DrBalf/domotique_bts_sn_ec_projet/Rapport/img/presentation1.jpg

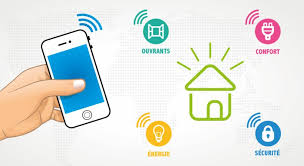
Rapport/img/presentation1.jpg
