DrBalf/domotique_bts_sn_ec_projet/Rapport/Lore/img/maison-bois-domotique.jpg

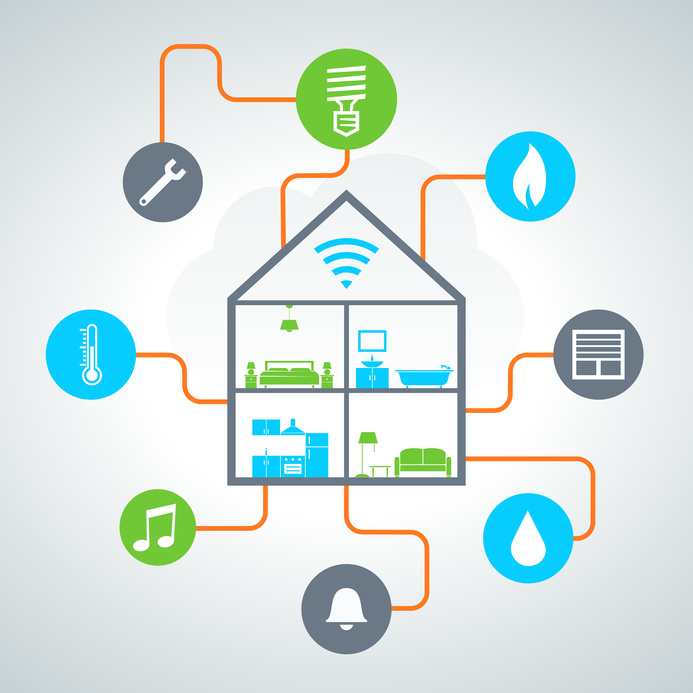
Rapport/Lore/img/maison-bois-domotique.jpg
