DrBalf/domotique_bts_sn_ec_projet/README.md

# domotique_bts_sn_ec_projet
projet d'épreuve final pour le bts système numérique, option : Electronique et communication  

contributeur : Benjamin Guyader - Nicolas Dufresne - Tommy Girard - Aurélien Chauveau
