DrBalf/domotique_bts_sn_ec_projet/Documentation/Seeed-WiKi-master/docs/BeagleBone.md

---
title: BeagleBone Introduction
nointro:
---

---
BeagleBones are relatively a late comer in the microcontroller world, but the high performance and lower power consumption make it become one of the three popular platforms in the open-hardware world. Beagles mean big functionality in small packages because these little PCs can be used for all kinds of applications you've been tinkering with... and can handle many of the same tasks as your desktop PC. Similar to Arduino and Raspberry Pi, Beaglebone boards are used by artists, designers and hobbyists to realize their projects.

BeagleBone boards are wonderful boards, but people on planet Seeed are not satisfied with the current Beaglebone and want to make some differences. Just as what we have done with Seeeduino, we spoke to Beaglebone.org about our thoughts and finally got the chance to create a whole new board together with them, this is how we created Seeed Studio's own Beaglebone, the Beaglebone Green(Short as BBG).

BeagleBone Green is dirived from Beaglebone Black(Short as BBB), if you ever know about BBB , you would know that BBB is like the star board in the beagleboard family, it inherits the tiny size of Beaglebone and adds many good features while the price is much lower. When we were designing BBG, we decided to keep almost all the good features of BBB such as the tiny size, abundant interface and strong expansibility, while at the same time replaced the HDMI interface with 2 Seeed grove connector, to make it compatible with the large family of grove sensers.

Not lone afte that, we released another BeagleBone named BeagleBone Green Wireless(Short as BBGW), In addition to grove connectors, BBGW has included a high-performance flexible WiFi/Bluetooth interface, makes it become the first WiFi/Bluetooth board of the BeagleBone family.

## Product  List
---
Here is the list of the BeagleBone Boards you can find in the Seeed WiKi. The list will be constantly updated.

- [Beagle Bone Green and Grove IoT Starter Kit Powered by AWS](/Beagle_Bone_Green_and_Grove_IoT_Starter_Kit_Powered_by_AWS/)
- [BeagleBone Case](/Beaglebone_Case/)
- [BeagleBone Green](/BeagleBone_Green/)
- [BeagleBone Green HDMI Cape](/BeagleBone_Green_HDMI_Cape/)
- [BeagleBone Green Wireless](/BeagleBone_Green_Wireless/)
- [Grove Base Cape for BeagleBone v2](/Grove_Base_Cape_for_BeagleBone_v2/)
- [Grove Cape for BeagleBone Series](/Grove_Cape_for_BeagleBone_Series/)
- [Grove Starter Kit for BeagleBone Green](/Grove_Starter_Kit_for_BeagleBone_Green/)
- [Motor Bridge Cape v1.0](/Motor_Bridge_Cape_v1.0/)
- [Skeleton box for Beaglebone](/Skeleton_box_for_Beaglebone/)
