DrBalf/domotique_bts_sn_ec_projet/Rapport/Benjamin/ProjetBenjaminGuyader.docx

Lycée Raymond Queneau, BTS SN EC.

18

Rapport

Projet final de BTS

Guyader Benjamin

# Présentation de ma partie

Dans le projet "La maison du futur", nous pouvons relever trois différentes parties

- Le serveur web (étudiant 4)

- l'application mobile (étudiant 3)

- Les capteurs et actionneurs (étudiants 1 et 2) :


tant l'étudiant 1, mon travail se séparait en deux parties :

- Pilotage des volets ainsi que de la lumières :

- Volets Roulants / Capteur de luminosité

- Ampoule

- Mise en place de la sécurité :

- Détecteur d'incendie

-Détecteur de mouvement / Interrupteur

- Module GSM

# Test unitaire : Volet roulant

De plus en plus de maisons sont équipées de volets roulants, c'est le cas de notre maquette. Il est possible de les piloter via la tablette ou grâce aux boutons présents sur la carte.

Dans un premier temps à l'aide d'un schéma de la carte électronique du volet roulant j'ai recherché les broches utiles pour son usage dans notre projet :

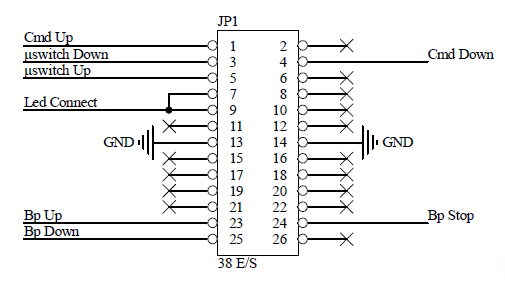
[picture p77: figure]

Sur ce schéma j'ai fais apparaître uniquement les broches de la carte que j'utilise dans le projet.

Ces broches sont les suivantes :

- cmdUP : Broche qui permet la montée des volets lorsqu'elle est à un niveau logique HAUT (5V).
- CmdDown : Broche qui permet la descente des volets lorsqu'elle est à un niveau logique HAUT (5V).
- µswitchUP : Cette broche a un niveau BAS lorsque le volet arrive en fin de course vers le haut.
- µswitchDown : Cette broche passe à un niveau BAS lorsque le volet arrive en fin de course vers le bas
- GND

Pour comprendre le fonctionnement des broche µswitchUP et µswitchDown, j'ai utilisé un voltmètre pour déterminer leurs états en fonction de la position du volet pour pouvoir adapter mon code :

J'ai relié toute ces broches sur celles numériques d'une carte Arduino uno.

Pour vérifier le bon fonctionnement de ces volets, j'ai fais un programme qui permet que, lorsque l'on envoie "1" sur le moniteur série Arduino, le volet s'ouvre et, lorsque l'on envoie "2", le volet se ferme.

Ce test sur les volets roulants m'a permis de vérifier leurs bons états de marche mais également de comprendre le fonctionnement de la carte électronique.

# Test unitaire : capteur de luminosité

Pour faciliter la vie de l'utilisateur, un mode automatique est ajouté aux volets Roulants. Ces derniers seront influencés par un capteur de luminosité.

Le capteur TSL2561 a une plage de mesure allant de 0,1 à 40 000 lux, il est également adapté à un positionnement extérieur grâce à sa plage de température qui supporte un grand froid de -30 °C à une température chaude de 80 °C.

La communication avec ce capteur se fait en I2C, donc à l'aide de 3 fils : le SDA, le SCL et le GND. Pour le fonctionnement de ce capteur, 4 fils étaient donc nécessaires. Pour ma part, c'est le seul module qui doit être alimenté en 3,3 V.

Pour vérifier son bon fonctionnement, j'ai récupéré une bibliothèque sur GITHUB et j'ai fais un programme qui permet simplement de récupérer la luminosité en lux chaque secondes.

# Test d'intégration : Volet roulant / capteur de luminosité

Ce regroupement à pour but de tester le volet roulant lorsqu'il est en mode automatique, c'est à dire que lorsqu'on passe au-dessus d'un certain seuil de luminosité (35 lux pour le test) le volet s'ouvre :

Et à l'inverse si on descend en dessous d'un certain seuil (10 lux pour le test), le volet se ferme :

# Test unitaire : Lumière

L'application mobile ne pilote pas uniquement les volets roulants, deux boutons sont affectés à la gestion de la lumière.

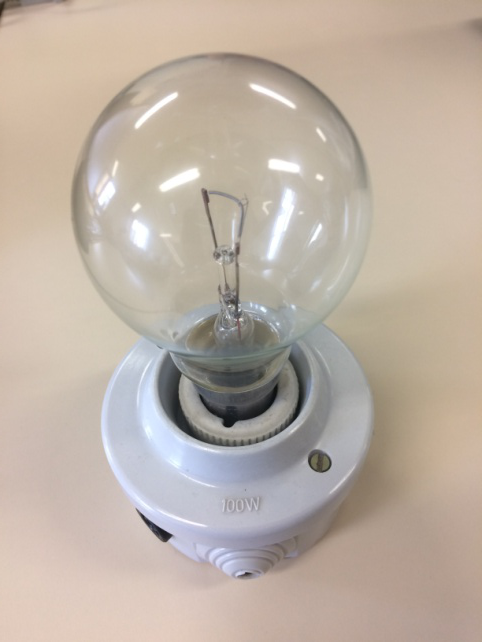
[picture p78: figure]

Il n'est pas possible de piloter une lumière avec une carte Arduino directement. Pour pouvoir piloter le faire, il faut utiliser un relais qui va nous permettre de dissocier la partie puissance de la partie commande.

Le schéma ci-dessous montre la composition du relais ainsi que son branchement avec la lumière et le microcontrôleur.

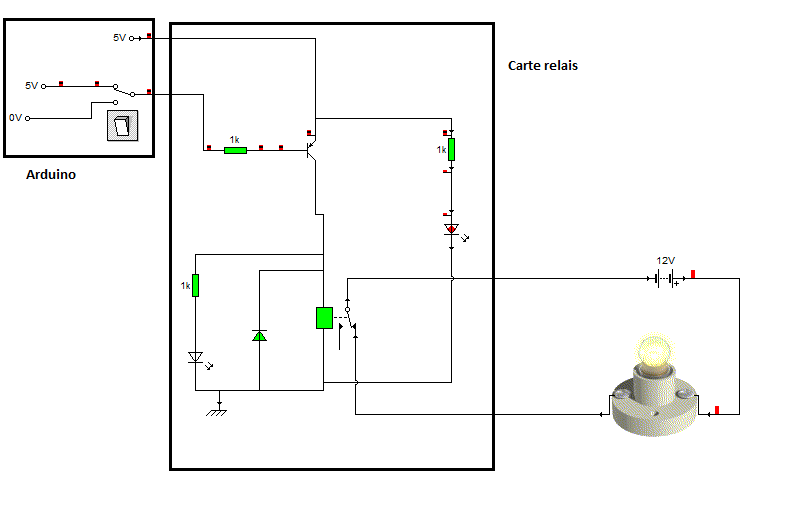
[picture p79: figure]

Pour que la lumière soit allumée

- On doit avoir du courant dans la bobine

- Le transistor doit être passant

- On doit donc appliquer 1 sur la sortie de la Arduino

# Test unitaire : Détecteur de mouvement

Lorsque l'utilisateur n'est pas chez lui, il doit être averti en cas d'intrusion. C'est pour cela que le système de sécurité est muni d'un détecteur de mouvement.

ce détecteur est constitué d'un capteur à infrarouge détectant les mouvement d'une personne ou d'un animal. Il a un angle de détection de 120° et sa distance de détection va jusqu'à 6 mètres.

Trois broche le font fonctionner :

- Une alimentation de 5V qui permet un branchement facile sur une carte Arduino.
- Une broche de donnée que l'on pourra brancher en entrée numérique sur une carte Arduino.
- GND

Pour tester le bon fonctionnement de ce capteur j'ai d'abord effectué le branchement sur une carte Arduino Uno.

J'ai ensuite créé une fonction retournant un booléen permettant de récupérer l'état de la broche de donnée.

J'ai affiché sur le moniteur série la valeur de retour de la fonction :

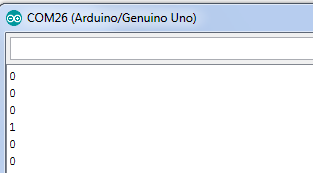
[picture p80: figure]

Lorsqu'un mouvement est détecté, la fonction renvoie bien "true".

# Test d'intégration : Interrupteur / détecteur de mouvement

L'utilisateur doit évidemment pouvoir désactiver le détecteur lorsqu'il est chez lui, c'est pour cela que l'on ajoute un interrupteur. Pour ce projet, un simple bouton fait office d'interrupteur :

C'est un bouton poussoir momentané, lorsqu'il est pressé il émet un signal HIGH et lorsqu'il est n'est pas pressé LOW. Pour pouvoir l'utiliser dans notre projet il y aura quelque particularité dans le code, il faudra utiliser une interruption.

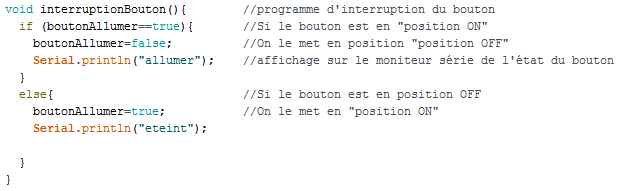
[picture p81: figure]

Pour utiliser une interruption on ne peut pas se mettre sur n'importe quelle broche. Sur une carte UNO, uniquement 2 broches permettent d'utiliser l'interruption : la 2 et la 3.

J'ai regroupé le code de l'interrupteur avec celui du détecteur de mouvement puis j'ai effectué le branchement :

Lorsque l'on appuie sur le bouton on active ou on désactive l'alarme en ajoutant simplement une condition devant le message de détection :

# Test unitaire : Détecteur d'incendie

Le système de sécurité comprend également un détecteur de fumée qui est constamment en marche contrairement au détecteur de mouvement.

Le principe du fonctionnement de ce capteur est basé sur une transmission infrarouge entre une diode et une photodiode. Si de la fumée passe entre l'émetteur et le récepteur, cela va créer de l'opacité qui va atténuer le signal reçu par la photodiode.

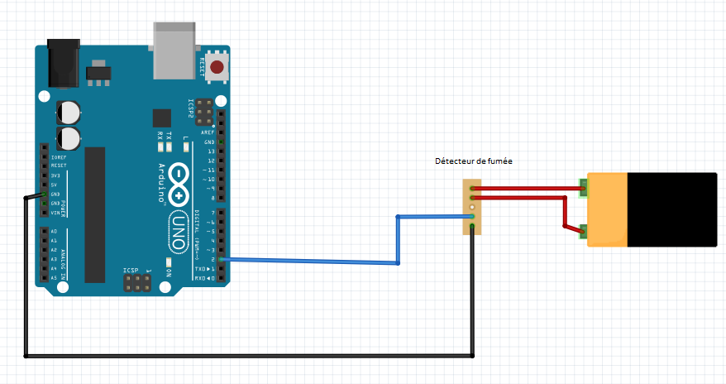
[picture p82: figure]

# Test unitaire : Module GSM

Le module GSM permet d'envoyer un message à l'utilisateur en cas de détection d'incendie ou d'intrusion.

Avant de pouvoir tester son fonctionnement, nous avons acheté une carte SIM prépayé chez Lebara Mobile qui convient bien pour son utilisation dans le projet.

J'ai dans un premier temps envoyer différentes commande à l'aide du moniteur série Arduino.

J'ai vérifié la présence de réseau avec la commande AT+CREG?.

Avant de préparer un SMS il y a deux commandes AT à rentrer :

- AT+CMGF=1 Pour passer en mode texte.

- AT+CSCA="+33660003000" L'adresse du serveur qui dans notre cas est celle de Bouygues.

Après avoir rentrer le numéro du destinataire (AT+CMGS="numéro").

Après avoir rentré cette commande il faut écrire le message et terminé par un "CTRL+Z" or sur le moniteur série on ne peut pas.

Pour pouvoir envoyer un message, il nous faut donc un code qui rentre automatiquement les commandes AT nécessaire :

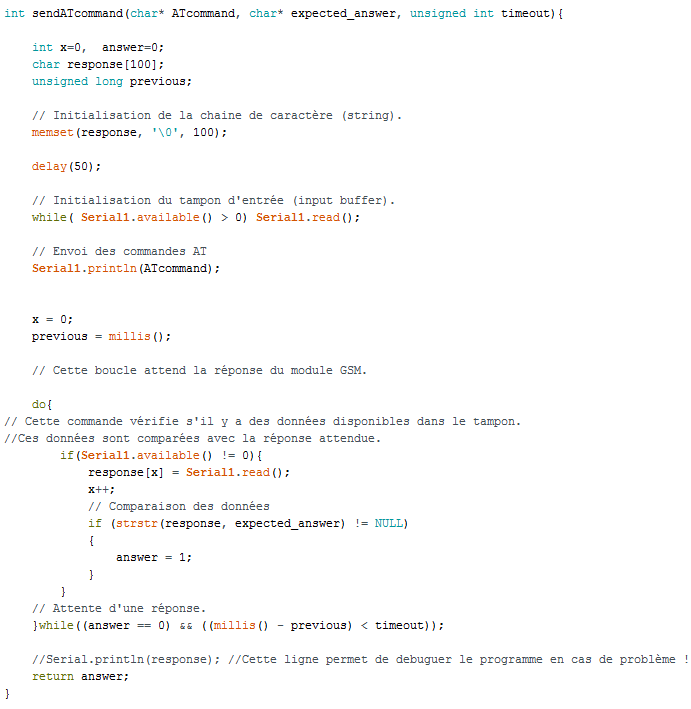
[picture p83: figure]
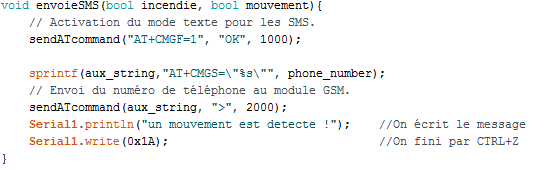
[picture p84: figure]

# Test d'intégration : Module GSM / Interrupteur / détecteur de mouvement / Détecteur d'incendie

Dans ce regroupement on va retrouver tout les composant qui constitue la partie sécurité, le module GSM permet d'envoyer un SMS dans le cas où le détecteur de mouvement (si il est en marche selon l'état du bouton) ou le détecteur d'incendie prévient un danger.

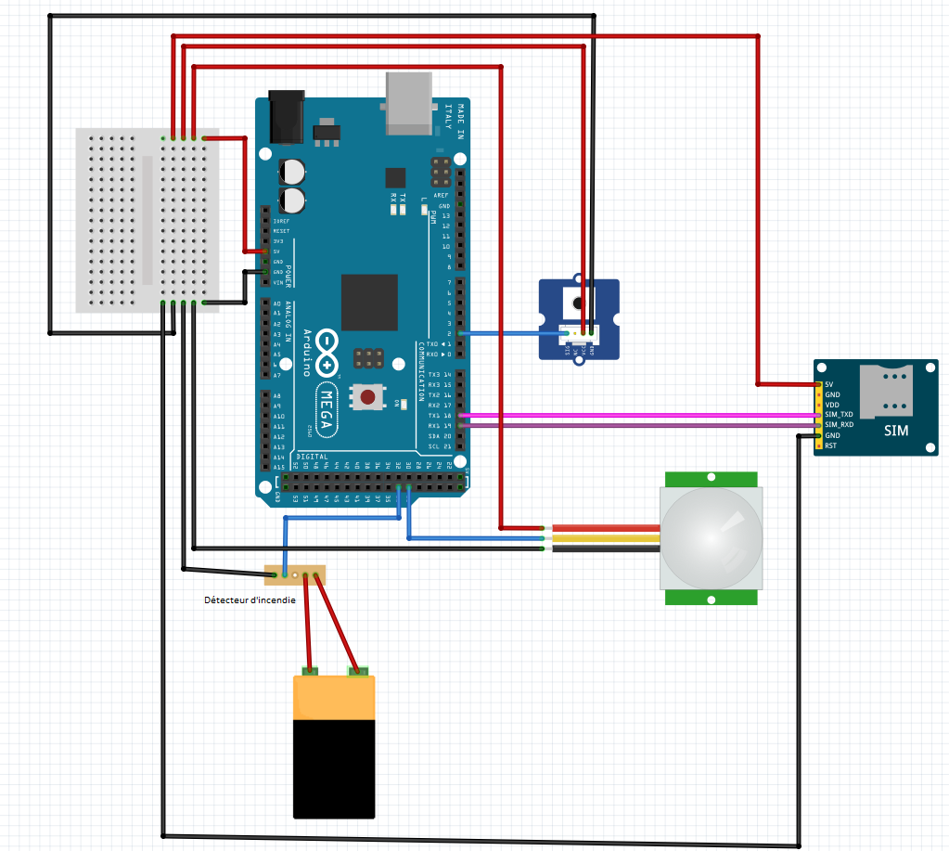
[picture p85: figure]

Le problème de ce programme est que l'on reçoit trop de message en peu de temps. Pour éviter ce "spam", lors du regroupement on a décidé de rajouter un condition avec un booléen qui change d'état en même temps que l'on envoie la trame toutes les 10 secondes.

# Test d'intégration final : Module GSM / Interrupteur / détecteur de mouvement / Détecteur d'incendie / Lumière / Volet roulant / capteur de luminosité

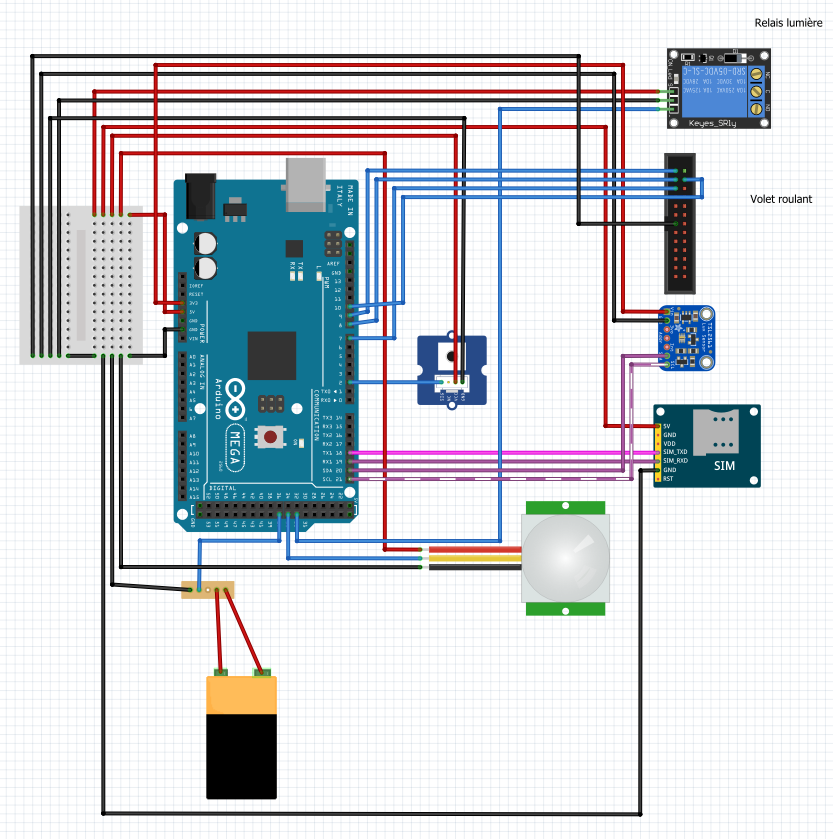
[picture p86: figure]

# Conclusion :

Durant ce projet, le travail en équipe était primordial. Pour chaque capteurs, chaque actionneur, il fallait obligatoirement communiquer avec l'étudiant qui s'occupait de l'application mobile. Nous pouvions tester le fonctionnement de sa partie avec la mienne à chaque test unitaire.

L'organisation des fichiers, l'utilisation de GITHUB sont des éléments qui ont permis de finaliser le projet dans les temps.

## Les évolutions possibles :

Pour la partie sécurité, des modifications sur l'activation/désactivation de l'alarme peuvent être effectuées :

- Remplacer l'interrupteur par un clavier matricielle.

- Isoler le module GSM pour éviter les perturbation qui parfois perturbe l'envoi d'un SMS.
