DrBalf/domotique_bts_sn_ec_projet/Rapport/Lore/Projet_final_BTS_SN.docx

Projet final BTS SN

La maison du future - Domotique

Chauveau Aurélien

# 1 - LES TESTS UNITAIRES

# LE THERMOMÈTRE :

Résultat de recherche d'images pour "bmp180"

Le capteur de pression BMP180 étant équiper d'un capteur de température, nous l'avons donc utilisé pour notre projet. J'ai par la suite récupéré une bibliothèque sur GITHUB[^1] pour commander le capteur. J'ai, ensuite, relier le BMP180 à une carte Arduino, créé un code simple et inclue la bibliothèque à mon code pour réaliser des tests. La communication entre la carte Arduino et notre capteur se fait par I2C.

## Valeur obtenue

## Montage

## Code de test unitaire

Le capteur fonctionne bien, mais il est très sensible à la chaleur qu'on lui transmet lorsqu'on le touche. Il prend très vite 1degrés en 1sec jusqu'à 6-7 degrés en 10sec.

# L'HYGROMÈTRE :

Résultat de recherche d'images pour "HIH6130"
Résultat de recherche d'images pour "sparkfun level converter schematic"

Un hygromètre est un capteur qui sert à mesurer le taux d''humité dans l'aire. Pour cela nous allons utiliser le capteur HIH6130 qui sert aussi de thermomètre et une bibliothèque trouver sur GITHUB pour gagner du temps. Nous allons aussi avoir besoin d'un convertisseur de tension, qui nous servira à ne pas cramer notre capteur d'humidité/température avec le bus I2C qui fonctionne en 5V alors que notre HIH6130 reçois du 3,3V.

## Montage du système

## Convertisseur

## HIH6130


Le convertisseur nous permet de passer de 5V à 3,3V pour passer de la carte Arduino au capteur et vis versa.


Le code de test unitaire ma permit de vérifiez les valeurs de température du capteur qui sont correct. Nous allons donc plutôt utiliser le HIH6130 pour pouvoir a la fois récupérer la température et le taux d'humidité au lieu d'avoir deux capteurs distinct.

## Valeur obtenue

## Code de test unitaire

# CAPTEUR DE QUALITE D'AIR :


Le capteur de qualité d'aire est branché en analogique a la carte Arduino. On récupère les informations du "Air Quality Sensor" avec l'aide d'une bibliothèque ajouter a notre programme. Ce dernier nous renvoie 0 (haute pollution),1,2 ou 3(aire pure).

## Capteur de qualité d'air

## Montage du système


## Code de test unitaire

## Valeur obtenue

# CARTE SD :

La carte SD nous servira à sauvegarder les données du compteur d'énergie. Pour cela il ma fallut apprendre à lire et a écrire dans une carte SD via une carte Arduino. Un article de Hackable magazine à fait un tutoriel à ce sujet, j'ai donc suivi le tutoriel afin de réaliser mon objectif. Il fallait aussi relier la carte SD à la carte Arduino, nous avons donc pour cela utilisé un "MicroSD card Adapter".


## Montage du système


## Code de test unitaire

## Valeur obtenue

11 toto.txt : 11 correspond au nombre d'octet dans le fichier nommé toto.txt

# LE RADIATEURS :


Pour contrôler le radiateur avec une carte Arduino il nous faut un relais qui nous permettre de contrôler avec le 5V de la carte, le radiateur qui est alimenter en 230V sur le réseaux EDF.

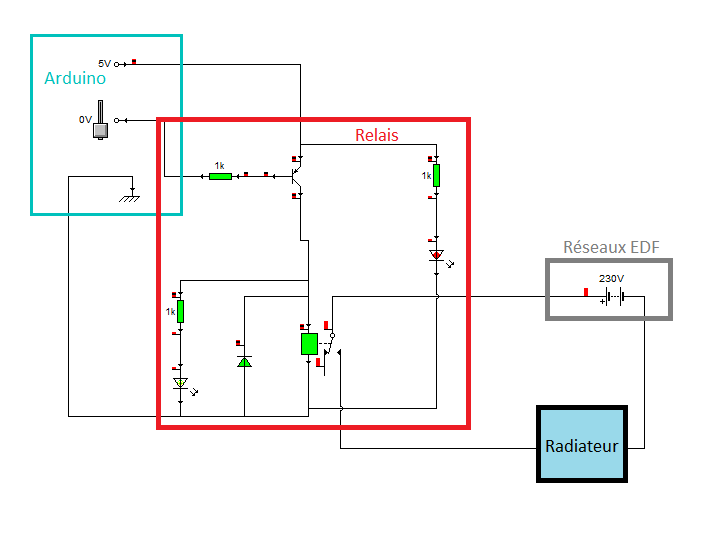
[picture p87: figure]

Le schéma si dessus nous montre comment est relier la carte au CMS qui permette de contrôler le relais.

## Montage du système

Le radiateur est éteint

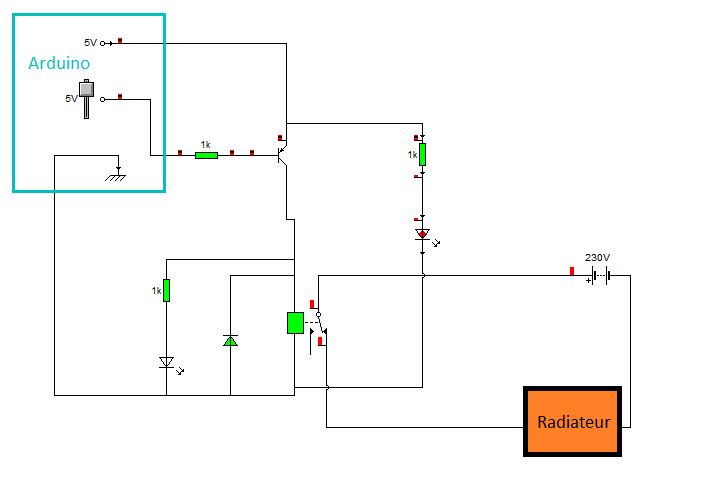
[picture p88: figure]

## Montage du système

Le radiateur est allumé


## Valeur sur l'interface

## Code de test unitaire

# LE MODULE RTC :


L e module RTC est un module qui permet de gérer l'heure, même quand le système n'est pas sous tension grâce a une petite pile. Pour le faire fonctionner j'ai fait appel à une bibliothèque sur GitHUB. Avec les méthodes j'ai donc créé un mini programme donnant l’heure qui nous servira pour l'horodatage de donné de consommation.

## Valeur obtenue

## Code de test unitaire

## Montage du système

# COMPTEUR ELECTRIQUE :

Avec le compteur électrique nous allons pouvoir récupérer le nombre de KWh que le radiateur va consommer. Il délivrera une impulsion tout les 100Wh que nous allons récupérer avec la carte Arduino.

J'ai pour cela utiliser la pin 2 de la carte car elle est la seul pin avec la numéro 3 a posséder une interruption externe. Ensuite nous avons utilisé la résistance de pull-up interne de la pin 2 afin de ne pas avoir à monter le composant sur une carte.


## Code de test unitaire

Le délai est de 50 sec se qui correspond a la moitié de la durée de l'impulsion générer par le compteur en suite on revérifie l'état de la broche. Cette opération nous permet d'être insensible aux perturbations électriques.


Voici à l’oscilloscope, l’impulsion généré par le compteur électrique :

## Montage du système


# 2 - REGROUPEMENT DES COMPOSANTS

Maintenant que tout les teste unitaire son fait nous pouvons regrouper les composant sur une seul carte et les codes dans un seul fichier.

# LA CARTE SSD, LE MODUL RTC ET LE COMPTEUR ÉLECTRIQUE :

## Montage du système


## RTC

## SSD


## .h du regroupement


## Code principale du regroupement.


Une des utilités d’exécuter le programme d’interruption dans le loop, est que cela évite les conflits d’interruption. Car la bibliothéque qui nous sert à horodater utilise aussi une interruption, donc si nous avions exécuté la fonction horodatage dans le programme d’interruption il y aurais eu conflit d’interruption (une interruption dans une interruption).

## .cpp partie 1 du regroupement


## .cpp partie 2 du regroupement

Dans cette partie nous avons regroupé tout se qui concerne l'horodatage de la consommation électrique. Le compteur crée une impulsion à la quelle on ajoute une date, une heure et une valeur en Watt/h, puis cette trame est sauvegardée sur une carte SD dans un fichier texte (.txt).

# LE TERMOMÉTRE, l'HYGROMÉTRE, LE CAPTEUR DE QUALITE D'AIR ET LE RELAIS :

## Montage du système


## RELAIS

LE RELAIS

## HYGROMÉTRE

## TERMOMÉTRE

## QUALITE D'AIR


## Code principale du regroupement.


## capteur.cpp partie 2 du regroupement

## capteur.cpp partie 1 du regroupement


## capteur.h du regroupement


## capteur.cpp du regroupement


## capteur.h du regroupement

Ici nous avons regroupé les capteurs, et actionneurs de la partie confort. On y récupère la température(°C), le taux d’humidité (%), la qualité de l'aire et on contrôle le relai qui agira sur le radiateur.

# REGROUPEMENT FINAL DES COMPOSANTS :


Une fois la première partie de regroupement réalisée, nous pouvons à présent regrouper la totalité de cette partie en un seul montage et un seul programme. Nous pourrons ensuite regroupée les codes de la partie de l'étudiant 1 avec notre partie.

## Montage du système

## QUALITE D'AIR

## RELAIS

## RTC

Lors du branchement du module SD nous avons changer de pin pour la communication SPI car elle varie en fonction de la carte que nous utilisons.

Arduino UNO : MOSI = 11 / MISO = 12 / SCK = 13 / SS = 10

Arduino MEGA : MOSI = 51 / MISO = 50 / SCK = 52 / SS = 53

Ici nous paramétrons un timer qui nous permettra de récupérer les valeurs et états de nos capteurs et actionneurs.

TCCR2A nous indique que le timer est en mode normale

TCCR2B est le coefficient diviseur de la fréquence du CPU

TIMSK2 nous indique pour que le timer entre en interruption à chaque débordement (Overflow)

sei() : Active les interruption.


Ici notre timer entre en interruption 61 fois

par seconde. Se qui correspond à la lever des drapeaux.

Le premier drapeau se lève toute les 305 débordement

du timer donc toute les 5 sec. Quant au deuxième


drapeau il se lève toute les 10 seconde.

Nous voyons maintenant que les

données sont stockées dans l’objet maison

toutes les 5 et 10 secondes.

Les drapeaux sont remis a zéro ainsi que le compteur, à la fin du programme, lancer par le deuxième drapeau.


Ce morceau du code nous permet de récupérer les données envoyer par la tablette. C’est donné sont des valeurs qui corresponde à une requête soumise par l’utilisateur. Par exemple si la valeur envoyée est 8 nous passons en mode manuelle, si la valeur est 9 nous passons en mode automatique. De cette manière nous pouvons contrôler le mode de fonctionnement du radiateur.

Maison.temperatureUtilisateur prend la valeur choisie par l’utilisateur pour sont chauffage. Ainsi lorsque le chauffage sera en mode automatique le chauffage restera à la température souhaitée.


Ici nous avons le code qui permet de contrôler le chauffage en automatique et en manuelle. On peut remarquer qu’il y a une plage d’hystérésis de 1 degrés qui nous permet de ne pas casser notre relai.


Voici le prototype de l’objets maison. Il sera amélioré par la suite avec l’arriver du code de l’étudiant 1.

Dans cet objet nous avons toutes les variables liées à un capteur ou à un actionneur (sont état, les valeurs qu’il renvoie, son mode de fonctionnement, etc.).

L’heure et la date son aussi sauvegarder séparément pour pouvoir par la suite les envoyer un par un à la tablette ou au serveur Web.

# 3 - REGROUPEMENT DES DIFFÉRENTES PARTIE.


[^1] GITHUB : Service web d'hébergement et de gestion de développement de logiciels.

Projet final BTS SN 2018
