DrBalf/domotique_bts_sn_ec_projet/Rapport/Benjamin/ouicmoi.docx

Test Unitaires

Capteur de luminosité: TSL2561

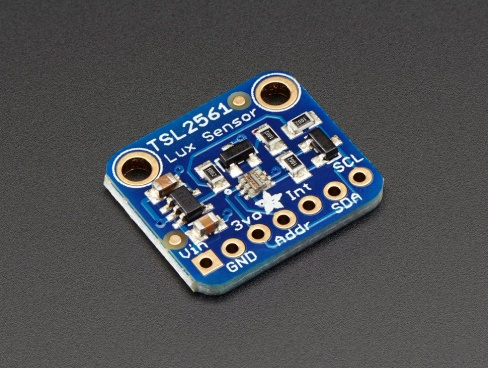
[picture p89: figure]
Résultat de recherche d'images pour "TSL2561"
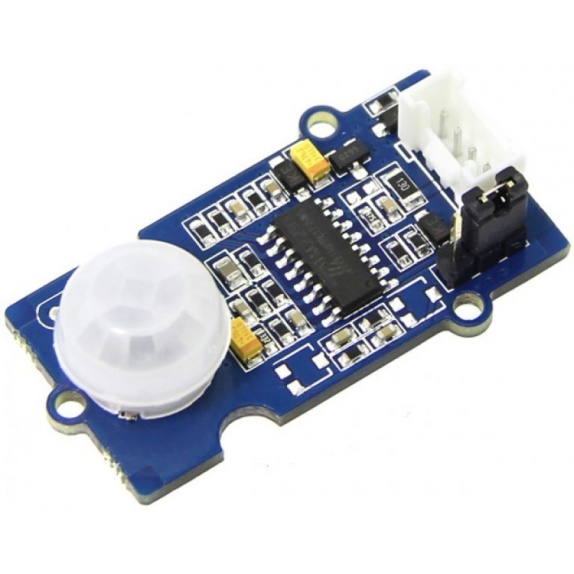
[picture p90: figure]
Résultat de recherche d'images pour "Grove - PIR Motion Sensor"

Capteur de mouvement :

Capteur d'incendie :

Projet BTS SN
