DrBalf/domotique_bts_sn_ec_projet/Logiciels/README.txt

Dossier concernant les parties logiciels du projet domotique : 
	-Application
	-bleutooth 
	-Serveur Web 
	-page web

Lien : 
		- tuto mit app inventor : http://teen-code.com/2016/12/23/creation-dapplications-mobiles-synthese-des-8-tutos-pour-debutants/
