DrBalf/domotique_bts_sn_ec_projet/Materiels/README.txt

Dossier concernant les parties matériels du projet domotique : 
	-capteur
	-ouvrant
	-chauffage  
	-consomation
	-sécuriter
