DrBalf/domotique_bts_sn_ec_projet/Rapport/Partie_commune_domotique.docx

Lycée Raymond Queneau, BTS SN EC.

18

Compte rendu de groupe

Projet final de BTS

Chauveau Aurélien, Dufresne Nicolas, Girard Tommy, Guyader Benjamin.

# Cahier des charges :

## Présentation du projet :

Ce projet est composé de 4 étudiants et a pour objectif de présenter un prototype de maison connectée qui permettra une interaction sur les quatre aspects suivants:

- L'aspect confort avec une commande des lumières et du chauffage (avec différents capteurs et actionneurs) et une mesure de la qualité de l'air.
- L'aspect énergie avec une mesure en temps réel de la consommation.
- L'aspect sécurité avec la détection incendie et une détection de mouvement.
- L'aspect commande des ouvrants (pour gérer l'ensemble des volets par exemple).

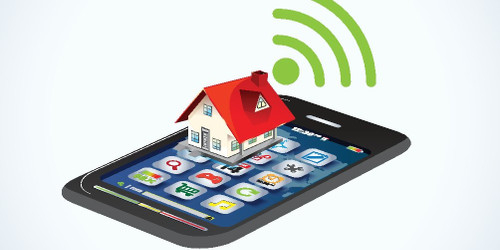
[picture p126: figure]

Ce système permettra donc de suivre en direct via un accès internet l'état de la maison (celle-ci disposera donc d'un serveur Web qui regroupera l'ensemble des paramètres de mesure). De plus en cas d'intrusion ou d'incendie, un SMS sera envoyé au propriétaire. Le système sera également accessible en local grâce à une application disponible sur Smartphone et tablette (équipés d'Android) et une connexion Bluetooth.

## Expression du besoin :

Les étudiants réaliseront un prototype permettant de répondre au cahier des charges suivant :

- La partie du système qui gérera l'aspect confort devra:
  - prendre la mesure de la qualité de l'air.
  - prendre les mesures de températures et d'humidités au sein de la maison.
  - rendre accessible l'ensemble de ces mesures à la fois sur le site web et sur l'application mobile.
  - piloter de façon automatique le chauffage en fonction d'une valeur prédéfinie de la température intérieur (il sera par la suite possible de régler cette température via l'application mobile).
  - permettre via l'application mobile d'allumer ou d'éteindre le chauffage et de commander les lumières.
- La partie du système qui gérera l'aspect énergie devra:
  - prendre la mesure de la consommation électrique via un compteur d'énergie.
  - permettre l'horodatage de cette mesure.
  - sauvegarder cette mesure et l'horodatage sur un support amovible de type SDcard afin de conserver la donnée en cas de coupure de courant ou d'arrêt du système d'acquisition.
  - rendre accessible l'ensemble de ces mesures à la fois sur le site web et sur l'application mobile.
- La partie du système qui gérera l'aspect sécurité devra:
  - grâce à un interrupteur, permettre de mettre en service ou non le système d'intrusion.
  - détecter un incendie.
  - en cas d'intrusion, ou d'incendie, envoyer un SMS avec la nature de l'incident à un numéro prédéfini.
- La partie du système qui gérera l'aspect commande des ouvrants devra:
  - permettre d'ouvrir ou de fermer un ou plusieurs volets électriques grâce à l'application mobile.
  - fournir l'état des ouvrants à l'application mobile et au site web.


  - prendre la mesure de luminosité extérieure et piloter de façon automatique l'ouverture ou la fermeture de volets.

Le système sera donc composé de trois grandes parties :

- Une "centrale de gestion" qui regroupera l'ensemble des capteurs et actionneurs présents dans la maison ainsi que le système numérique de contrôle. Elle possédera également une unité de stockage de type SDcard et un module GSM/GPRS pour l'envoi de SMS.

Cette centrale communiquera dans un premier temps avec l'application mobile en Bluetooth.

Dans un deuxième temps et de façon similaire, elle communiquera également en Bluetooth avec un deuxième système présent dans la maison qui fera office de "serveur web".

- Le "serveur web" présent également dans la maison et qui recueillera les informations (état des volets, des radiateurs, température, humidité, qualité de l'air, ensoleillement, etc.) issues de la "centrale de gestion" de façon cyclique (toutes les 3 secondes) afin de les rendre accessibles au monde extérieur via une application web. Le site web permettra donc uniquement une consultation des différents capteurs présents dans la maison. Pour des raisons de sécurité, il ne permettra pas d'agir à distance sur la maison connectée.
- Une "application mobile" communiquant en Bluetooth avec la centrale de gestion et permettant de recueillir de façon cyclique (toutes les 3 secondes) l'ensemble des informations issues de la "centrale de gestion". Cette application permettra en local (distance de quelques dizaines de mètres par rapport à la centrale de gestion) de piloter une partie de l'installation (demande d'allumage des lumières, commande des volets, mise en service du chauffage, etc.).

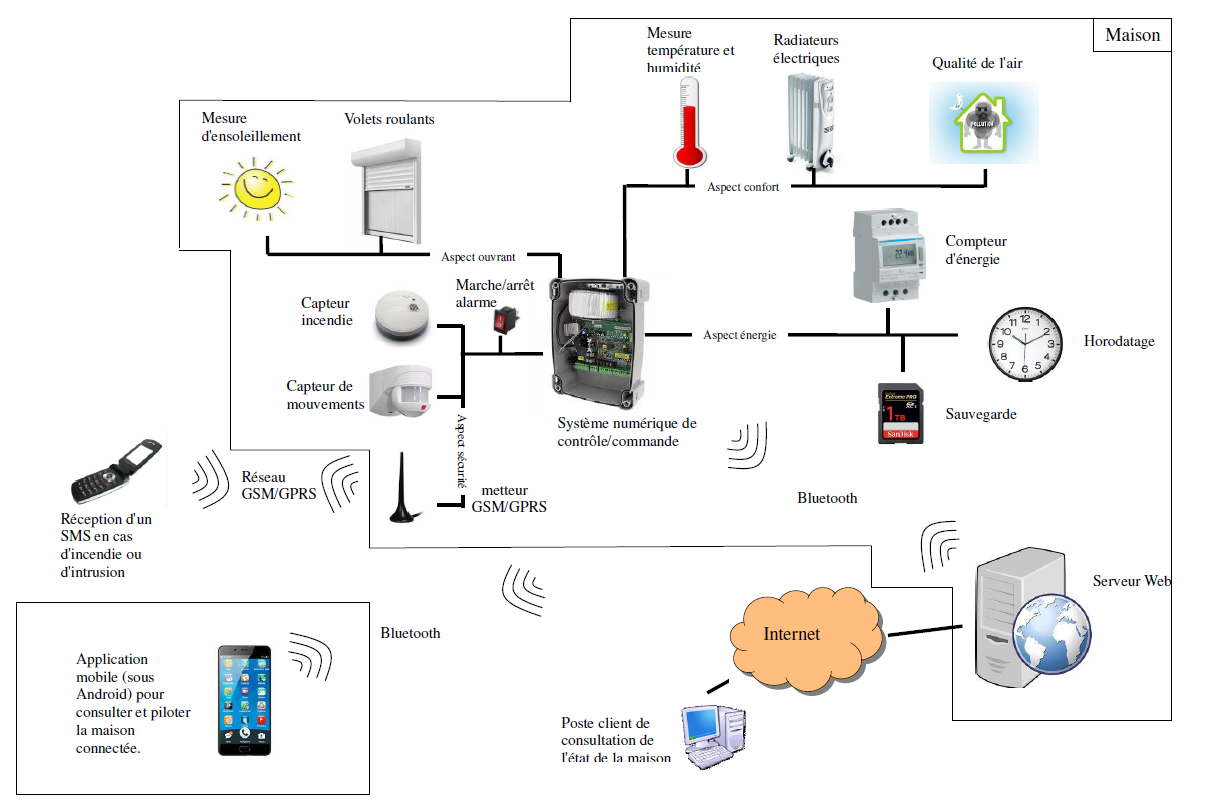
[picture p127: figure]

## Architecture Matériel :

# Analyse fonctionnel :

## Digramme de cas d'utilisation :

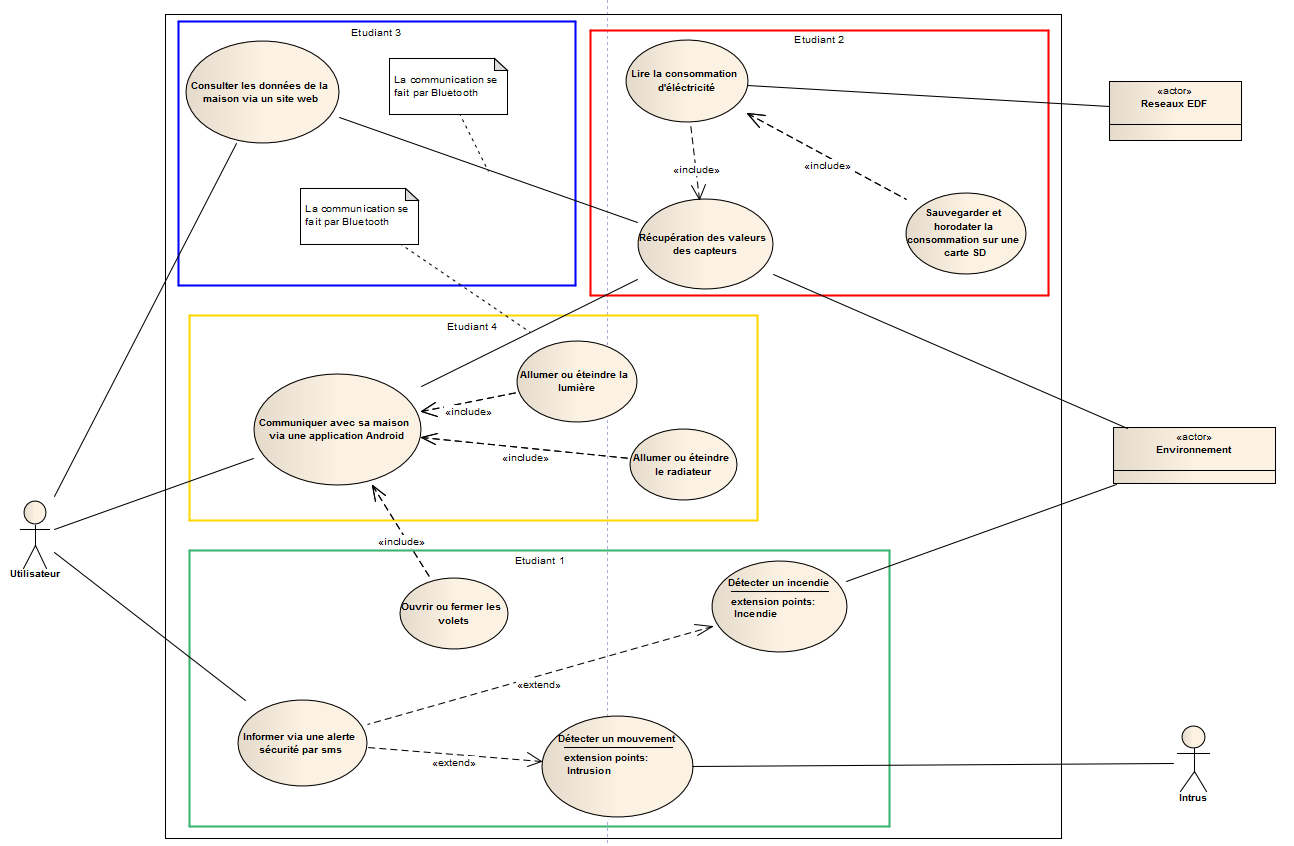
[picture p128: figure]

Un cas d'utilisation représente un ensemble d'actions qui sont réalisées par le système et qui produisent un résultat observable pour un acteur particulier.

## Diagramme d'exigence :

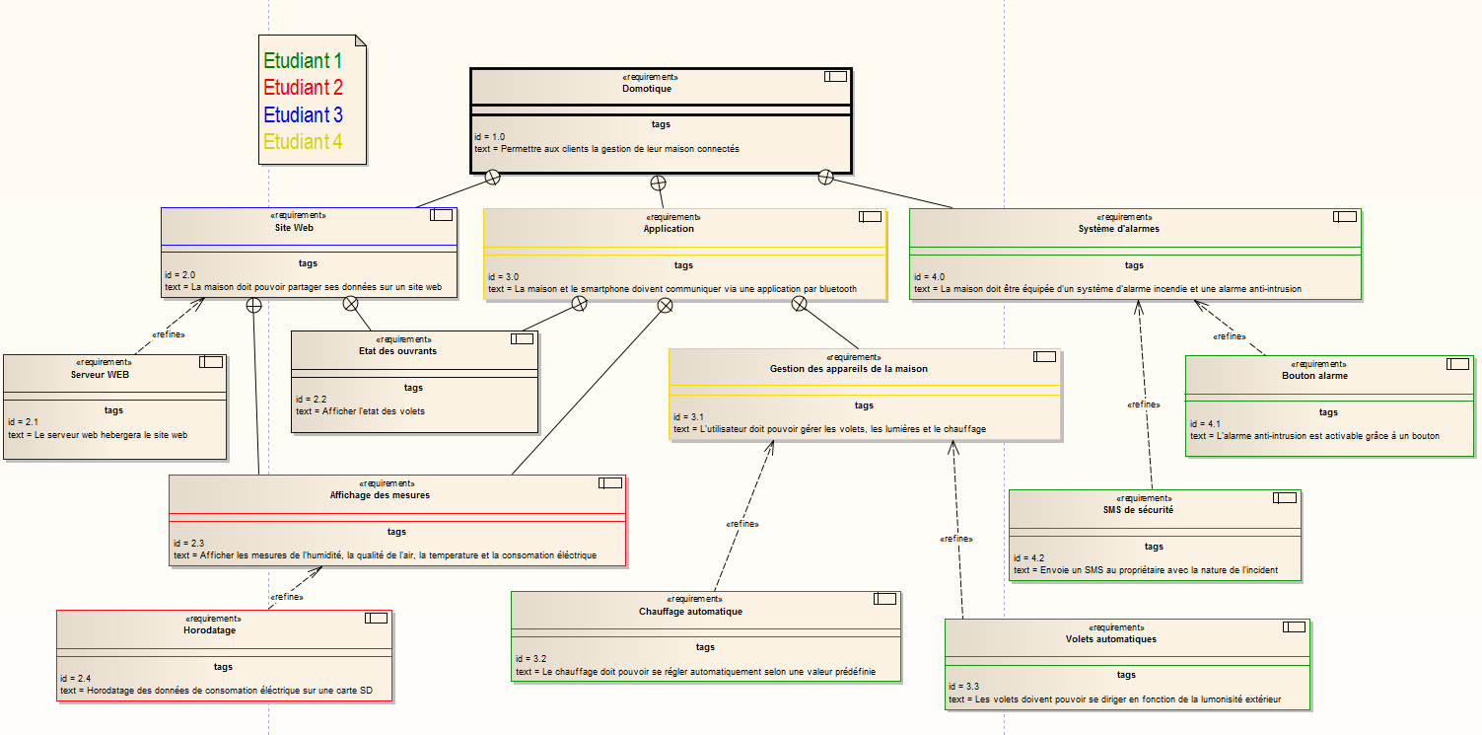
[picture p129: figure]

Ce digramme permet de clarifier les attentes liées au futur système entre le client et le concepteur.

## Diagramme de séquence application :

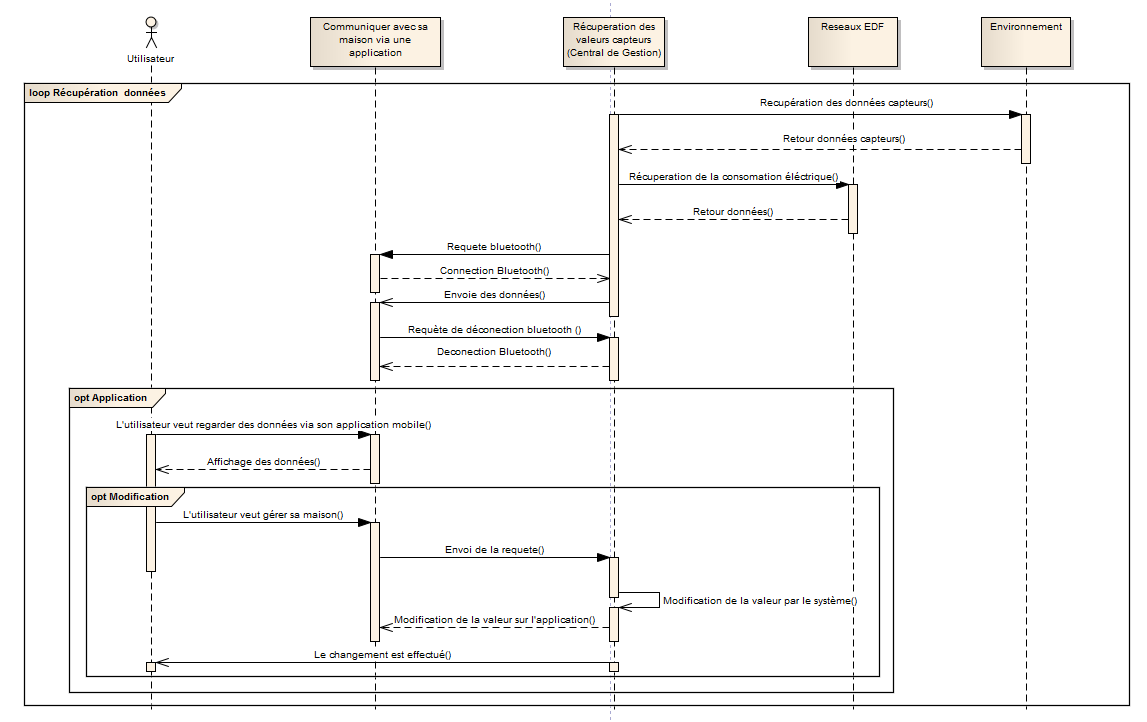
[picture p130: figure]

Le digramme de séquence représente les échanges entre les acteurs et le système, et permet également de détailler les échanges d'informations entre différentes parties internes au système.

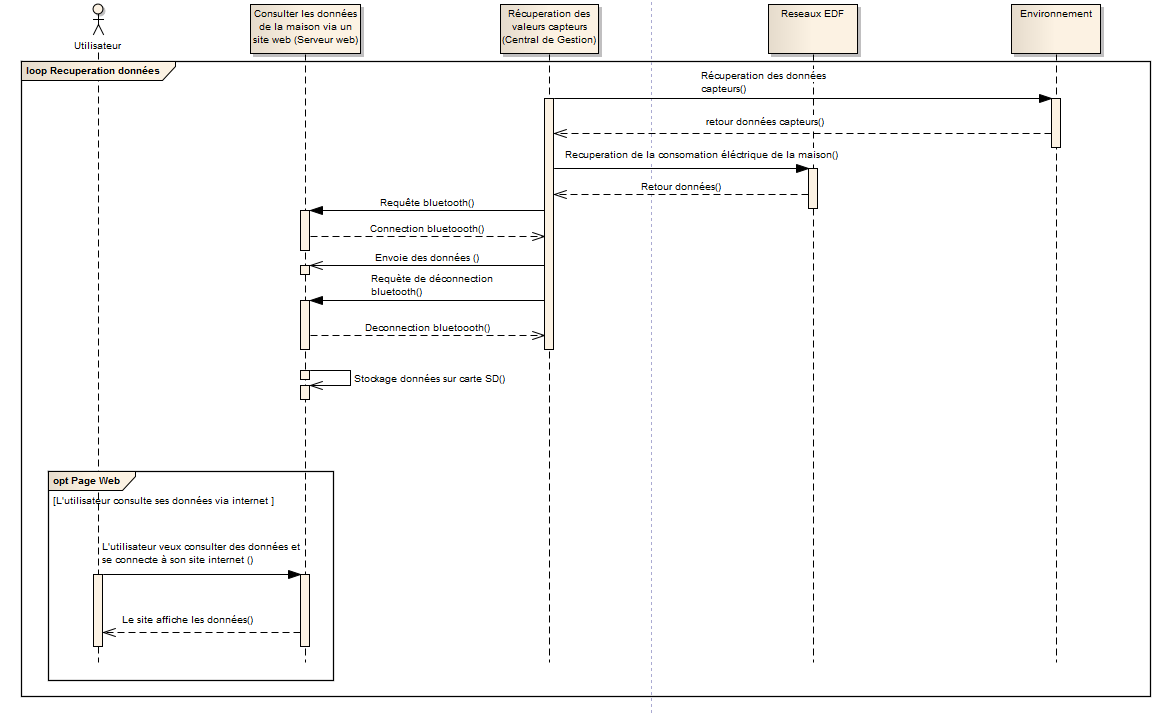
[picture p131: figure]

## Diagramme de séquence web :

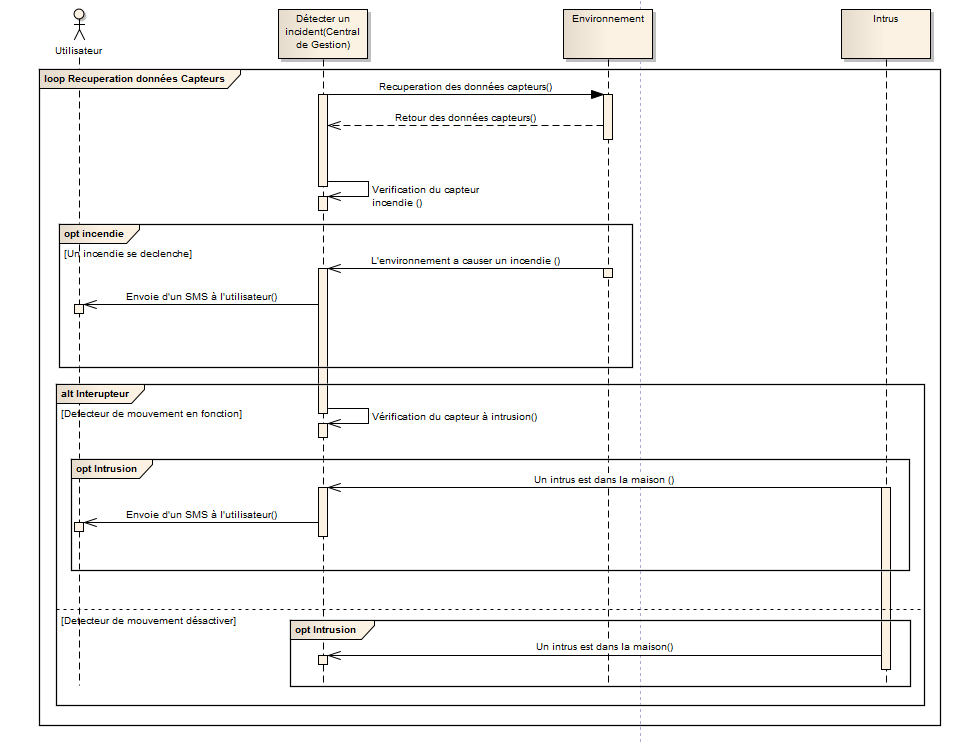
[picture p132: figure]

## Diagramme de séquence sécurité :

# Organisation de groupe :


Le groupe est organisé de la façons suivante :

L'étudiant 1 sera chargé de la gestion des lumières et des volets ainsi que de la sécurité. Cette dernière est équipé d'un détecteur de mouvement, d'un détecteur de fumée et d'un module GSM qui devra envoyer un SMS à l'utilisateur en cas de problème.

L'étudiant 2 sera chargé de la gestion du chauffage, de la gestion de la consommation électrique et de la récupération des informations envoyées par les capteurs. Ses informations devrons être envoyées au serveur web et a l'application mobile.

L'étudiant 3 sera charger de créer un serveur web afin d'y afficher des valeurs utilent à l'utilisateur.

L'étudiant 4 sera charger de créer une application mobile qui permettra de contrôler les actionneurs ainsi que d'afficher des valeurs utile à l'utilisateur.

L'étudiant 1 et L'étudiant 2 devront regrouper leurs codes et ainsi se mettre d'accord pour créer un objet maison dans lequel sera stocké les attributs et les méthodes nécessaires au projet.

L'étudiant 3 et L'étudiant 4 devront travailler ensemble pour mettre en marche la communication bluetooth entre l'application mobile et la centrale de gestion ainsi qu'entre le serveur web et la centrale de gestion.

# Matériels :

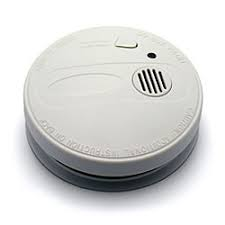
[picture p133: figure]
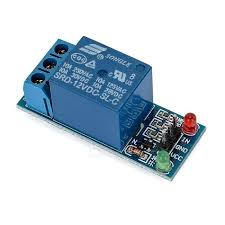
[picture p134: figure]
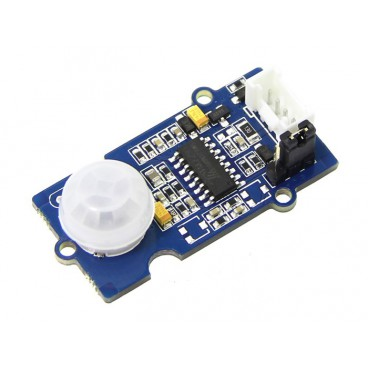
[picture p135: figure]
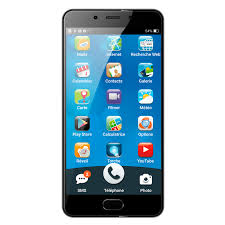
[picture p136: figure]
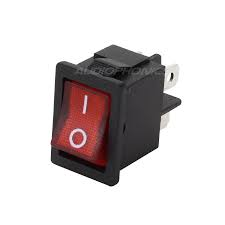
[picture p137: figure]
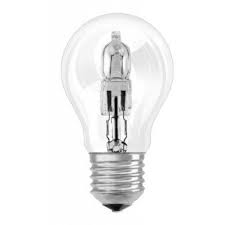
[picture p138: figure]
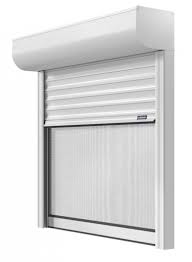
[picture p139: figure]
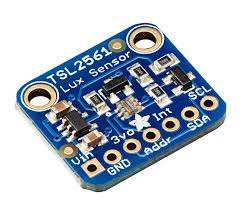
[picture p140: figure]
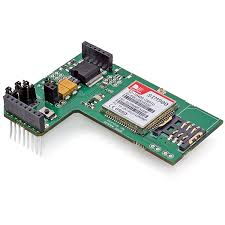
[picture p141: figure]

## Matériel de l'étudiant 1 :

Carte arduino

Logiciel arduino

Bouton d'activation du détecteur de mouvement

Ampoule

Volet roulant

Capteur de lumière

Carte arduino

Module GSM

Relai de contrôle de la lumière

Détecteur de mouvement

Détecteur de fumer

Téléphone

## Matériel de l'étudiant 2 :

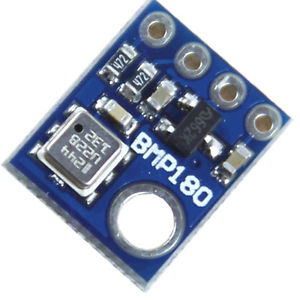
[picture p142: figure]
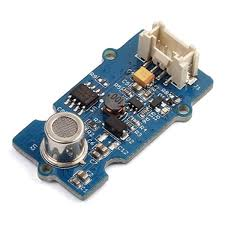
[picture p143: figure]
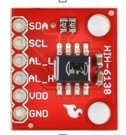
[picture p144: figure]

Capteur d'humidité

Capteur de qualité d'air

Capteur de température

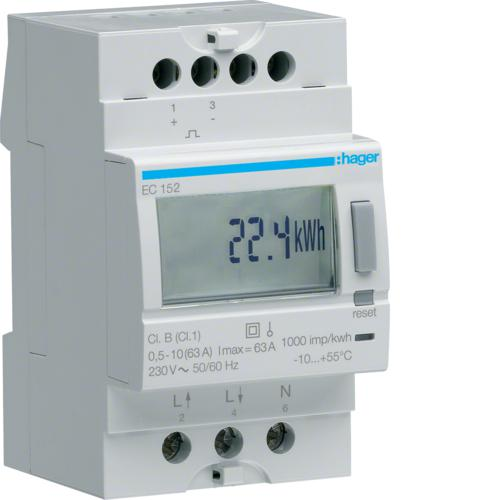
[picture p145: figure]
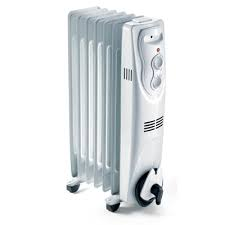
[picture p146: figure]

Compteur électrique

Relai de contrôle de la lumière

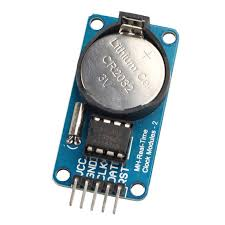
[picture p147: figure]
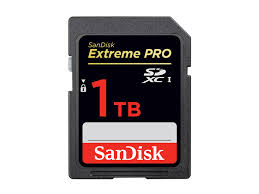
[picture p148: figure]
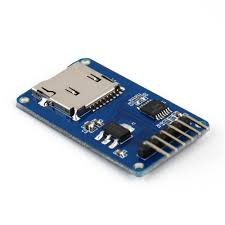
[picture p149: figure]

Radiateur

Carte SD

Adaptateur SD

Module RTC

Carte arduino

Logiciel arduino

## Matériel de l'étudiant 3 :

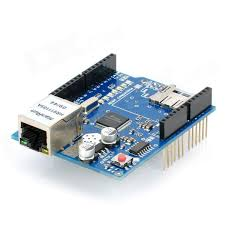
[picture p150: figure]
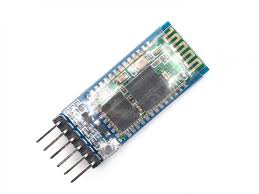
[picture p151: figure]

Shield ethernet

Logiciel arduino

Module bluetooth x2

Carte arduino

## Matériel de l'étudiant 4 :

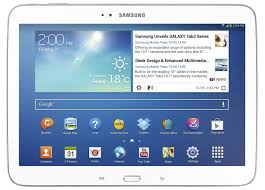
[picture p152: figure]

Tablette

Logiciel arduino

Module bluetooth

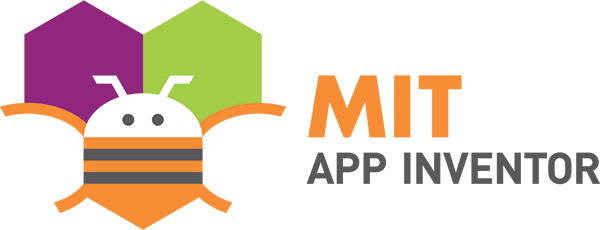
[picture p153: figure]

Mit app inventor 2

Carte arduino

# Protocole :

## Les protocoles d'envoie :

Pour définir les protocoles d'envoies nous nous sommes basé sur le cahier des charges. Ce dernier nous indique que plusieurs valeurs doivent être envoyées à intervalles régulier, les premières valeurs doivent être envoyées toutes les 5 sec et les autres valeurs toutes les 10 sec. Nous envoyons donc une trame toutes les 5 sec avec toutes les valeurs nécessaire actualisé puis toute les 10 sec nous envoyons une trame avec la totalité des valeurs actualisées.

Extrait du cahier des charges

## Les protocoles de trame :

La trame contiendra 14 valeurs séparées de cette manière :

Etat de la lumière / Luminosité / Etat du volet 1 / Etat du volet 2 / Etat du radiateur / Température / Consommation en KwH / Taux d'humidité en % / Qualité de l'air/ Jour / Mois / Année / Heure / Minutes.

Chaque valeur sera séparée par un point d'exclamation. La trame commencera par la première valeur et se terminera par un point d'exclamation :

0!0!0!0!0!0!0!0!0!0!0!0!0!0!

## Les protocoles de codage :

Pour pouvoir réunir nos codes de manières efficace nous avons prévue a l'avance que nous allions exécuter toutes nos fonctions dans des mini programme que nous appellerons depuis une bibliothèque commune.

Nous nous somme donc mis aussi d'accord à sur le nom de nos bibliothèque final afin d'y regrouper nos code de manière logique.

# Journée poster :

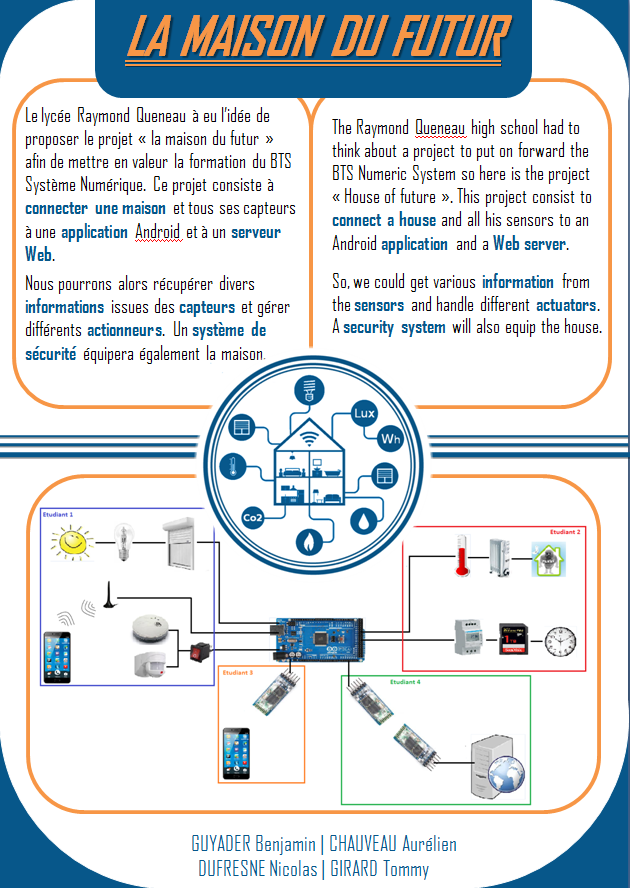
[picture p154: figure]

La journée poster est un événement organisée par le lycée Raymond Queneau. Il consiste ,pour les élèves de STI2D et de BTS, à présenter le projet qu'ils ont réalisés tout au long de l'année à des chefs d'entreprises et à des professionnels dans le domaine de la technologie. Pour cela ils doivent réaliser un poster de grande taille sur lequel ils présentent à l'écrit en français et en anglais leur projet.

Poster du projet : Maison du futur

C'est une expérience qui nous permet de nous améliorer à l'oral et de mieux préparer notre soutenance de fin d'année.

Compte rendu de groupe 2018
