DrBalf/domotique_bts_sn_ec_projet/Rapport/Projet_Domotique_présentation.pptx

## Projet Domotique

Présentation du projet

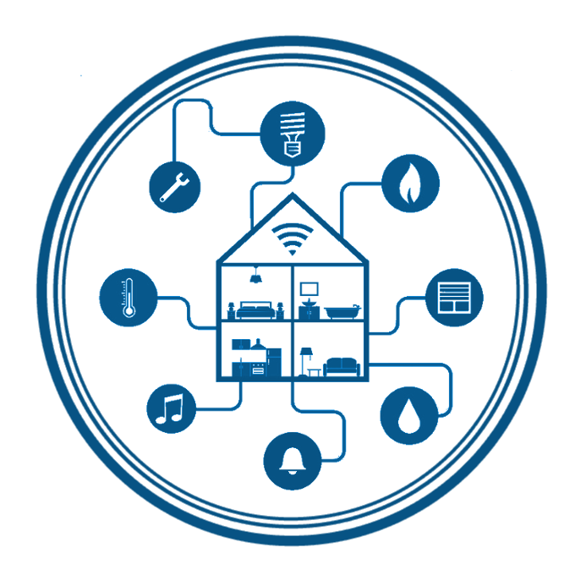
[picture p155: figure]

## Cahier des charges : La maison du Future

Les différents aspect à traiter :
  - Aspect confort
  - Aspect sécurité
  - Aspect énergie
  - Aspect gestion des ouvrants


Les 3 parties principale :
  - Partie centrale de gestion
  - Partie serveur WEB
  - Partie application mobile

## Architecture matériel


## Analyse fonctionnel : Diagramme des exigences

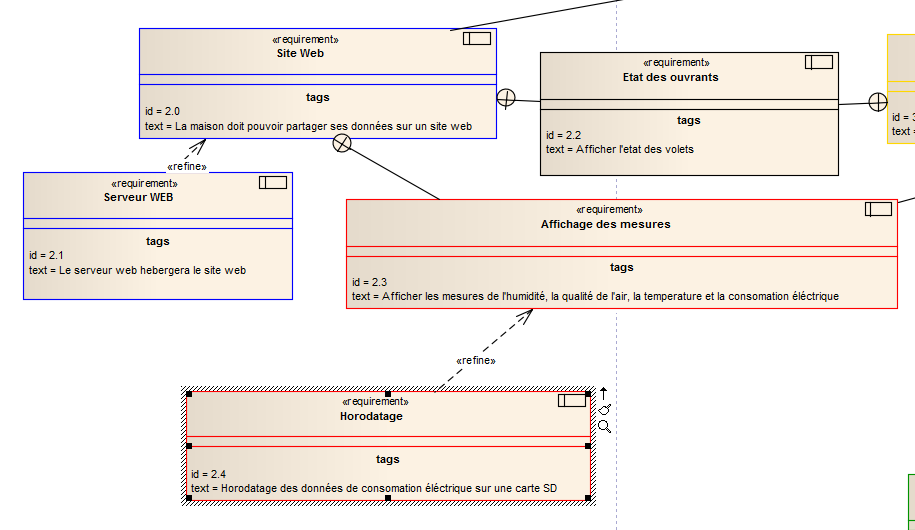
[picture p156: figure]
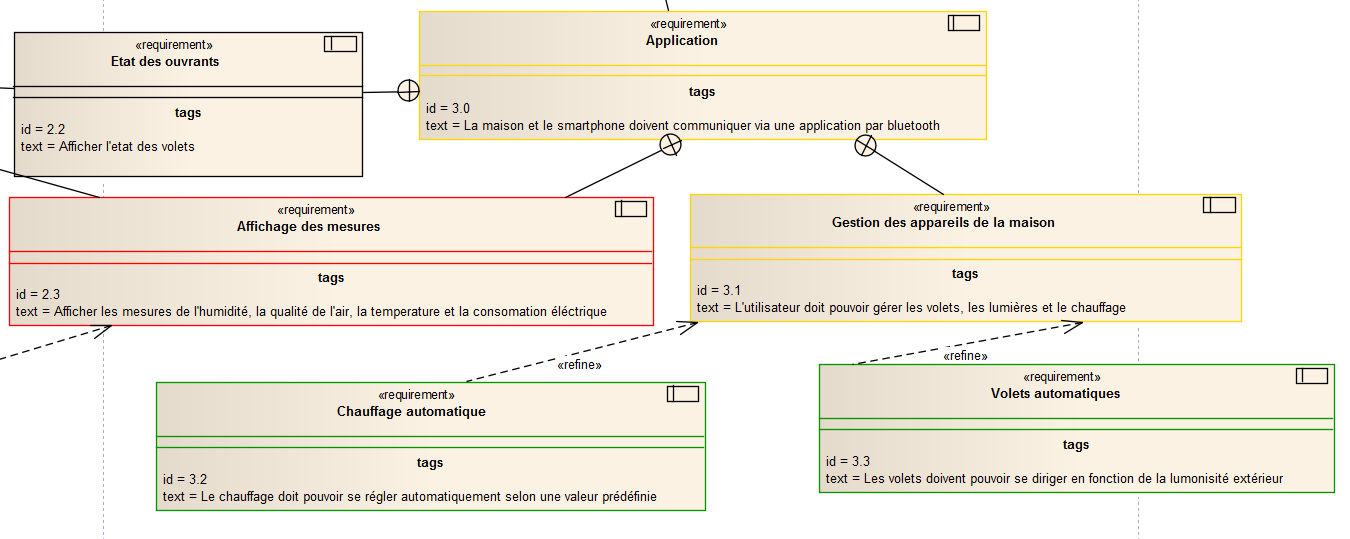
[picture p157: figure]
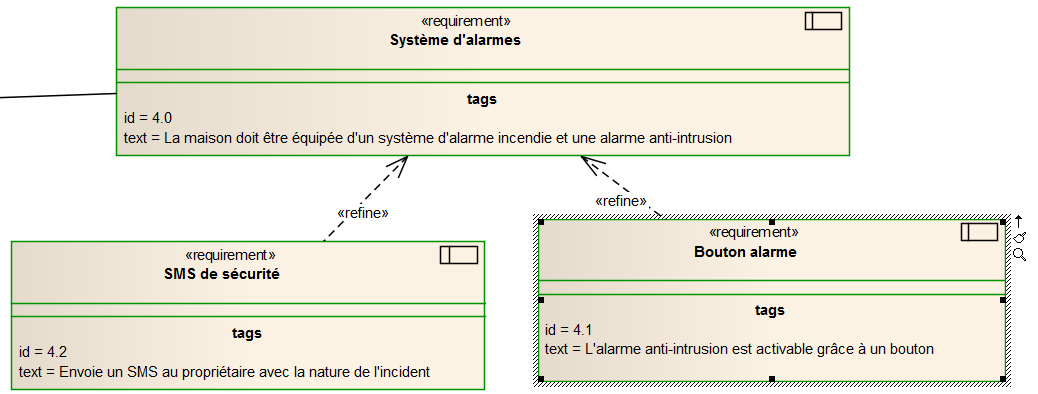
[picture p158: figure]

## Slide 5

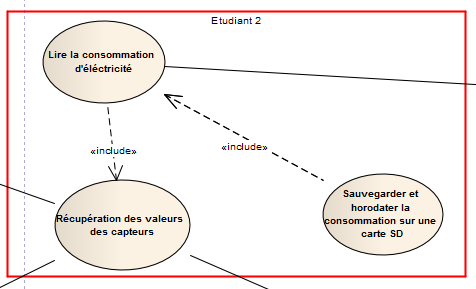
[picture p159: figure]

Diagramme de cas d’utilisation :

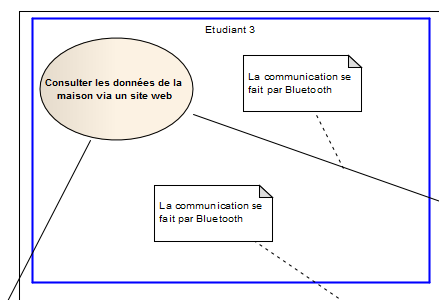
[picture p160: figure]
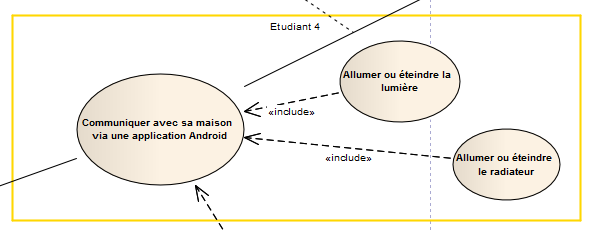
[picture p161: figure]
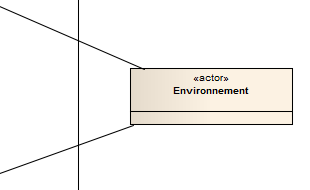
[picture p162: figure]
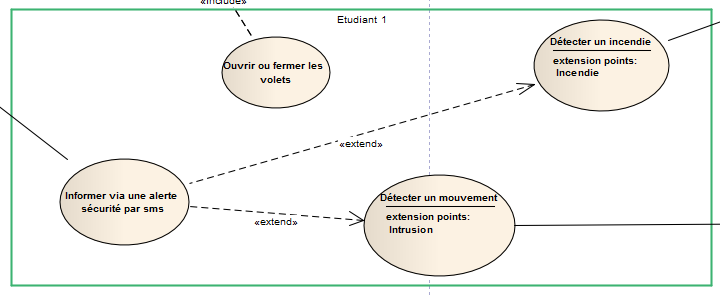
[picture p163: figure]
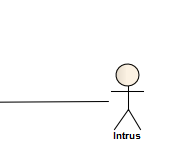
[picture p164: figure]

## Scénario d’alerte sécurité

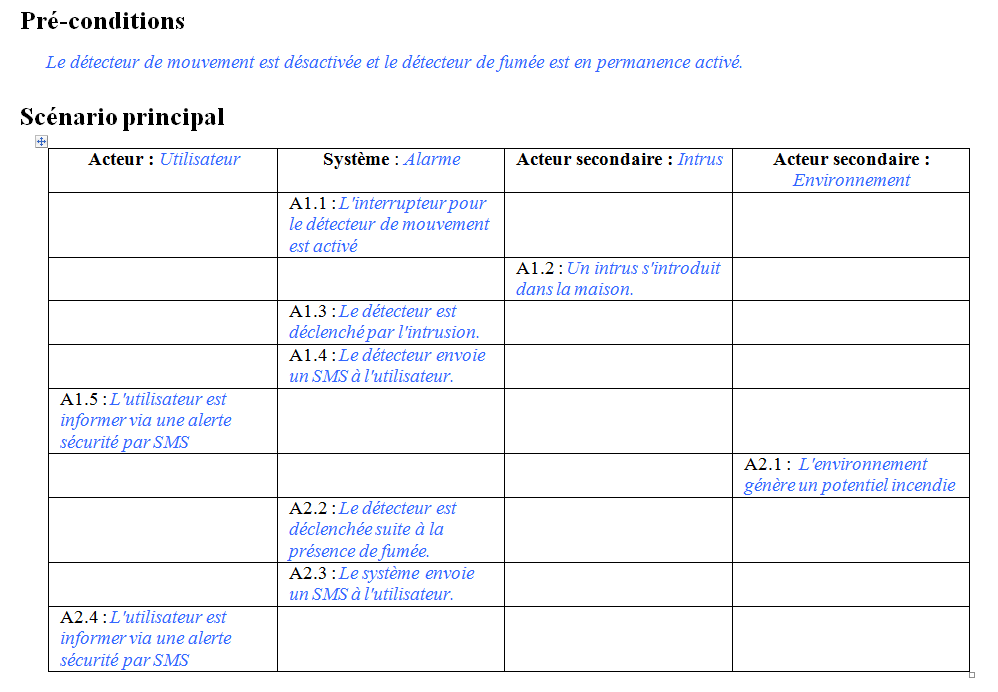
[picture p165: figure]

## Scénario d’application

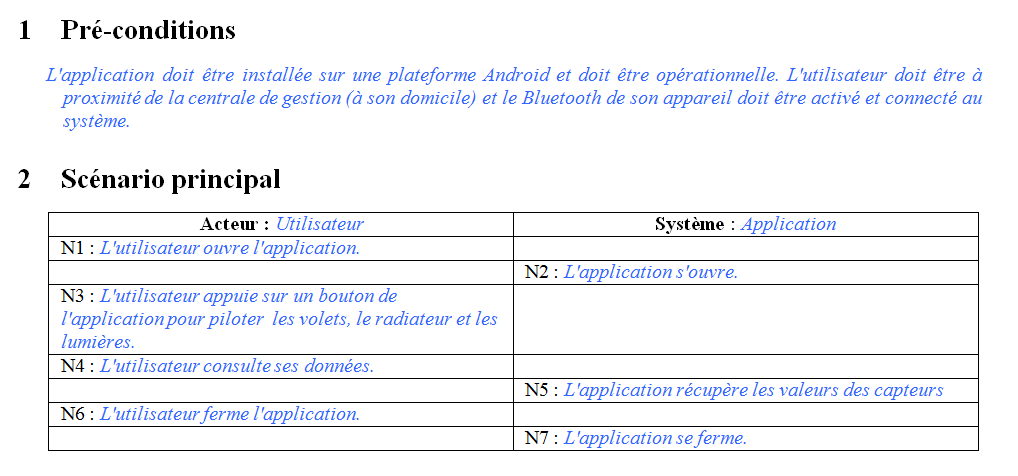
[picture p166: figure]

## Scénario serveur web

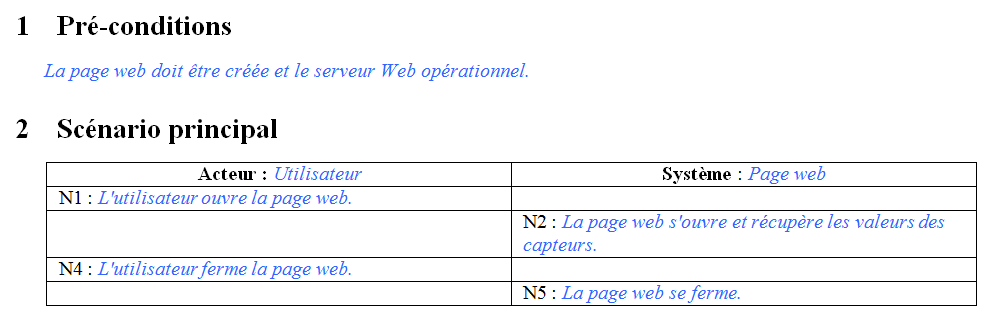
[picture p167: figure]
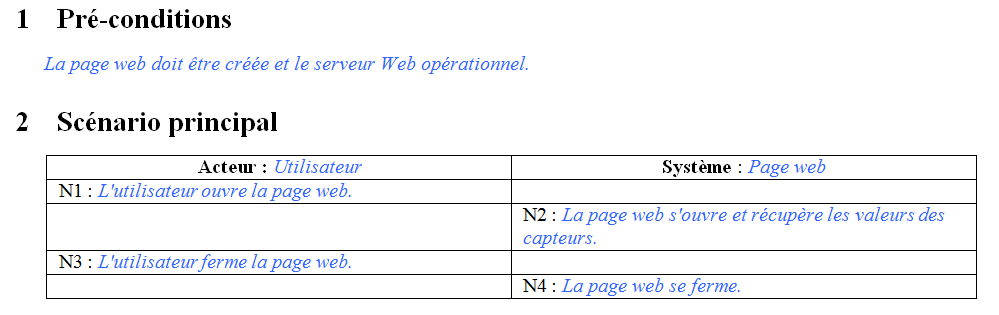
[picture p168: figure]

## Slide 9

Diagramme séquence application

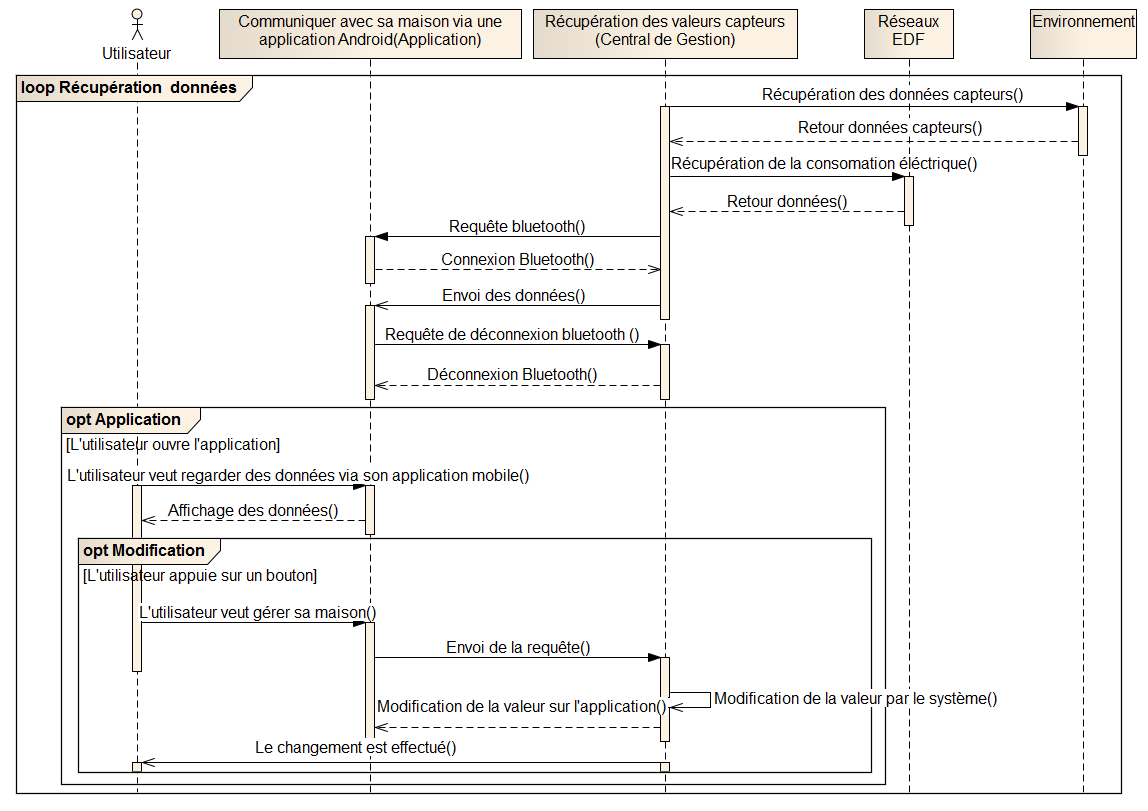
[picture p169: figure]

[ Toutes les 3 secondes ]

## Slide 10

Diagramme séquence web

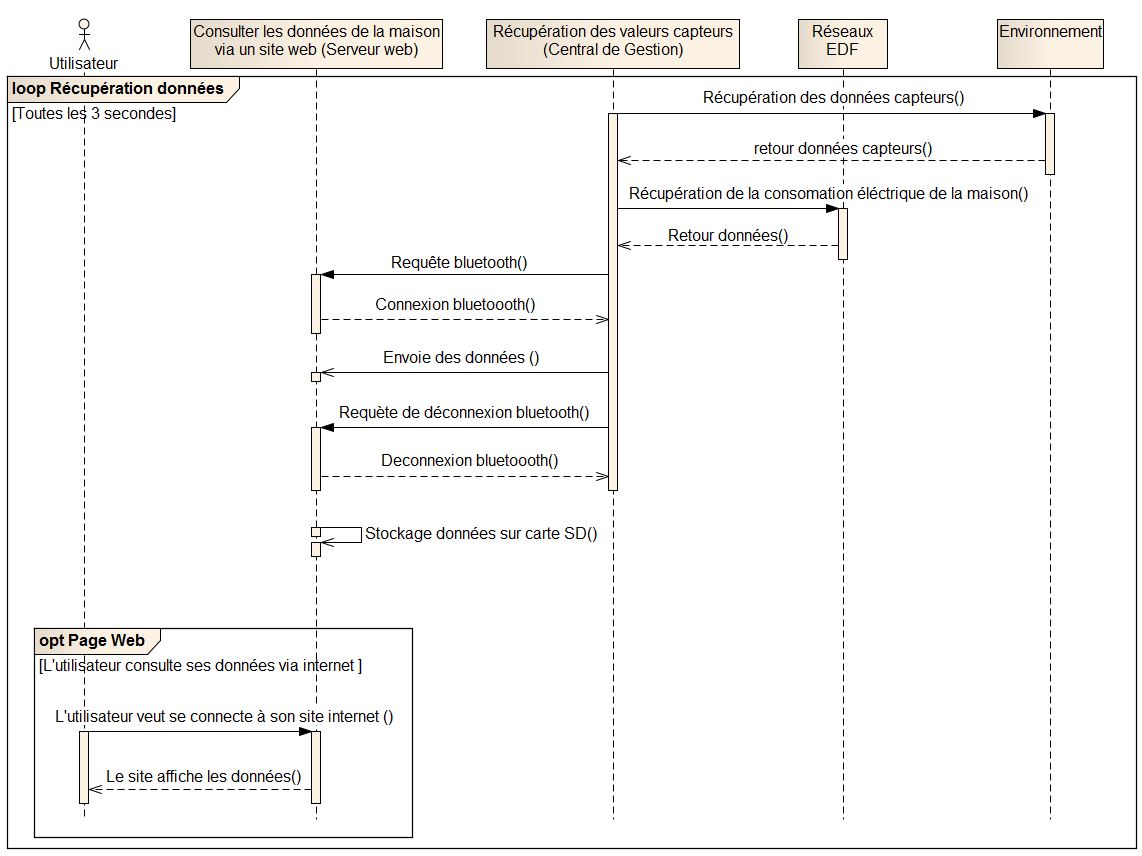
[picture p170: figure]

## Slide 11

Diagramme séquence sécurité

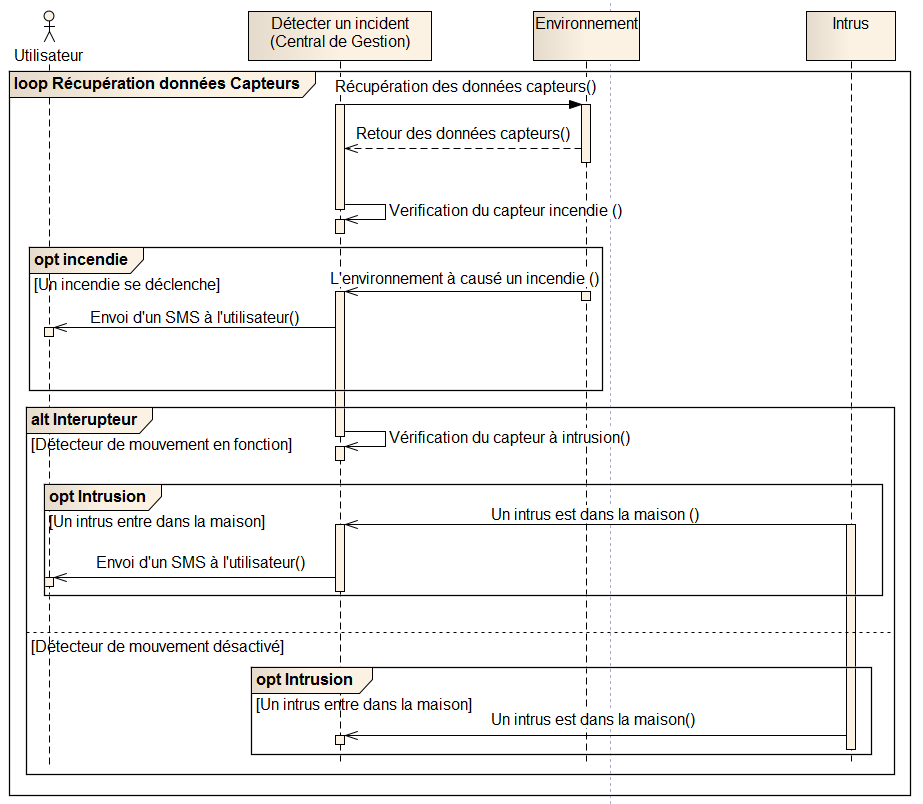
[picture p171: figure]

[Toutes les 3 secondes]

## Présentation de ma partie

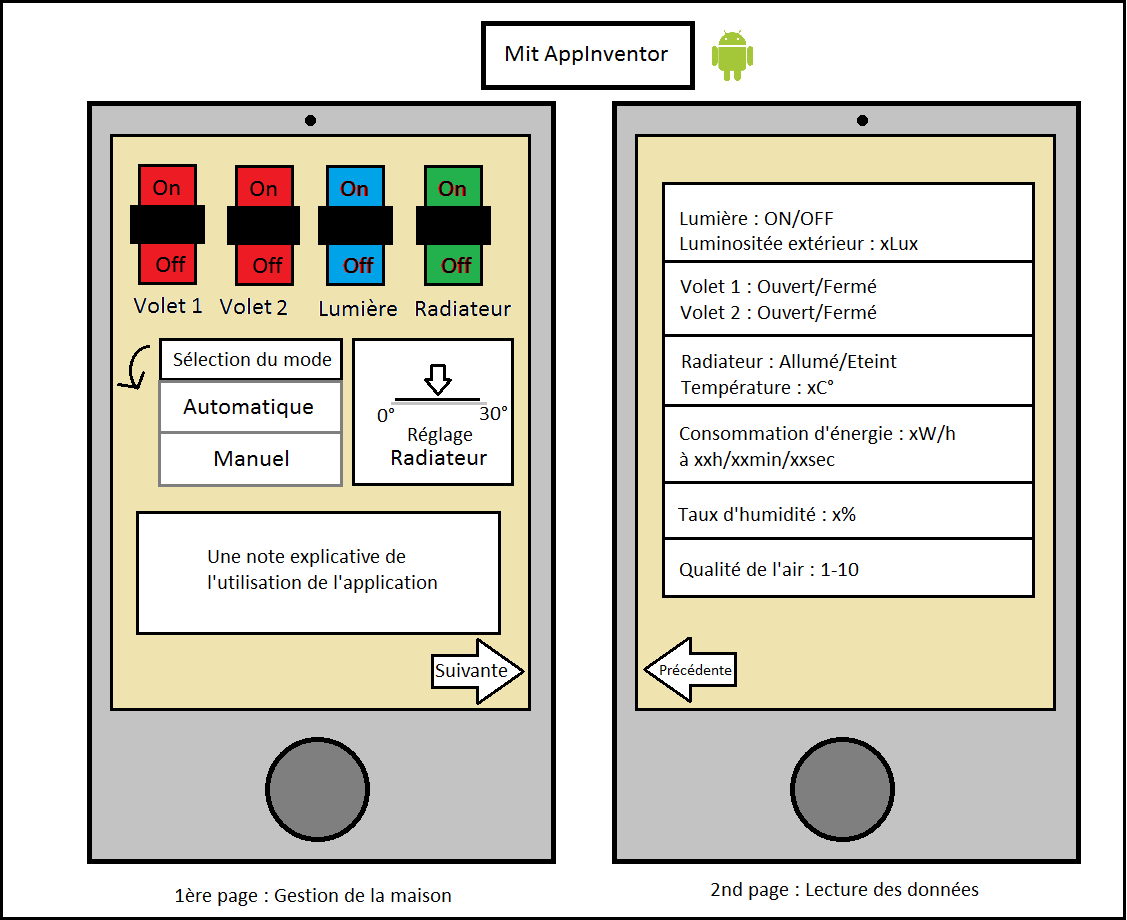
[picture p172: figure]

Croquis de l’application

Problèmes rencontrés :
- Second écran impossible.
- L’emplacement et le design des boutons.

## Prototype de l’application

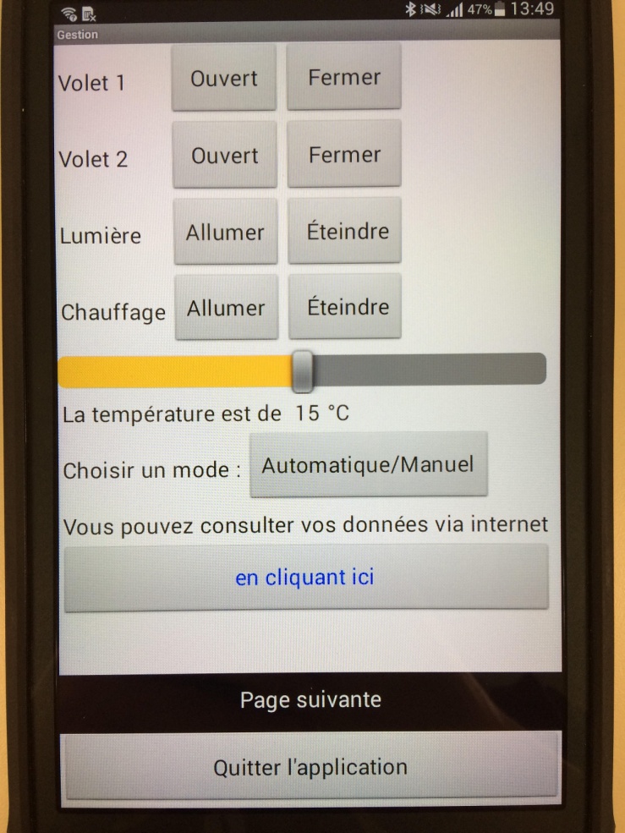
[picture p173: figure]
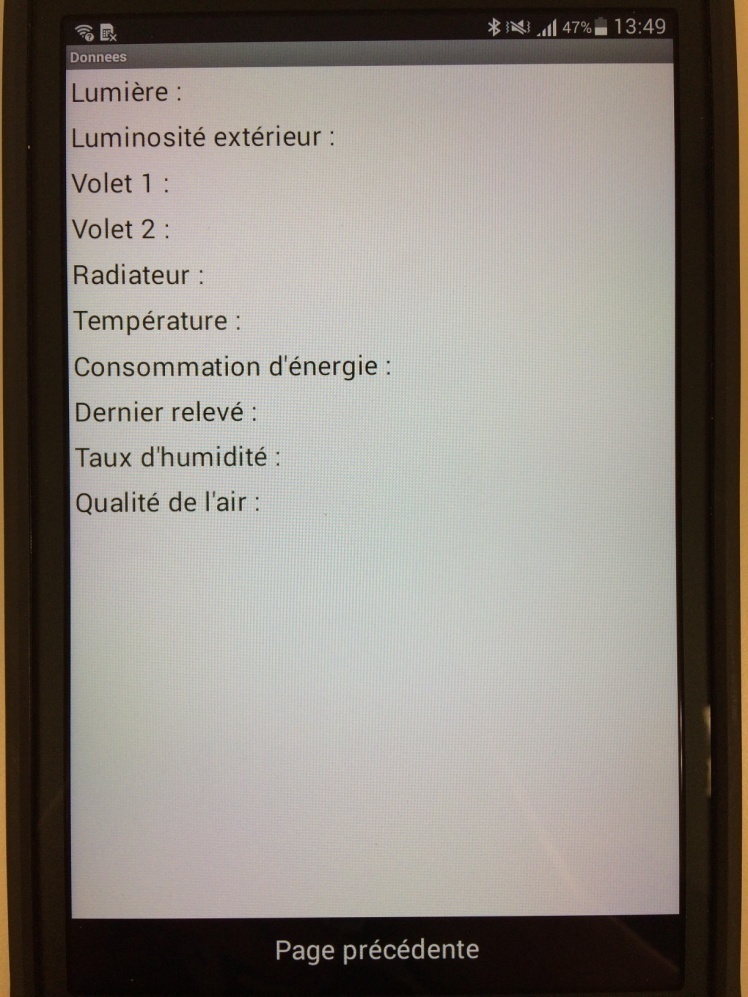
[picture p174: figure]

## Conception finale de l’application

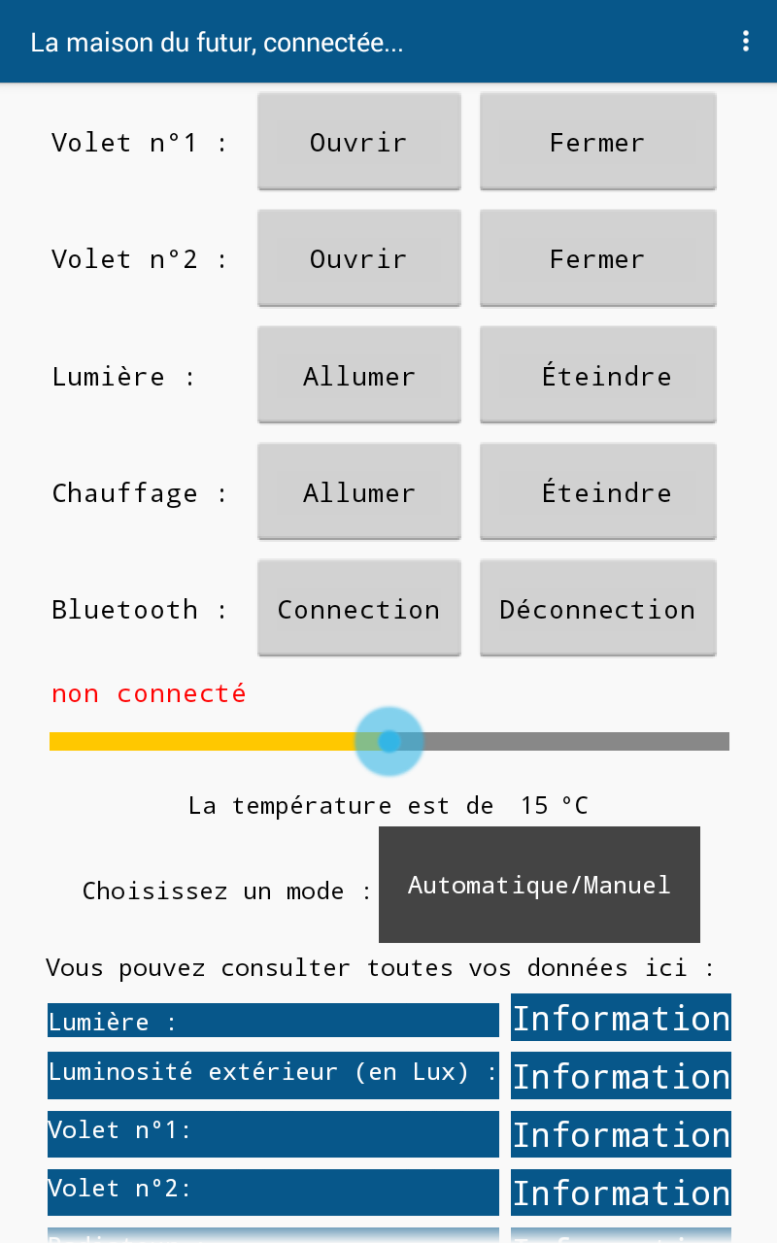
[picture p175: figure]
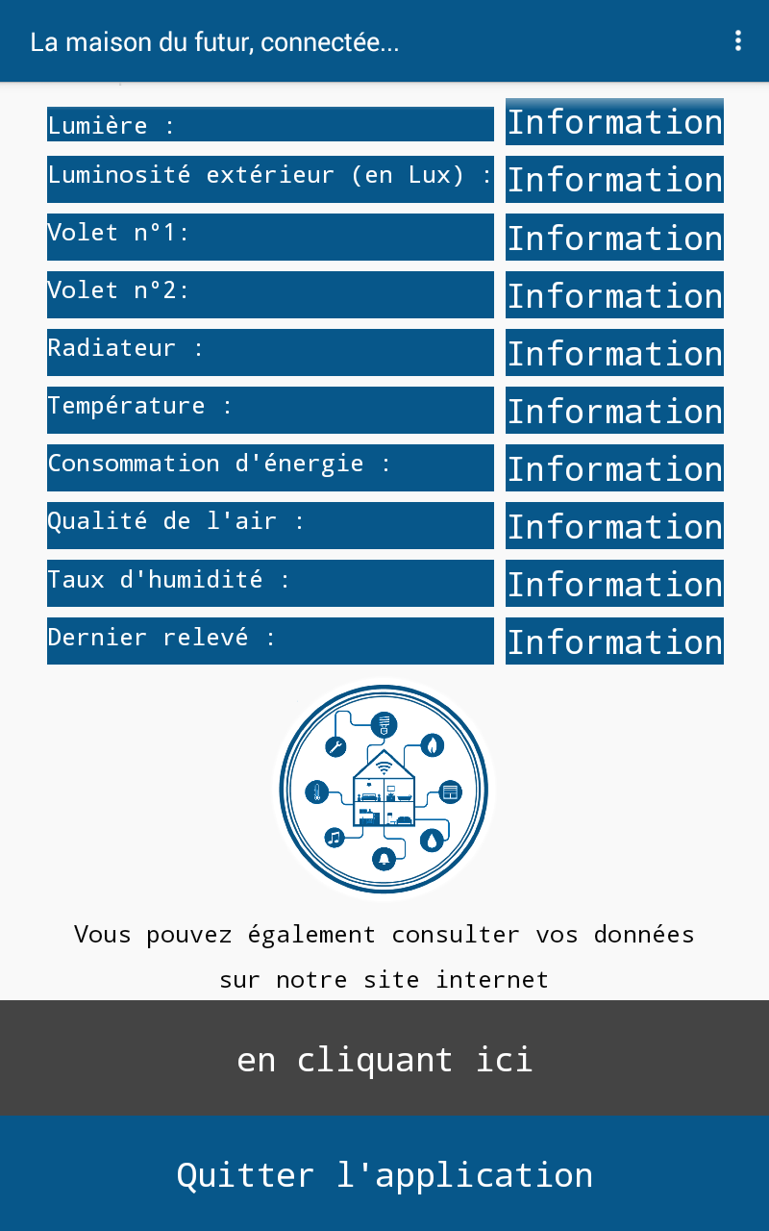
[picture p176: figure]

## Communication Bluetooth HC-05

Configuration des paramètres des modules Bluetooth
- Les commande AT

Nom, mot de passe, vitesse de communication …
Synchronisation des modules, appareillage …
Problèmes rencontrés :
Commandes invalide, entrer en commande AT.

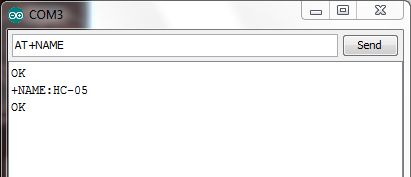
[picture p177: figure]

## Configuration des connexions Bluetooth

- Nombre de connexion à établir 2.
- 1 maître ainsi que 2 esclaves.

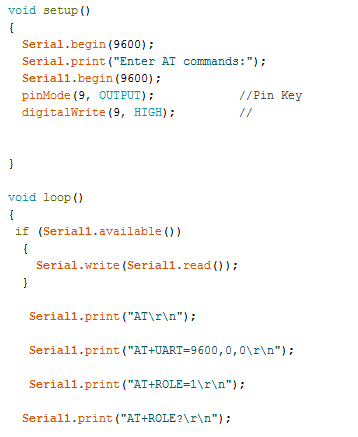
[picture p178: figure]

- Problème : Nuages de module.
- Résolution du problème : Ajout d’un dernier module.
