DrBalf/domotique_bts_sn_ec_projet/Rapport/Nico/Revue_de_projet_3.pptx

## Projet Domotique

Présentation du projet


Dufresne Nicolas

## Slide 13

Petit rappel sur notre projet : Domotique

Les différents aspect à traiter :
  - Aspect confort
  - Aspect sécurité
  - Aspect énergie
  - Aspect gestion


Les 3 parties principale :
  - Partie centrale de gestion
  - Partie serveur Web
  - Partie application mobile

## Mon rôle sur ce projet

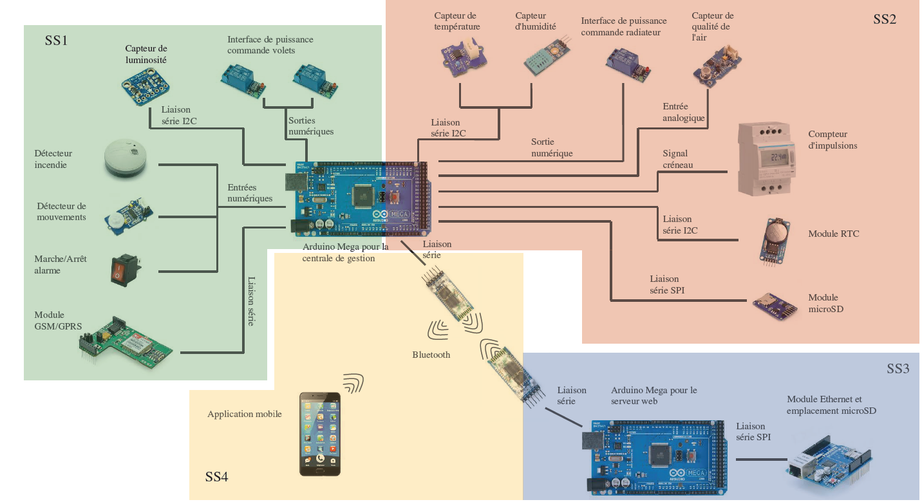
[picture p182: figure]

## Réalisation d’un croquis

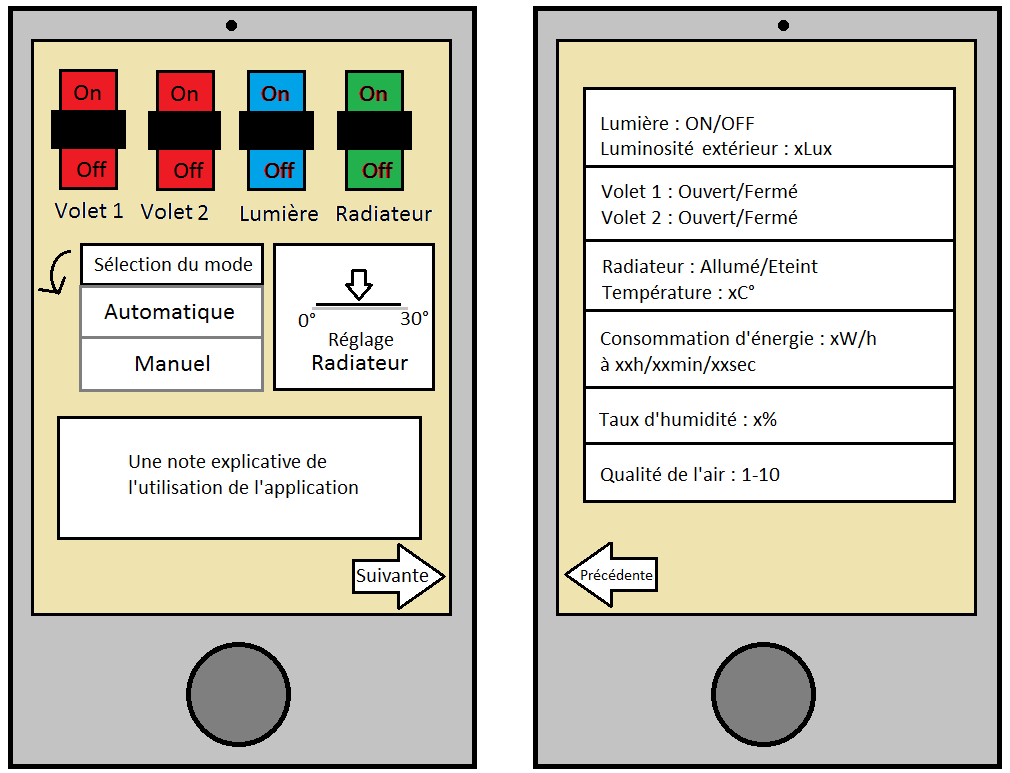
[picture p183: figure]
Image associÃ©e
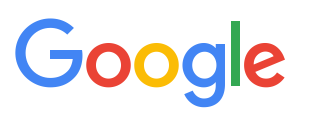
[picture p184: figure]
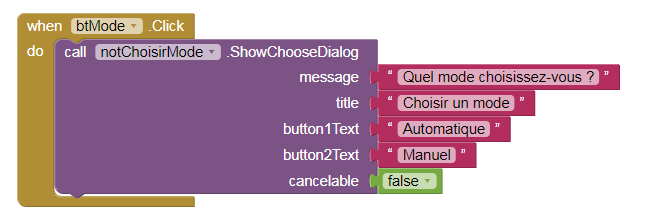
[picture p185: figure]

## Prototype de l’application

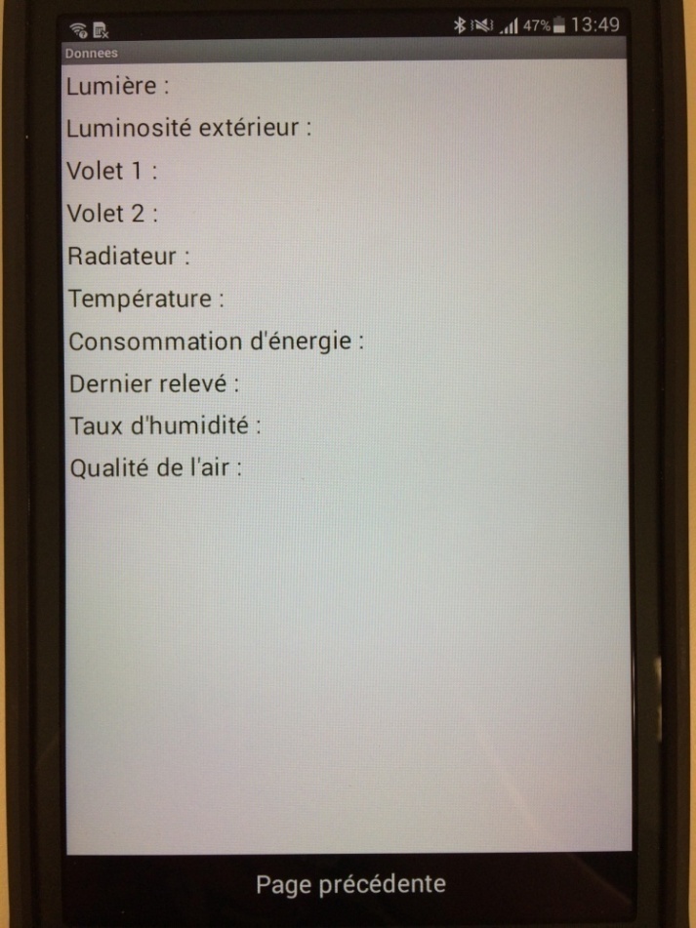
[picture p186: figure]

Problèmes rencontrés :
- Second écran difficile à mettre en œuvre - L’emplacement et le designe des boutons

## Amélioration visuelle de l’application

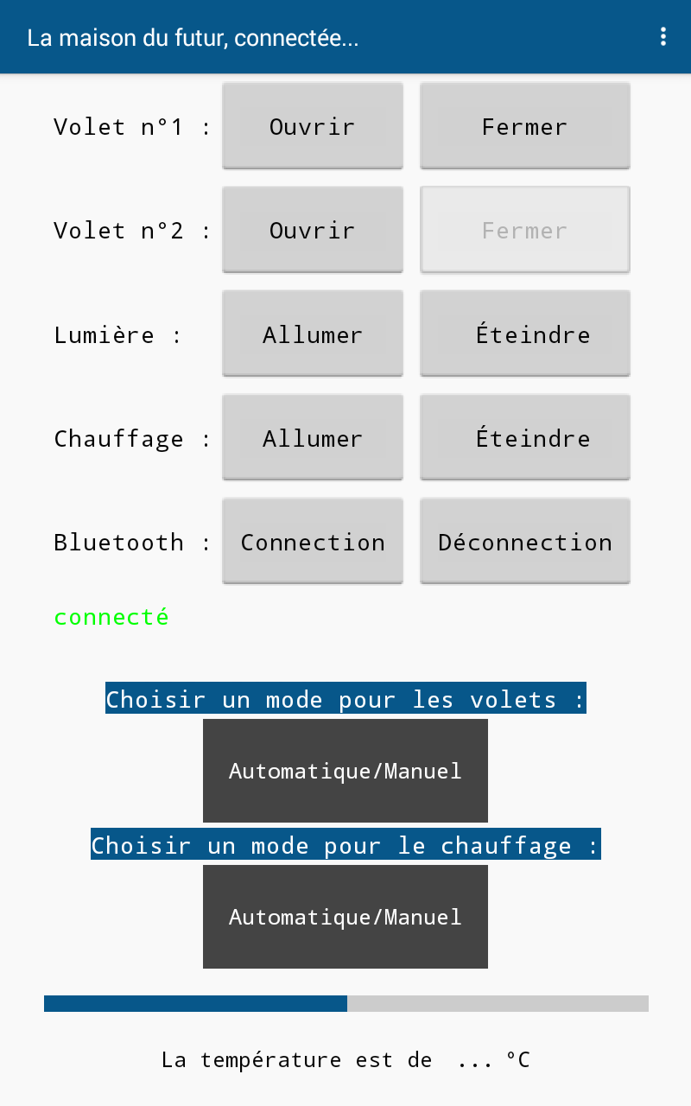
[picture p187: figure]
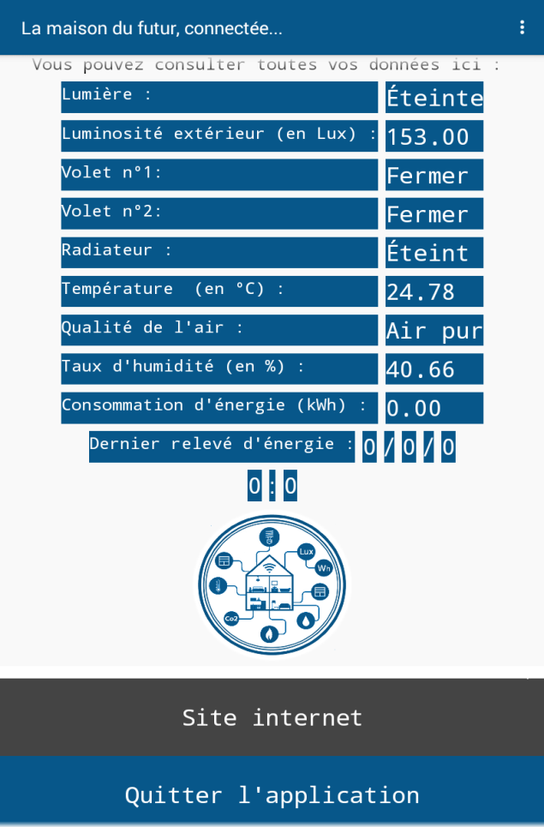
[picture p188: figure]

## Communication Bluetooth HC-05

Configuration des paramètres des modules Bluetooth
- Les commandes AT

Nom, mot de passe, vitesse de communication …
Synchronisation des modules, appareillage …
Problèmes rencontrés :
Commandes AT invalide, difficulté à entrer en commande AT.


## Configuration des connexions Bluetooth

- Nombre de connexion à établir : 2
- 1 maître ainsi que 2 esclaves


- Problème : Nuages de module
- Résolution du problème : Ajout d’un 3ème module HC-05

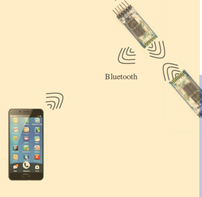
[picture p189: figure]

## Les tests unitaires : les blocs associés

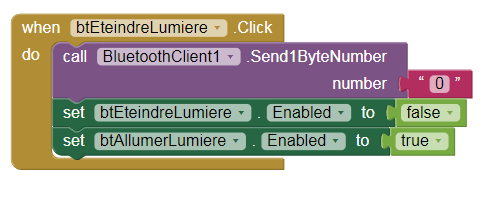
[picture p190: figure]
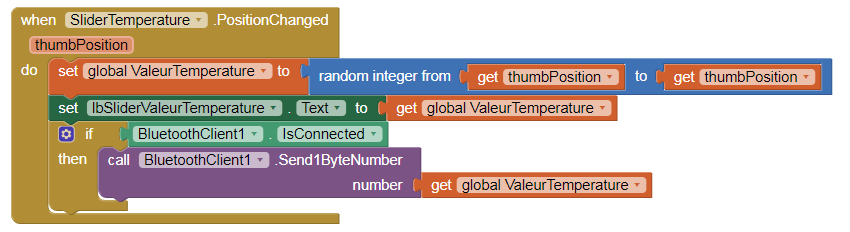
[picture p191: figure]
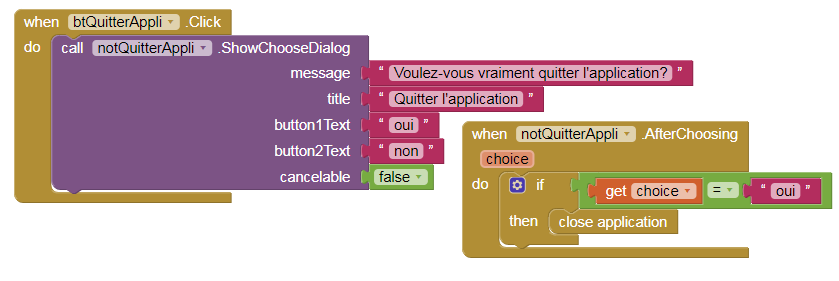
[picture p192: figure]
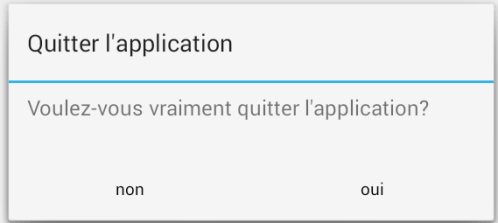
[picture p193: figure]

## Les tests unitaires : Commander à partir de la tablette

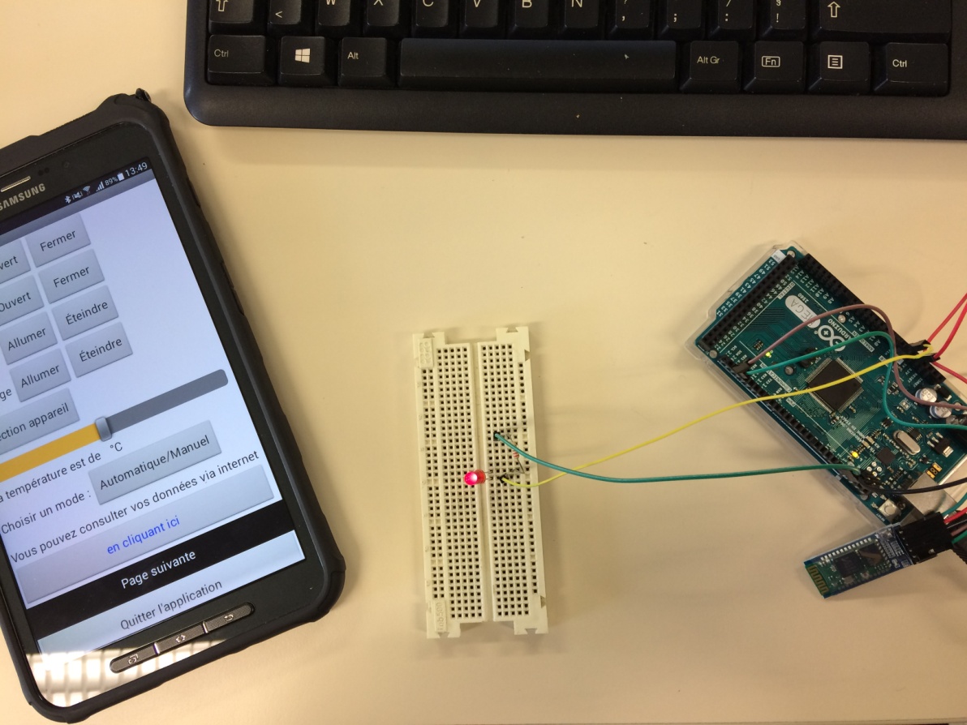
[picture p194: figure]
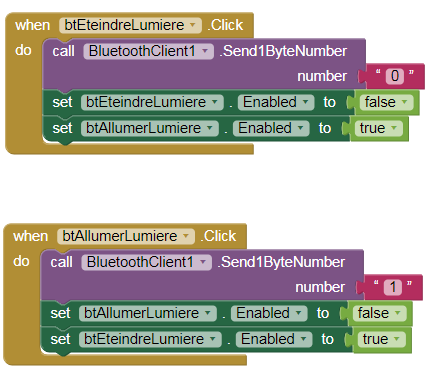
[picture p195: figure]

## Les tests unitaires : récupérer une trame

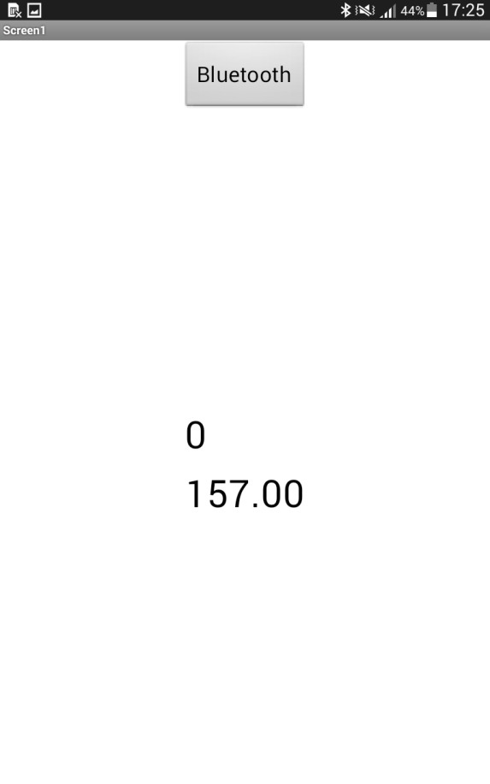
[picture p196: figure]
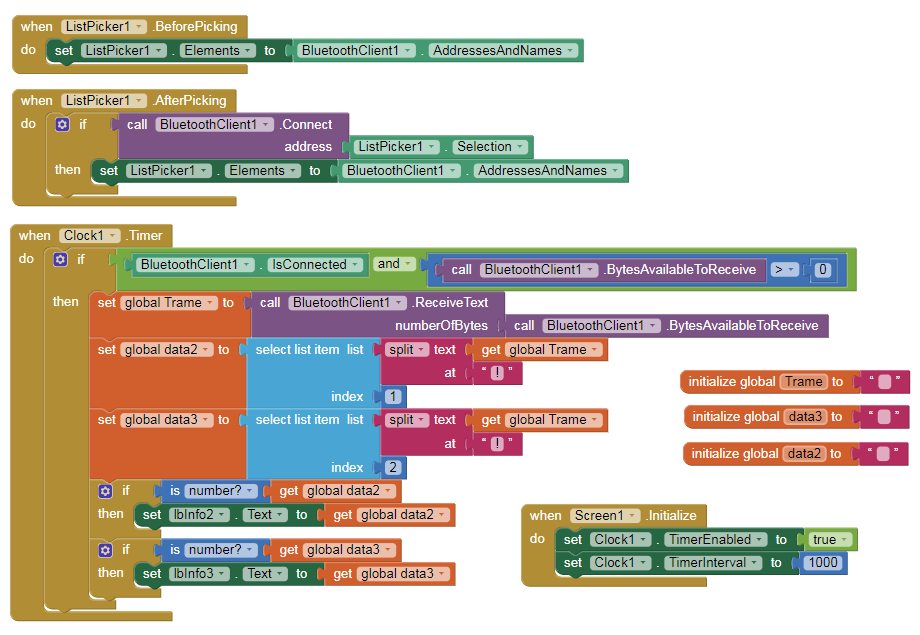
[picture p197: figure]

## Les tests unitaires : récupérer une trame

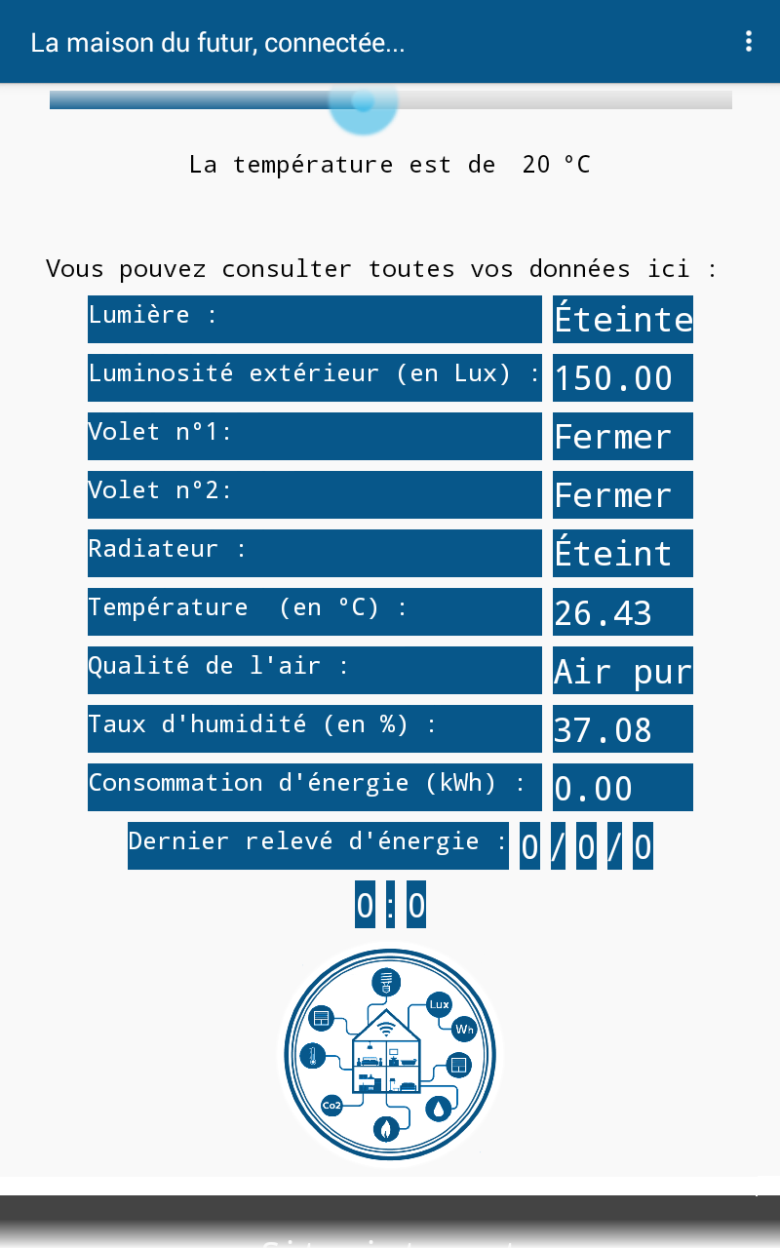
[picture p198: figure]
