DrBalf/domotique_bts_sn_ec_projet/Rapport/Benjamin/RevueDeProjet.pptx

## Projet Domotique

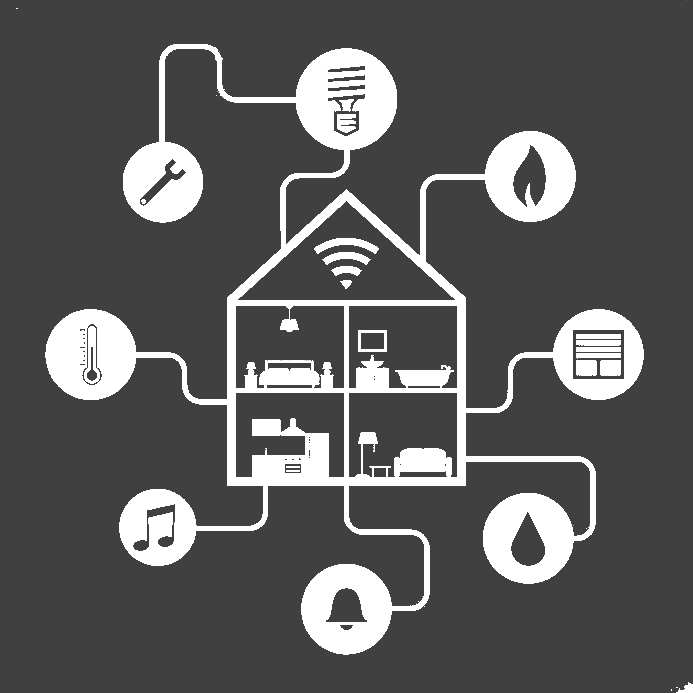
[picture p199: figure]

## Cahier des charges : La maison du Future

Les différents aspect à traiter :
  - Aspect confort
  - Aspect sécurité
  - Aspect énergie
  - Aspect gestion


Les 3 parties principale :
  - Partie centrale de gestion
  - Partie serveur WEB
  - Partie application mobile

## Slide 13

Présentation du travail à faire :

Sécurité

Gestion des lumières


Gestion des volets

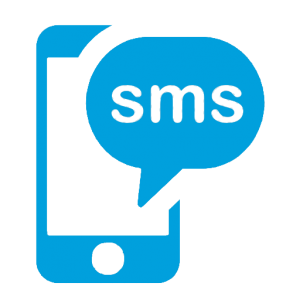
[picture p200: figure]
Résultat de recherche d'images pour "sms"
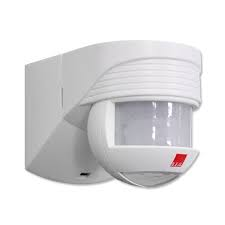
[picture p201: figure]
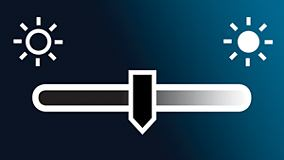
[picture p202: figure]
Résultat de recherche d'images pour "luminosité"

## Tests unitaires : Sécurité

Détecteur incendie

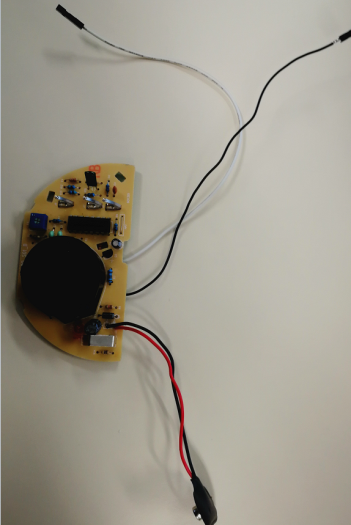
[picture p203: figure]
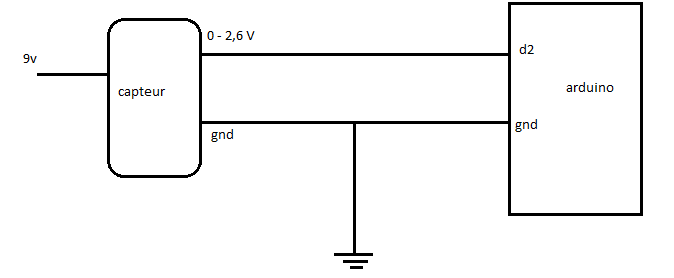
[picture p204: figure]
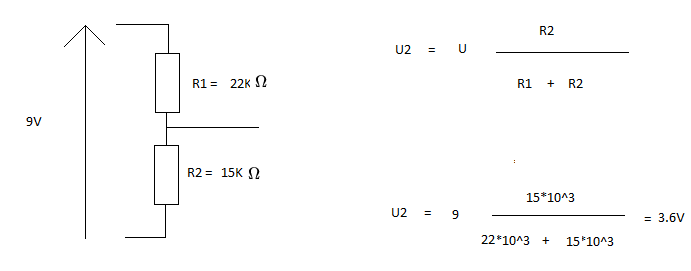
[picture p205: figure]

## Tests unitaires : Sécurité

Détecteur de mouvement

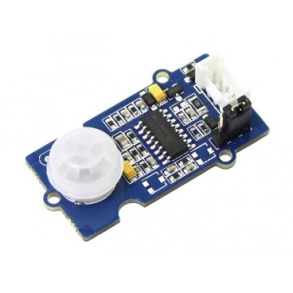
[picture p206: figure]
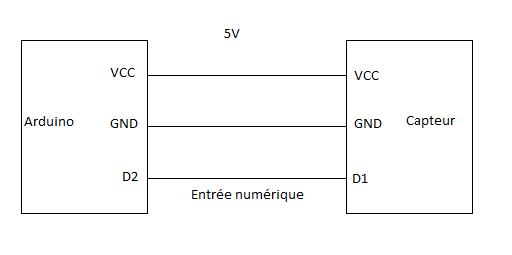
[picture p207: figure]

## Tests unitaires : Gestion des lumières

Relai lumière

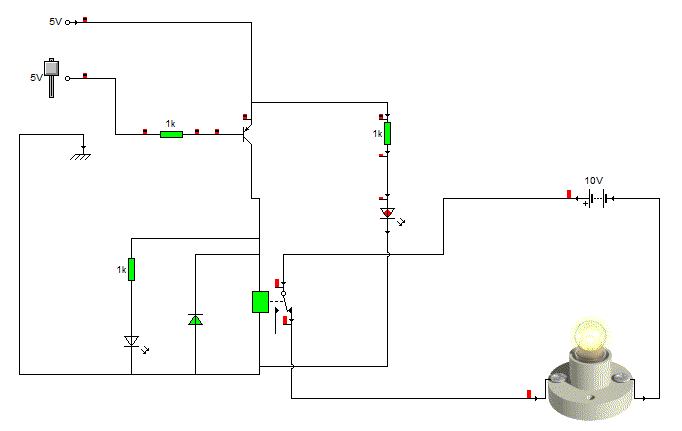
[picture p208: figure]

## Tests unitaires : Gestion des volets

Capteur de luminosité

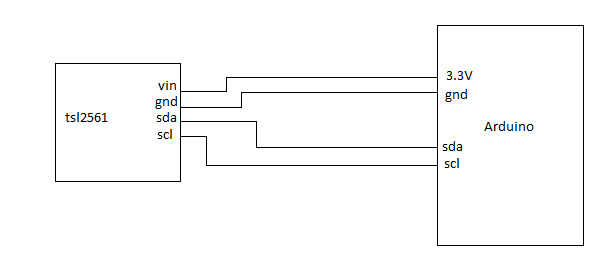
[picture p209: figure]

## Tests unitaires : Gestion des volets

Volet Roulant

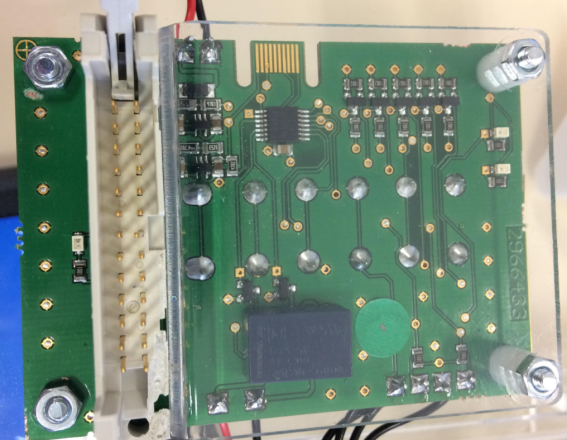
[picture p210: figure]

## Tests d’intégration

Volet Roulant, Capteur de luminosité, Lumière
