DrBalf/domotique_bts_sn_ec_projet/Rapport/Lore/presentation_revu.pptx

## Projet Domotique

Revu de projet N°2

## Cahier des charges : La maison du Future

Les différents aspect à traiter :
  - Aspect confort
  - Aspect sécurité
  - Aspect énergie
  - Aspect gestion des actionneur


Les 3 parties principale :
  - Partie centrale de gestion
  - Partie serveur WEB
  - Partie application mobile

## Architecture matériel


## Analyse fonctionnel


Diagramme des exigences :


## Slide 5


Diagramme de cas d’utilisation :


## Slide 6

Diagramme séquence application :


## Slide 7

Diagramme séquence web :


## Slide 8

Diagramme séquence sécurité :


## Les protocoles

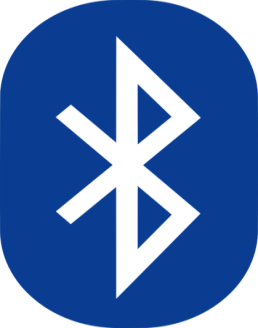
[picture p223: figure]

- lum(bool) 5sec
- rad(bool) 5sec
- vol(bool) 5sec
- lux(lux) 10sec
- tem(c°) 5sec
- hum(%) 5sec
- air(1-10) 10sec
- con(w) impulsion du compteur
- heu(ss) impulsion du compteur
- dat(jour) impulsion du compteur
Exemple de trame : $lum0$lux121$tem20$air5;

## Mon rôle dans ce projet

Confort


Consommation


## LES TESTS UNITAIRES

Le thermomètre et l’hygromètre


Montage du HIH6130


Montage du BMP180

Résultat de recherche d'images pour "bmp180"

## Slide 12

LES TESTS UNITAIRES

Le capteur de qualité d’air

- Air pure
- Air faiblement pollué
- Air pollué
- Air très pollué

Montage du MP503


## Slide 13

LES TESTS UNITAIRES

Sauvegarder sur une carte SD

Montage de l’adaptateur

Résultat de recherche d'images pour "micro sd card adapter arduino schematic"

11 toto.txt : 11 correspond au nombre d'octet dans le fichier nommé toto.txt

## Slide 14

LES TESTS UNITAIRES

Contrôle du relais

Montage


## Slide 15

LES TESTS UNITAIRES

Contrôle du module RTC

Montage


## Slide 16

LES TESTS UNITAIRES

Compteur électrique

Montage
