DrBalf/domotique_bts_sn_ec_projet/Rapport/Nico/Projet_Domotique_présentation.pptx

## Projet Domotique

Présentation du projet


## Cahier des charges : La maison du Future

Les différents aspect à traiter :
  - Aspect confort
  - Aspect sécurité
  - Aspect énergie
  - Aspect gestion des ouvrants


Les 3 parties principale :
  - Partie centrale de gestion
  - Partie serveur WEB
  - Partie application mobile

## Architecture matériel


## Analyse fonctionnel : Diagramme des exigences


## Slide 5


Diagramme de cas d’utilisation :


## Scénario d’alerte sécurité


## Scénario d’application


## Scénario serveur web


## Slide 9

Diagramme séquence application :


[ Toutes les 3 secondes ]

## Slide 10

Diagramme séquence web :


## Slide 11

Diagramme séquence sécurité :


[Toutes les 3 secondes]

## Croquis de l’application


Problèmes rencontrés :
- Second écran impossible.
- L’emplacement et le design des boutons.

## Prototype de l’application


## Conception finale de l’application


## Communication Bluetooth HC-05

Configuration des paramètres des modules Bluetooth
- Les commande AT

Nom, mot de passe, vitesse de communication …
Synchronisation des modules, appareillage …
Problèmes rencontrés :
Commandes invalide, entrer en commande AT.


## Configuration des connexions Bluetooth

- Nombre de connexion à établir 2.
- 1 maître ainsi que 2 esclaves.


- Problème : Nuages de module.
- Résolution du problème : Ajout d’un dernier module.
