DrBalf/domotique_bts_sn_ec_projet/Rapport/Tommy/Projet_Domotique_présentation.pptx

## Projet Domotique

Présentation du projet

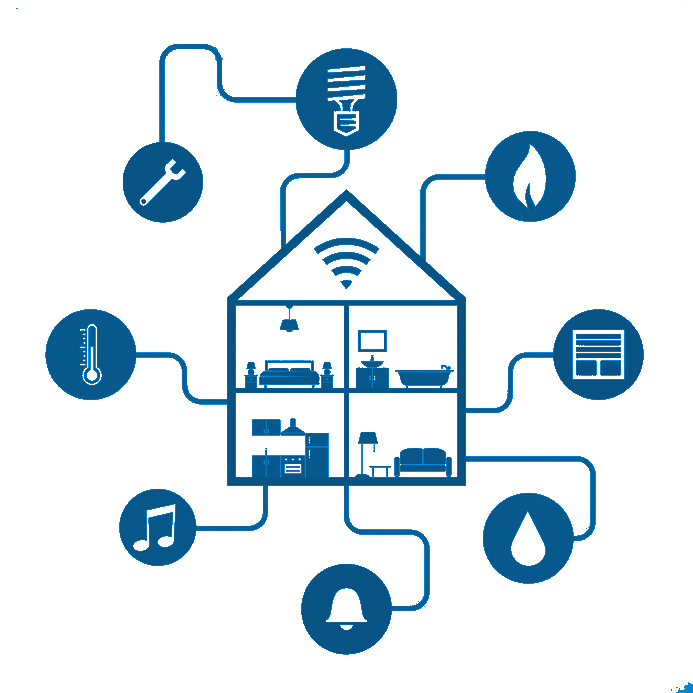
[picture p224: figure]

## Cahier des charges : La maison du Future

Les différents aspect à traiter :
  - Aspect confort
  - Aspect sécurité
  - Aspect énergie
  - Aspect gestion des ouvrants


Les 3 parties principale :
  - Partie centrale de gestion
  - Partie serveur WEB
  - Partie application mobile

## Architecture matériel


## Analyse fonctionnel


Diagramme des exigences :


## Slide 5


Diagramme de cas d’utilisation :


## Scénario d’alerte sécurité


## Scénario d’application


## Scénario serveur web


## Slide 9

Diagramme séquence application :


## Slide 10

Diagramme séquence web :


## Slide 11

Diagramme séquence sécurité :


## Présentation de ma partie

- Le schéma/le matérielle
- Le but

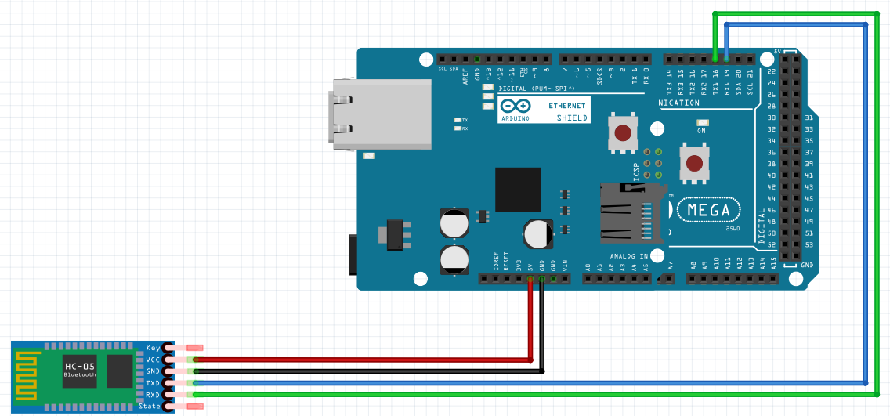
[picture p225: figure]

## Les protocoles


- lum(bool) 3sec
- rad(bool) 3sec
- vol(bool) 3sec
- lux(lux) 3sec
- tem(c°) 3sec
- hum(%) 3sec
- air(1-10) 3sec
- con(w) impulsion du compteur
- heu(ss) impulsion du compteur
Exemple de trame : $lum0$lux121$tem20$air5;

## Communication Bluetooth

- Les Commandes AT
  - Configuration des modules (nom, vitesse …)
  - Configuration Bluetooth (rôle, recherche, connexion)
- Problèmes rencontrés
  - Commande invalide, entrer en mode AT

## Communication Bluetooth

- Configuration des connections entre modules
  - À l’origine : 1 maître 2 esclaves
    - Problème : module inadapté
  - Résolution : Ajout d’un autre module

## Le site web

- Configuration du shield Ethernet
  - Configuration ip
  - Configuration du réseau
  - Configuration serveur

## Le site web

- Présentation du site
  - Prototype du site

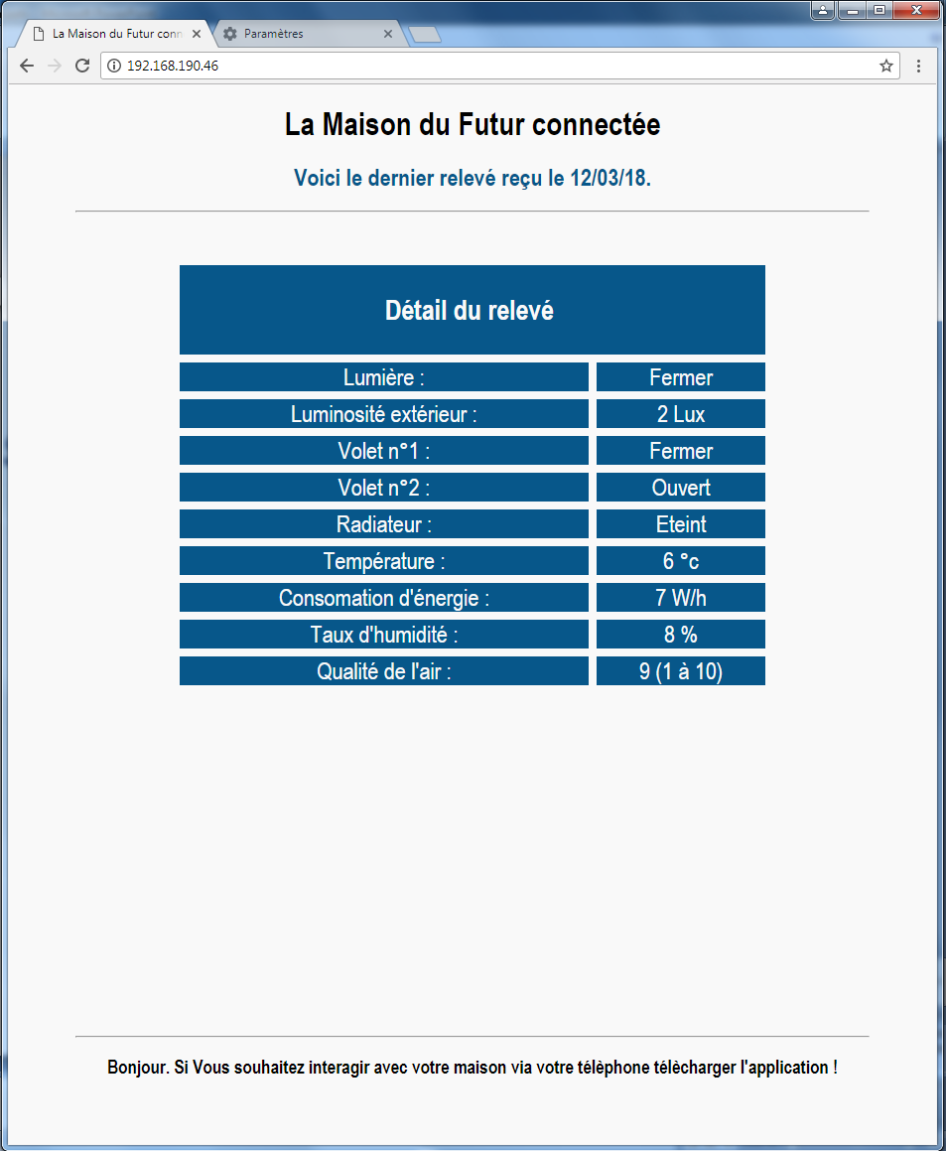
[picture p226: figure]
