DrBalf/domotique_bts_sn_ec_projet/Première page de couverture.docx

| 2017/2018
| Lycée Raymond Queneau Dufresne Nicolas

[Compte rendu du projet Domotique]

[Compte rendu final du projet de fin d'année 2017/2018 de la section BTS Système Numérique, option Informatique et Réseaux. ]

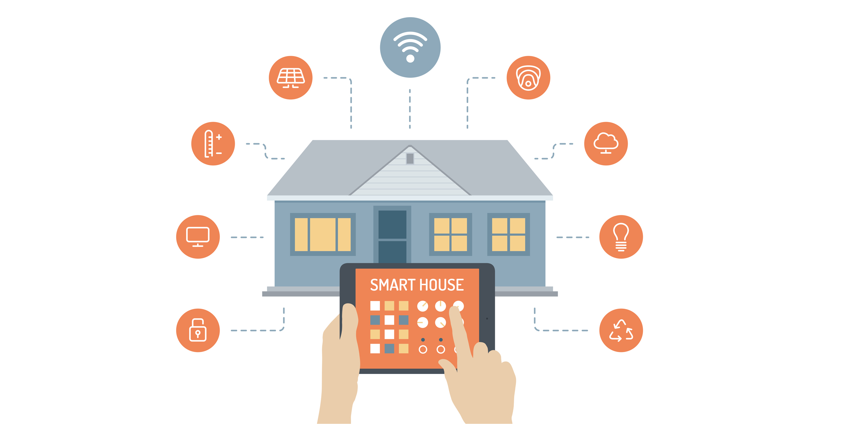
[picture p272: figure]

Lycée Raymond Queneau 2017/2018Page 2

Compte rendu du projet Domotique
