DrBalf/domotique_bts_sn_ec_projet/Documentation/adapteur_tension/cablage.pdf

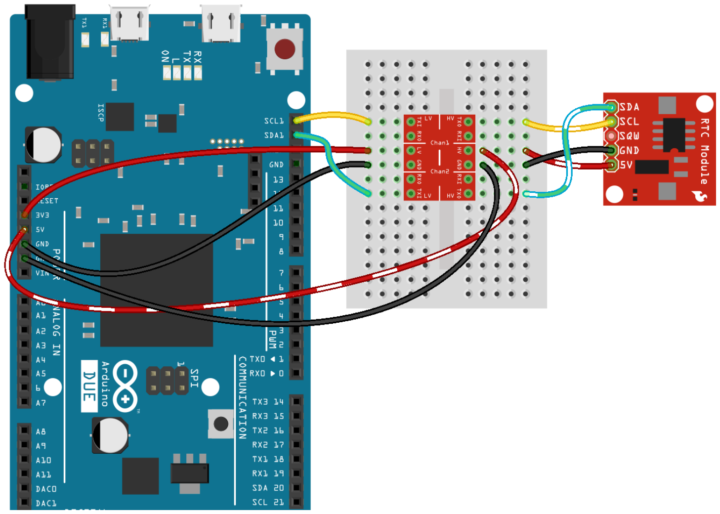
[picture p278: page 1]
