DrBalf/domotique_bts_sn_ec_projet/ERWAAAAAAAAN.png

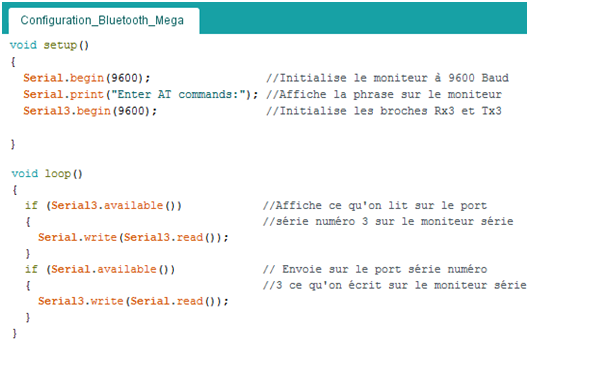
ERWAAAAAAAAN.png
