DrBalf/domotique_bts_sn_ec_projet/Image_Tommy/Code_4.png

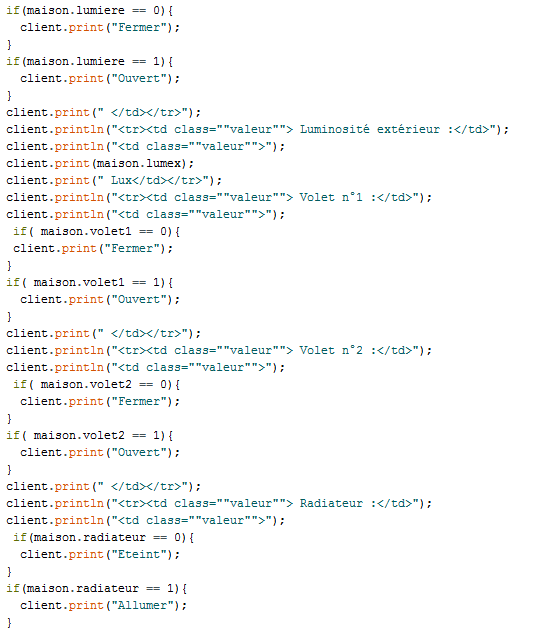
Image_Tommy/Code_4.png
