DrBalf/domotique_bts_sn_ec_projet/Image_Tommy/decodage(cpp)1.png

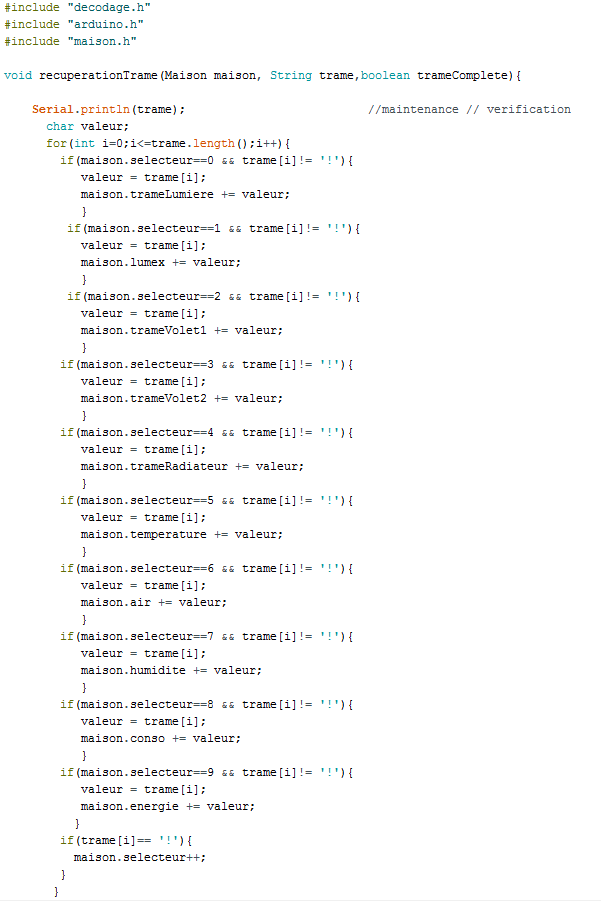
Image_Tommy/decodage(cpp)1.png
