DrBalf/domotique_bts_sn_ec_projet/Image_Tommy/decodage(cpp)2.png

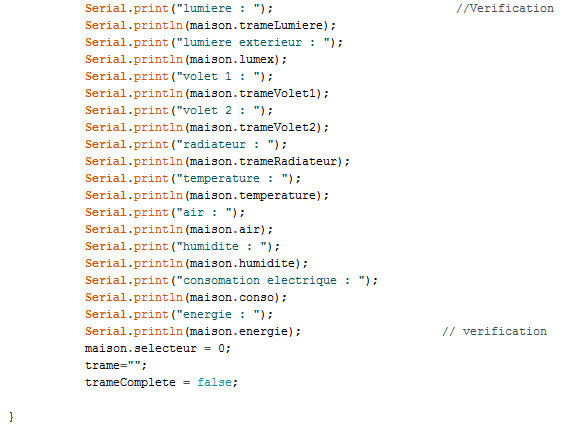
Image_Tommy/decodage(cpp)2.png
