DrBalf/domotique_bts_sn_ec_projet/Image_Tommy/decodage(h).png

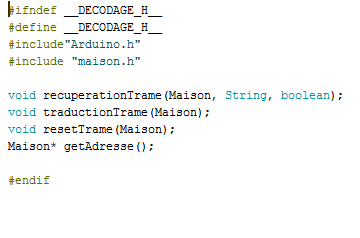
Image_Tommy/decodage(h).png
