DrBalf/domotique_bts_sn_ec_projet/Image_Tommy/maison(cpp)3.png

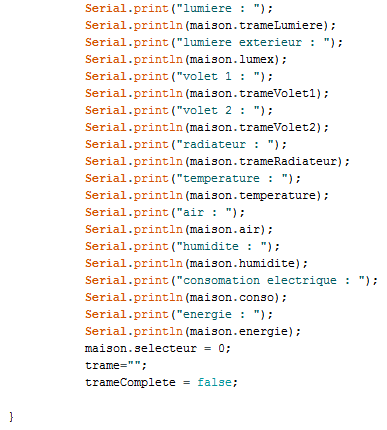
Image_Tommy/maison(cpp)3.png
