DrBalf/domotique_bts_sn_ec_projet/Image_Tommy/maison(cpp)4.png

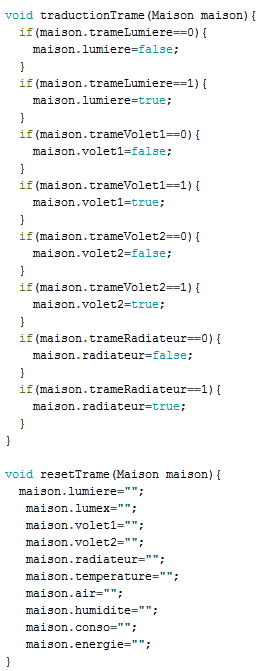
Image_Tommy/maison(cpp)4.png
