DrBalf/domotique_bts_sn_ec_projet/Logiciels/Bluetooth/Image_Pour_Le_Compte_Rendu/Led et résistance.png

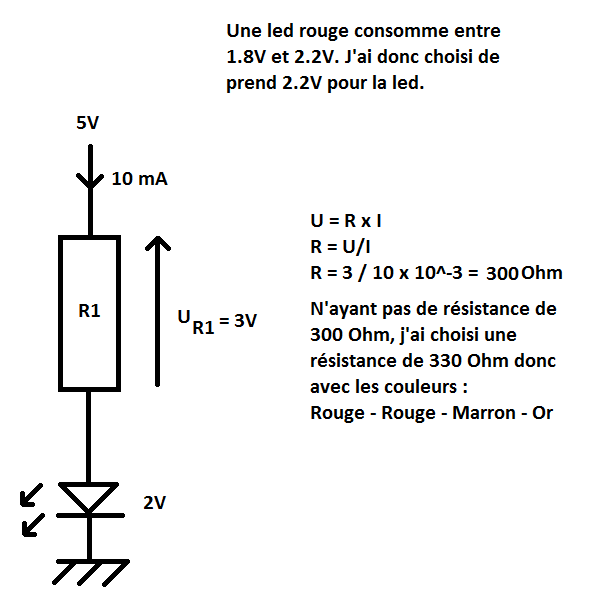
Logiciels/Bluetooth/Image_Pour_Le_Compte_Rendu/Led et résistance.png
