DrBalf/domotique_bts_sn_ec_projet/Materiels/Benjamin/autre/400px-yodabatar.jpg

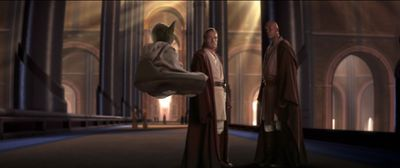
Materiels/Benjamin/autre/400px-yodabatar.jpg
