DrBalf/domotique_bts_sn_ec_projet/Materiels/Benjamin/autre/193370491_small.jpg

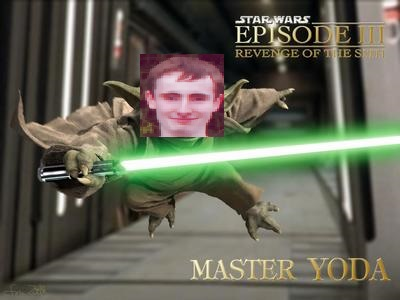
Materiels/Benjamin/autre/193370491_small.jpg
