DrBalf/domotique_bts_sn_ec_projet/Materiels/Benjamin/CapteurIncendie/PontDivTen.png

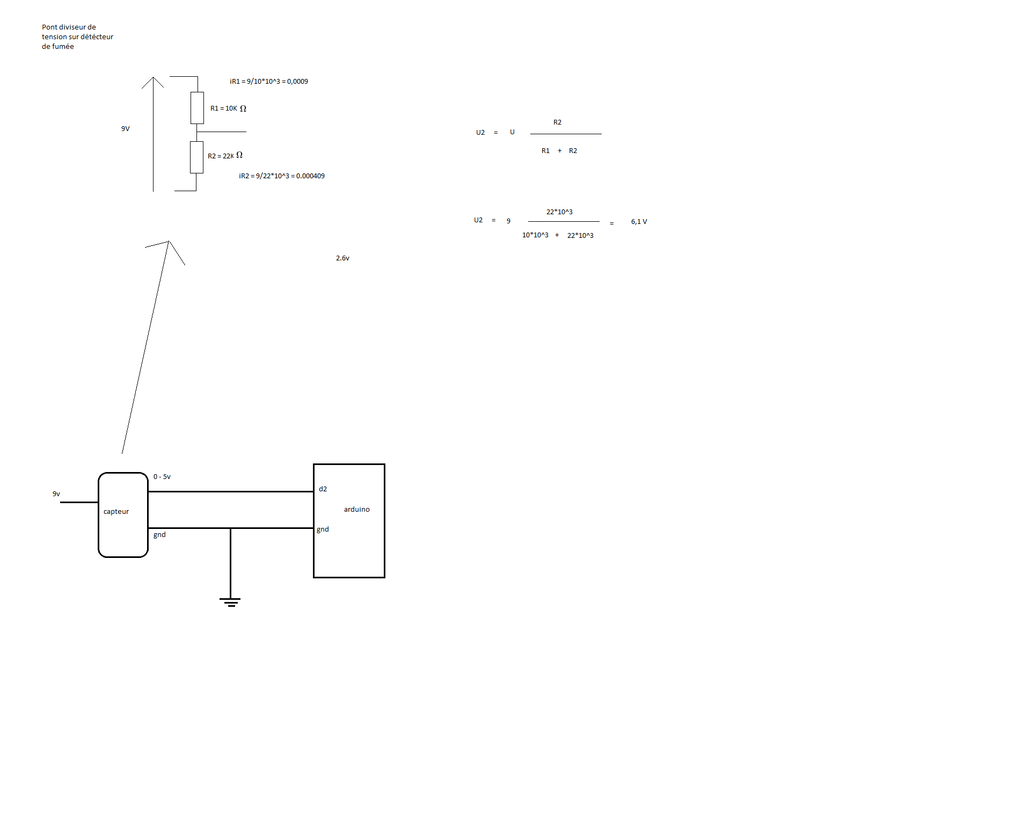
Materiels/Benjamin/CapteurIncendie/PontDivTen.png
