DrBalf/domotique_bts_sn_ec_projet/Materiels/Benjamin/gestionOuvrants.png

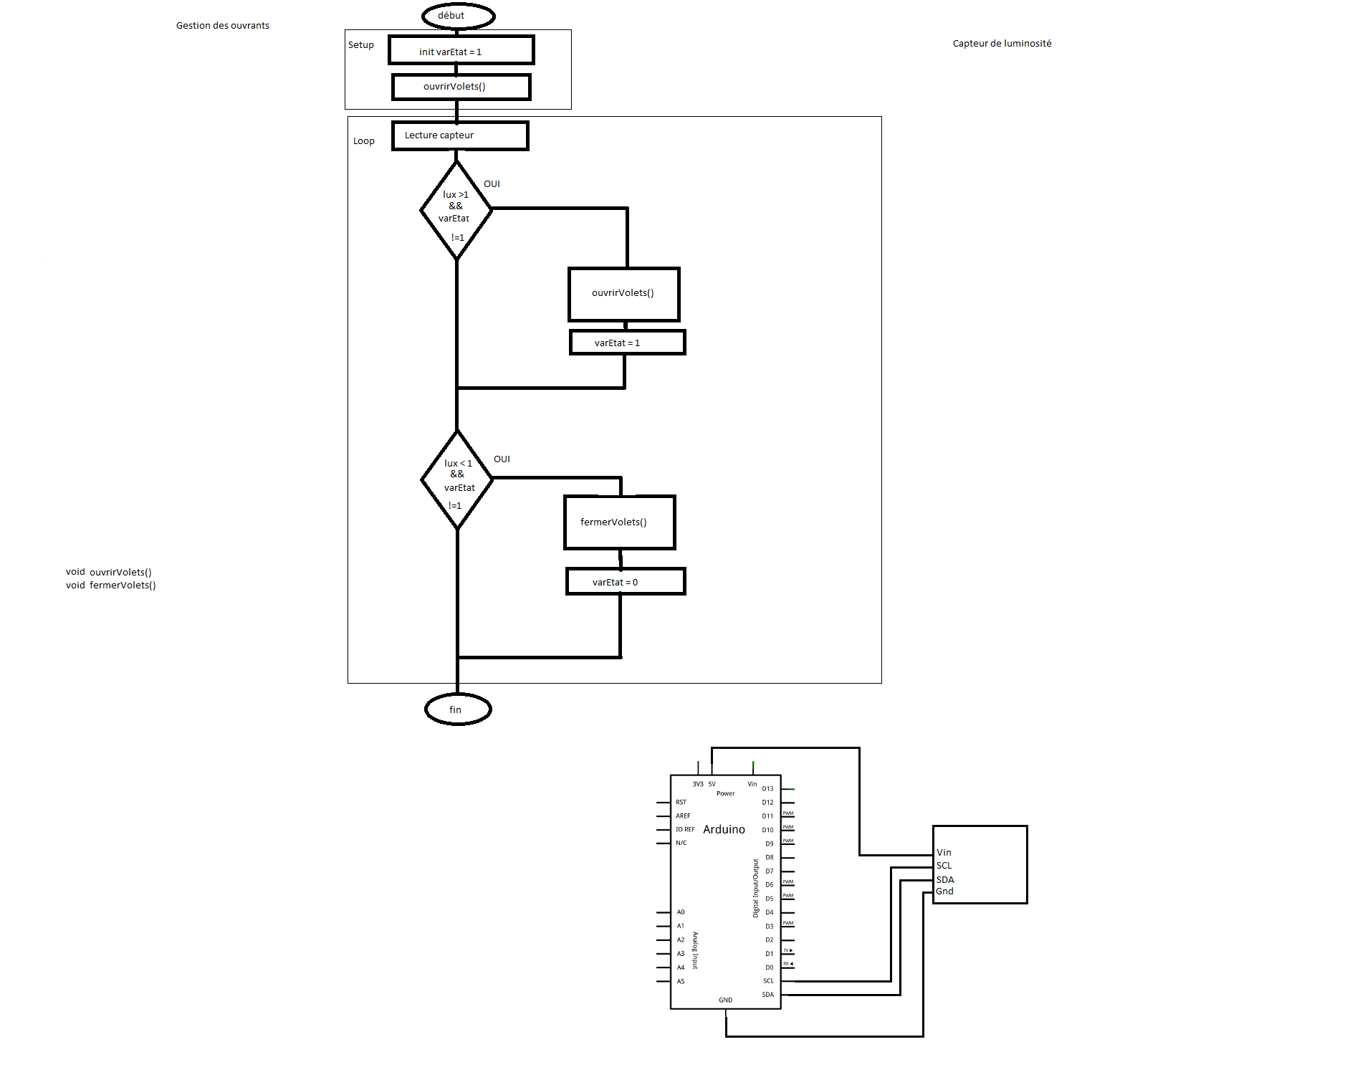
Materiels/Benjamin/gestionOuvrants.png
