DrBalf/domotique_bts_sn_ec_projet/Materiels/Benjamin/progConfort/schema.png

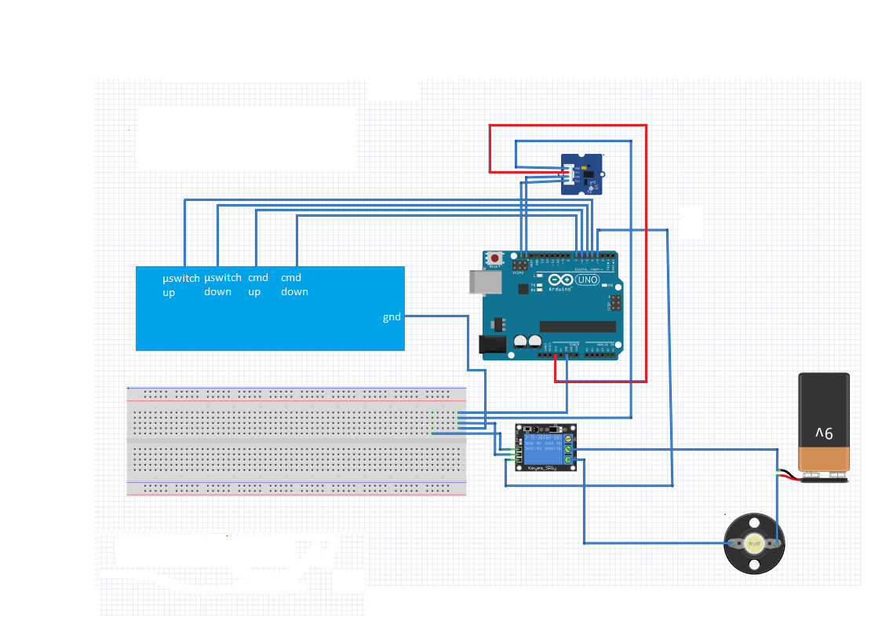
Materiels/Benjamin/progConfort/schema.png
