DrBalf/domotique_bts_sn_ec_projet/Materiels/Benjamin/VoletsRoulants/schema.png

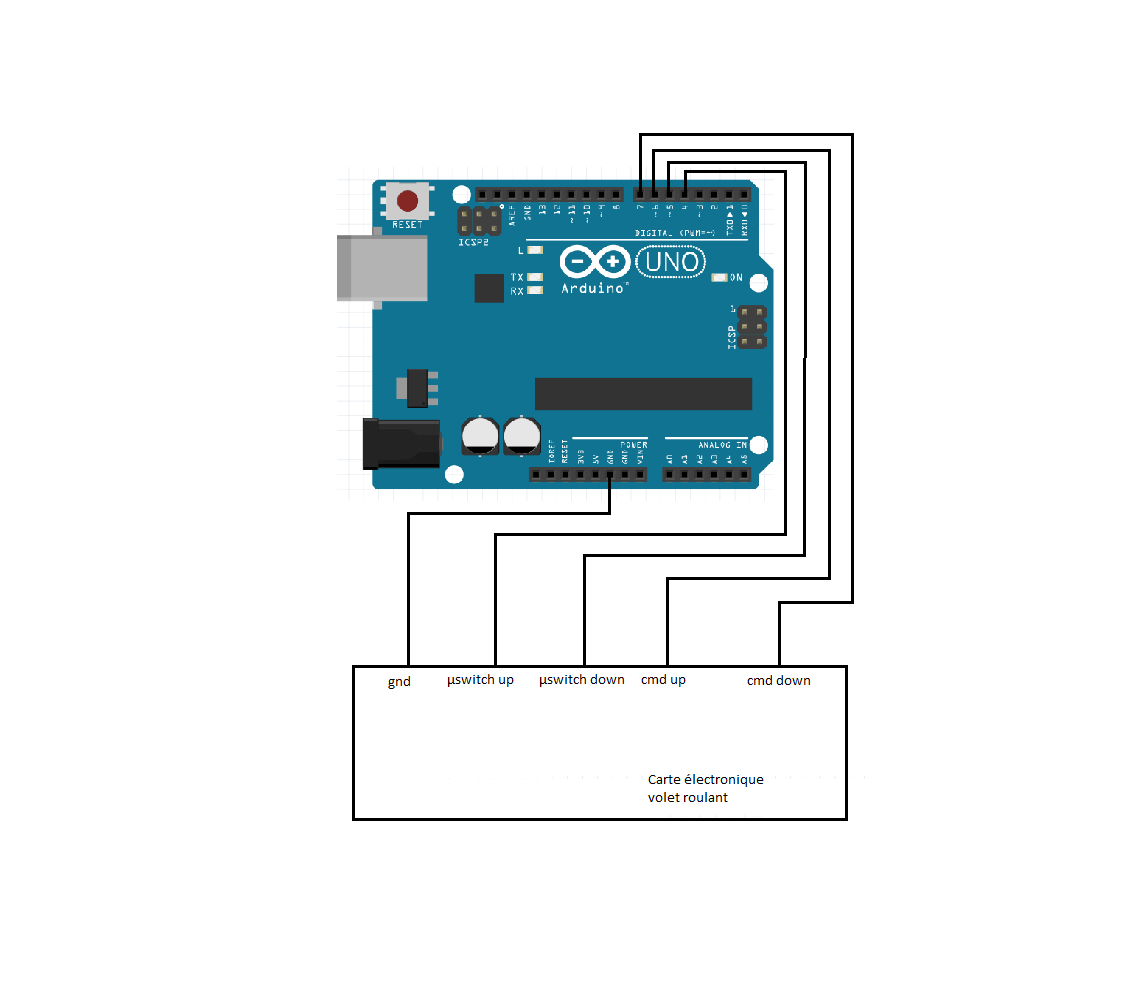
Materiels/Benjamin/VoletsRoulants/schema.png
