DrBalf/domotique_bts_sn_ec_projet/Rapport/ANNexe/Application_Code_final.png

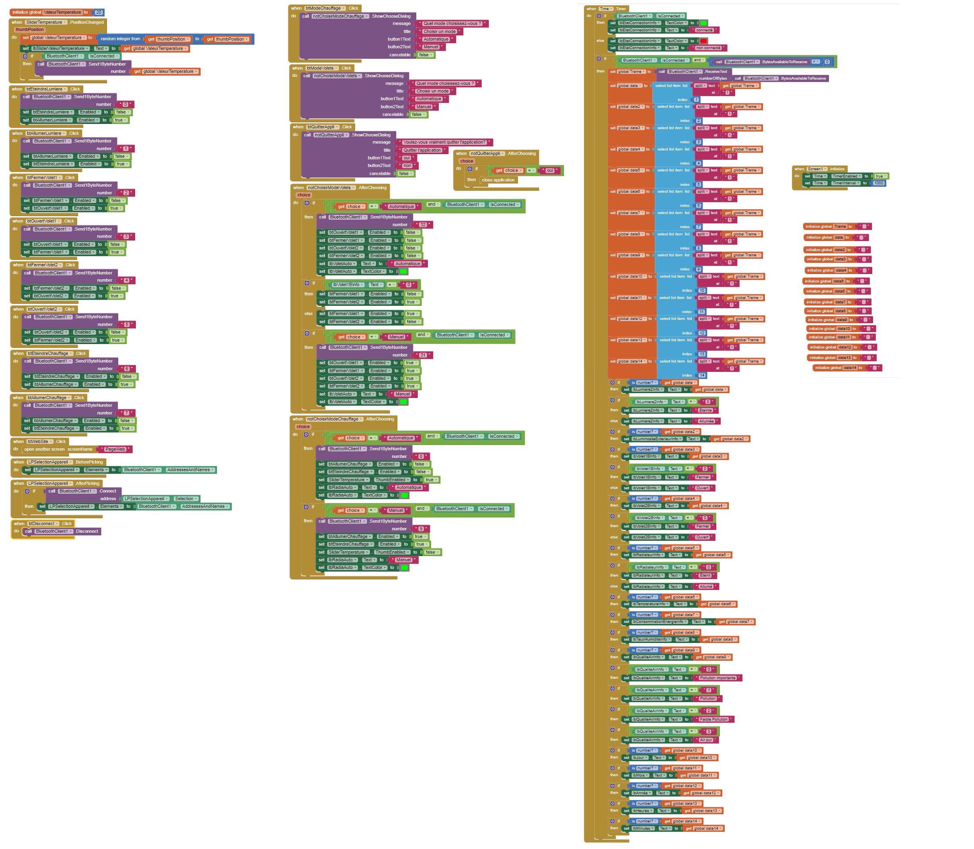
Rapport/ANNexe/Application_Code_final.png
