DrBalf/domotique_bts_sn_ec_projet/Rapport/Benjamin/IMG_1537.JPG

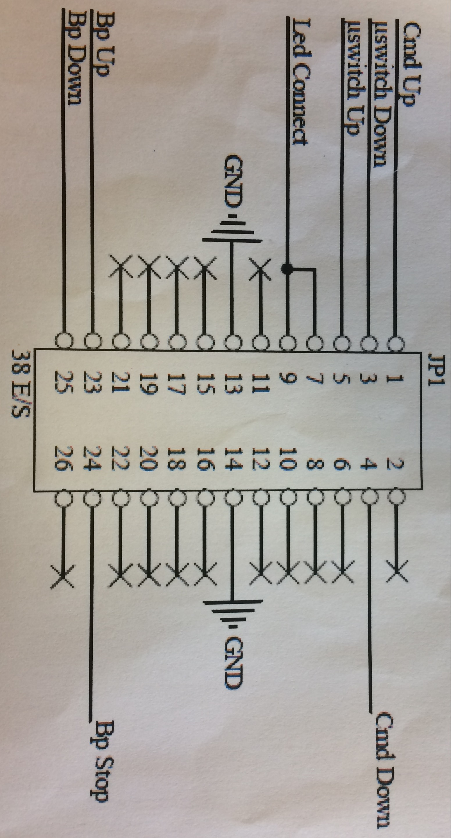
Rapport/Benjamin/IMG_1537.JPG
