DrBalf/domotique_bts_sn_ec_projet/Rapport/img/09590-01.jpg

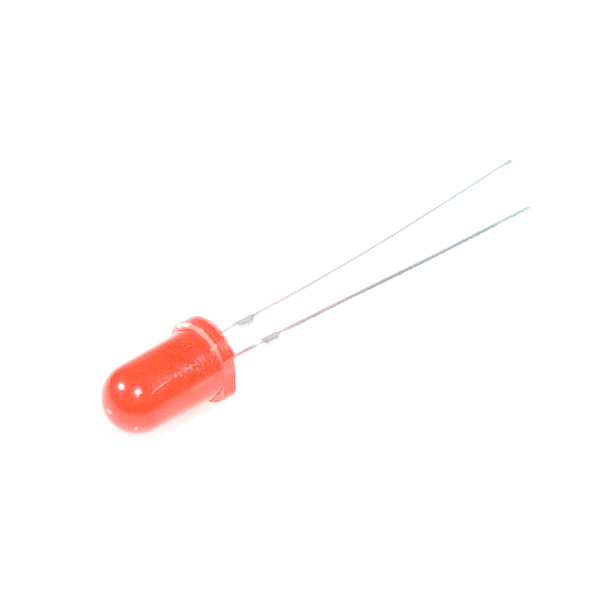
Rapport/img/09590-01.jpg
