DrBalf/domotique_bts_sn_ec_projet/Rapport/img/apps.14931.13510798887551775.c10fff9d-ead5-4a16-aa9c-4e638842c0f4.png

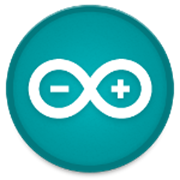
Rapport/img/apps.14931.13510798887551775.c10fff9d-ead5-4a16-aa9c-4e638842c0f4.png
