DrBalf/domotique_bts_sn_ec_projet/Rapport/img/kit-complet-digicode.jpg

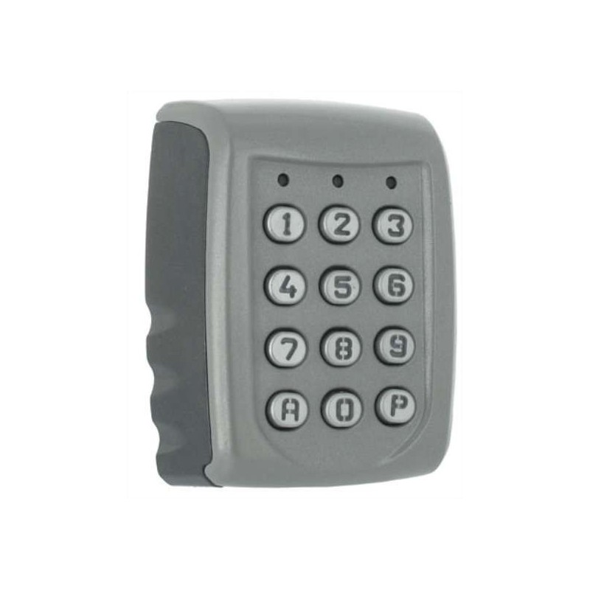
Rapport/img/kit-complet-digicode.jpg
