DrBalf/domotique_bts_sn_ec_projet/Rapport/Lore/img/101020078 1.jpg

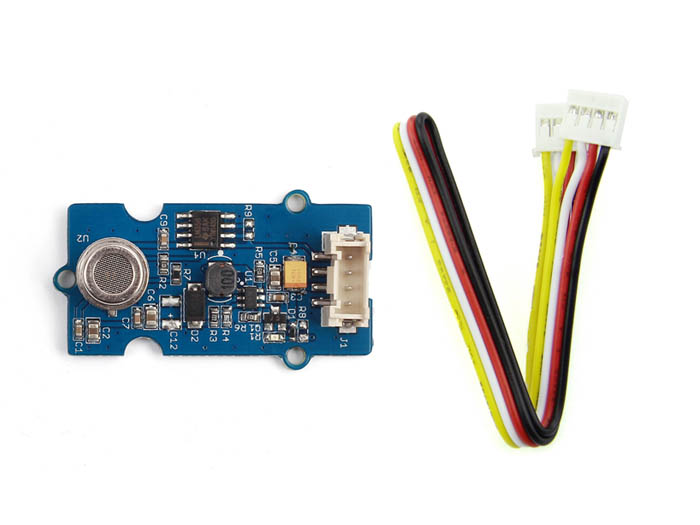
Rapport/Lore/img/101020078 1.jpg
