DrBalf/domotique_bts_sn_ec_projet/Rapport/Lore/img/convertisseur_tension.jpg

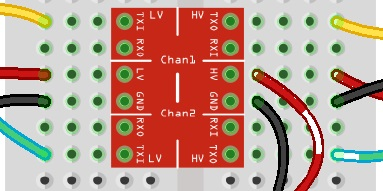
Rapport/Lore/img/convertisseur_tension.jpg
