DrBalf/domotique_bts_sn_ec_projet/Rapport/Nico/Nouveau dossier/Capture.PNG

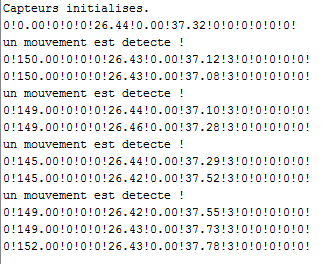
Rapport/Nico/Nouveau dossier/Capture.PNG
