DrBalf/domotique_bts_sn_ec_projet/Rapport/Nico/Nouveau dossier/modul_bluetooth.PNG

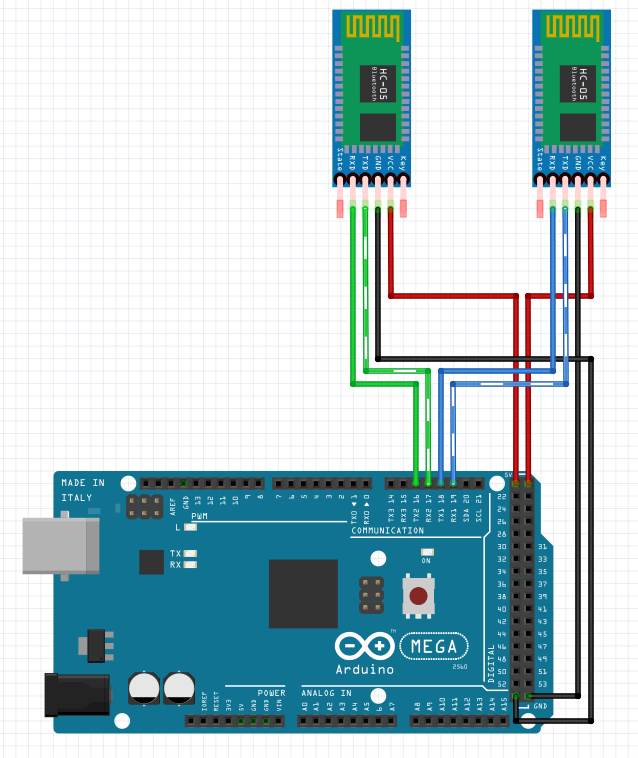
Rapport/Nico/Nouveau dossier/modul_bluetooth.PNG
