DrBalf/domotique_bts_sn_ec_projet/TOOOOOOOOMMY.png

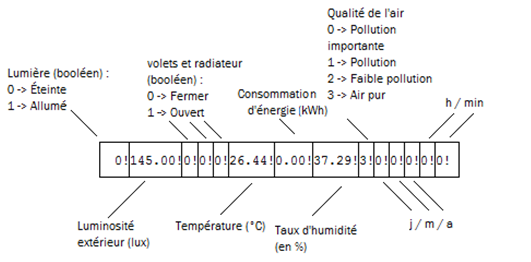
TOOOOOOOOMMY.png
