DrBalf/domotique_bts_sn_ec_projet/Documentation/Seeed-WiKi-master/docs/Bus_Pirate_v3_assembled.md

---
title: Bus Pirate v3 (assembled)
category: MakerPro
bzurl: https://www.seeedstudio.com/bus-pirate-v3-assembled-p-609.html?cPath=174
oldwikiname:  Bus Pirate v3 (assembled)
prodimagename:  Bus%20Pirate%20v3.6interface.jpg
surveyurl: https://www.research.net/r/Bus_Pirate_v3_assembled
sku:      102990038
---


The BusPirate v3 is a universal bus interface that talks to electronics from a PC serial terminal, eliminating a ton of early prototyping effort when working with new or unknown chips.

**Protocols:** 1-Wire, I2C, SPI, JTAG, asynchronous serial (UART), MIDI, PC keyboard, HD44780 LCDs, and generic 2- and 3-wire libraries for custom protocols.

(https://www.seeedstudio.com/bus-pirate-v3-assembled-p-609.html?cPath=174)

##   Features
---
*   USB interface, USB powered

*   0-5.5volt tolerant pins

*   0-6volt measurement probe

*   1Hz-40MHz frequency measurement

*   1kHz – 4MHz pulse-width modulator, frequency generator

*   On-board multi-voltage pull-up resistors

*   On-board 3.3volt and 5volt power supplies with software reset

*   Macros for common operations

*   Bus traffic sniffers (SPI, I2C)

*   A bootloader for easy USB firmware updates

*   Transparent USB-&gt;serial bridge mode

*   10Hz-1MHz low-speed logic analyzer

*   Custom support in AVRDUDE, Flashrom

*   AVR STK500 v2 programmer clone

*   Scriptable from Perl, Python, etc.

*   Translations (currently Spanish and Italian)

##   Cautions
---
This open source hardware and software is distributed in the hope that it will be useful, but WITHOUT ANY WARRANTY; without even the implied warranty of MERCHANTABILITY or FITNESS FOR A PARTICULAR PURPOSE. If you can't accept this risk, please do not buy this hardware.

##   Resources

*   [Bus Pirate manual](http://dangerousprototypes.com/bus-pirate-manual/)

*   [Chip demonstrations](http://dangerousprototypes.com/bus-pirate-manual/#demos)

*   [Latest firmware](http://code.google.com/p/the-bus-pirate/)

*   [Bus Pirate forum](http://whereisian.com/forum/index.php?board=4.0)
