DrBalf/domotique_bts_sn_ec_projet/Documentation/Seeed-WiKi-master/docs/Grove Maker Kit for Intel Joule.md

---
title: Grove Maker Kit for Intel Joule
category: Arduino
bzurl:  https://www.seeedstudio.com/Grove-Maker-Kit-for-Intel-Joule-p-2796.html
prodimagename:
surveyurl: https://www.research.net/r/Grove_Maker_Kit_for_Intel_Joule
sku:    110060577
---



Several weeks ago we published the Grove Shield for Intel Joule, This time, let’s introduce the incredible kit that can help you get started with Intel Joule easy and fast, the Grove maker kit for Intel Joule.

Joule is the most amazing board that Intel published for IoT project in 2016. With the embedded Linux system and rich hardware, Intel Joule can be the best choice for developers to improve their project and publish the prototyping to the market without much effort.

The Grove maker kit for Intel Joule is the best kit for fast building prototype based on Joule. The kit contains a grove bash shield for Joule, with which you can easily add the 13 grove modules that we specifically selected for Joule. If you have the Intel Joule on hand and plan to build a prototype fast, please don’t hesitate to choose the Grove maker kit for Intel Joule.

(https://www.seeedstudio.com/Grove-Maker-Kit-for-Intel-Joule-p-2796.html)

## Features

## Part Introduction

### [Grove Shield for Intel Joule](https://www.seeedstudio.com/Grove-Shield-for-Intel-Joule-p-2782.html)


The Grove Shield for Intel Joule is the key to bridge the Intel Joule to the family of Grove modules. by simplely plugging it onto your Joule board, you can have 8 solid and easy-to-use Grove connectors which includes interfaces like I2C, UART, digital I/Os and analog inputs right away. It also keeps the 2x20 pin headers in case you want more GPIOs for the project. A switch is integrated on board for selecting the working voltage at either 5V or 3.3 V.

### Grove Sensors

|Name|Pic.|Description|
|---|---|---|
|[**Grove Button**](https://www.seeedstudio.com/Grove-Button-p-766.html)||A simple momentary on/off button. Connect it to any digital port on Grove Shield for Intel Joule to use it as an input of High/Low signal to the controller.|
|[**Grove - Sound Sensor**](https://www.seeedstudio.com/Grove-Sound-Sensor-p-752.html)||A sound sensor to detect the sound strength of the environment. Connect it to an anaglog connector to use the sound as incentive signal.|
|[**Grove - Piezo Vibration Sensor**](https://www.seeedstudio.com/Grove-Piezo-Vibration-Sensor-p-1411.html)||It allows you to measure vibration, impact and touch. Connect it to any digital connector on Grove Shield for Intel Joule to receive High signal when vibration is detected.|
|[**Grove - Light Sensor**](https://www.seeedstudio.com/Grove-Light-Sensor-p-746.html)||Compared to conventional Light Dependent Resistor(LDR), the use of phototransistor not only boosts the reliability and sensibility, but also increases the measuring light spectrum. The module outputs analog signals, an 8-bit Analog-Digital-Converter(ADC) would convert it to a range of 0-255.|
|[**Grove - Temperature Sensor**](https://www.seeedstudio.com/Grove-Temperature-Sensor-p-774.html)||Uses a thermistor to detect the ambient temperature(range:-40~+125℃)， and outputs an analog signal connect it to an analog connector.|
|[**Grove - Touch Sensor**](https://www.seeedstudio.com/Grove-Touch-Sensor-p-747.html)||It can detect the change in capacitance when a finger is nearby. You can use it as a button that allows you to replace press with touch. Connect it to any digital connector on Grove Shield for Intel Joule.|
|[**Grove - Rotary Angle Sensor(P)**](https://www.seeedstudio.com/Grove-Rotary-Angle-Sensor(P)-p-1242.html)||It can convert the analog signal(from 0 to 300 degrees) to a linear change analog output between 0 and Vcc. Connect it to an analog connector on Grove Shield for Intel Joule.|

### Grove Actuators
|Item|Pic.|Description|
|--|--|--|
|[**Grove - LCD RGB Backlight**](https://www.seeedstudio.com/Grove-LCD-RGB-Backlight-p-1643.html)||A simple user interface that supports user-defined characters and a colorful RGB backlight. Connect it to an I2C on Grove Shield for Intel Joule to display the information you need.|
|[**Grove - Buzzer**](https://www.seeedstudio.com/Grove-Buzzer-p-768.html)||A simple buzzer with Grove connector that can connect to both digital and analog connectors. It will emit a tone when the output is HIGH. Alternatively, it can be connected to an analog pulse-width modulation output to generate various tones and effects.|
|[**Grove - Red LED**](https://www.seeedstudio.com/Grove-Red-LED-p-1142.html)||This is a group of simple LEDs. Connect them to any digital port on Grove Shield for Intel Joule to light them up with a HIGH output.|
|[**Grove -Green LED**](https://www.seeedstudio.com/Grove-Green-LED-p-1144.html)||This is a group of simple LEDs. Connect them to any digital port on Grove Shield for Intel Joule to light them up with a HIGH output.|
|[**Grove - Blue LED**](https://www.seeedstudio.com/Grove-Blue-LED-p-1139.html)||This is a group of simple LEDs. Connect them to any digital port on Grove Shield for Intel Joule to light them up with a HIGH output.|
|[**Gear Stepper Motor with Driver**](https://www.seeedstudio.com/Gear-Stepper-Motor-with-Driver-p-1685.html)||It allows you to drive a stepper motor by connecting the stepper motor to the driver board, and connect the driver to any digital port on Grove Shield for Intel Joule that has a PWM output. Then you can control your stepper motor easily with lines of code.

## Resources
- [Grove Shield for Intel Joule v1.0.pdf](https://github.com/SeeedDocument/Grove_Maker_Kit_for_Intel_Joule/raw/master/res/Grove%20Shield%20for%20Intel%20Joule%20v1.0.pdf)
- [Grove Shield for Intel Joule_eagle.zip](https://github.com/SeeedDocument/Grove_Maker_Kit_for_Intel_Joule/raw/master/res/Grove%20Shield%20for%20Intel%20Joule_eagle.zip)
