DrBalf/domotique_bts_sn_ec_projet/Documentation/Seeed-WiKi-master/docs/How_to_choos_A_Gas_Sensor.md

# How to Choose A Gas Sensor
---
title: How to Choose A Gas Sensor
category: Tutorial
oldwikiname:  How to Choose A Gas Sensor
prodimagename:
surveyurl: https://www.research.net/r/How_to_Choose_A_Gas_Sensor
---

If you search “gas sensor” on [www.seeedstudio.com](http://www.seeedstudio.com) , you can find a lot of gas sensor. We know that the air component is diverse, and a certain gas sensor can detect one or more air components, so we designed a series of gas sensor.

There are about 10 kind of gas sensor for sale. They have similar name, it’s likely to cause confusion. Hope that through the following presentation, we can help you to choose the appropriate gas sensor easily.

It’s obvious that different sensor can detect the same gas. Such as MQ-2, MQ-3, MQ-5 Alcohol Sensor, Grove – HCHO Sensor can detect Alcohol. So if you want an alcohol sensor, then which on should you chosen? Although most of the above sensors are able to detect Alcohol, but you should know that they have different range to Alcohol.

</div></div>

And sometimes, we want to test many gases in one sensor, so how should we choose it ?

</div></div>

Following is the link of all gases to Bazaar, choose the one you needed!

*   [Grove - Gas Sensor(MQ-2)](http://www.seeedstudio.com/depot/grove-gas-sensormq2-p-937.html?cPath=25_27)

*   [Grove - Gas Sensor(MQ-3)](http://www.seeedstudio.com/depot/grove-gas-sensormq3-p-1418.html?cPath=25_27)

*   [Grove - Gas Sensor(MQ-5)](http://www.seeedstudio.com/depot/grove-gas-sensormq5-p-938.html?cPath=25_27)

*   [Grove - Gas Sensor(MQ-9)](http://www.seeedstudio.com/depot/grove-gas-sensormq9-p-1419.html?cPath=25_27)

*   [Grove - Gas Sensor(O2)](http://www.seeedstudio.com/depot/grove-gas-sensoro2-p-1541.html?cPath=25_27)

*   [Grove - HCHO Sensor](http://www.seeedstudio.com/depot/grove-hcho-sensor-p-1593.html?cPath=25_27)

*   [Grove - Alcohol Sensor](http://www.seeedstudio.com/depot/grove-alcohol-sensor-p-764.html?cPath=25_27)

*   [Grove - CO2 Sensor](http://www.seeedstudio.com/depot/Grove-CO2-Sensor-p-1863.html)

*   [Grove - Multichannel Gas Sensor](http://www.seeedstudio.com/depot/Grove-Multichannel-Gas-Sensor-p-2502.html)

*   [Grove - Dust Sensor](http://www.seeedstudio.com/depot/Grove-Dust-Sensor-p-1050.html)
