DrBalf/domotique_bts_sn_ec_projet/Documentation/Seeed-WiKi-master/docs/LinkIt_ONE_Tutorial-Marquee.md

---
title: LinkIt ONE Tutorial - Marquee
category: Tutorial
oldwikiname:  LinkIt ONE Tutorial - Marquee
prodimagename:
surveyurl: https://www.research.net/r/LinkIt_ONE_Tutorial-Marquee
---
**What We’re Doing**

The experiments in the previous sections used only one LED but to show dazzling light effects lets use three LEDs. Make connections as shown in the Fig 4.2 and upload the code given below and observe the changes that happens.

**Things you need**

*   LinkIt One x 1
*   Break board x 1

*   Resistors 330Ω,1kΩ x 3

*   5mm LED x 3

*   Transistor(2N3904) x 3

**Schematic**



**Connection**



**Code**

Please click on the button below to download the code for the kit:

(https://github.com/Seeed-Studio/Sidekick_Basic_Kit_for_LinkIt)

You can unzip the file to the **Examples** folder of your Arduino IDE.

To access the demo code open:

_File -&gt; Examples -&gt; Starter Kit for LinkIt -&gt; Basic -&gt; L4_Control_LEDs_
```
const int pinLed1    = 2;                       // pin of led1
const int pinLed2    = 3;                       // pin of led2
const int pinLed3    = 4;                       // pin of led3

void setup()
{
    pinMode(pinLed1, OUTPUT);                   // set all pin OUTPUT
    pinMode(pinLed2, OUTPUT);
    pinMode(pinLed3, OUTPUT);
}

void loop()
{
    digitalWrite(pinLed4, LOW);                 // led4 off
    digitalWrite(pinLed1, HIGH);                // led1 on
    delay(100);

    digitalWrite(pinLed1, LOW);                 // led1 off
    digitalWrite(pinLed2, HIGH);                // led2 on

    delay(100);

    digitalWrite(pinLed2, LOW);                 // led2 off
    digitalWrite(pinLed3, HIGH);                // led3 on

    delay(100);

    digitalWrite(pinLed3, LOW);                 // led3 off
    digitalWrite(pinLed4, HIGH);                // led4 on

    delay(100);
}
```

**Troubleshooting**

*   Check the polarity of the LED's.

*   Ensure that you have connected the LED' to the correct port pins.

**Making it better**

Upload the following code with the same breadboard connection in order to obtain different flashing effects.

To access the demo code open:

_File -&gt; Examples -&gt; Starter Kit for LinkIt -&gt; Extend_Lesson –&gt; L4_Control_LEDs_Speed_

**More ideas**

Modify the existing code such that the frequency of LED blinking increases.

**Reference**

*   [The Basics](/LinkIt_ONE_Tutorial-The_Basics)

*   [Hello World](/LinkIt_ONE_Tutorial-Hello_World)

*   [Push Button](/LinkIt_ONE_Tutorial-Push_Button)

*   [Marquee](/LinkIt_ONE_Tutorial-Marquee)

*   [Colorful World](/LinkIt_ONE_Tutorial-Colorful_World)

*   [Analog Interface](/LinkIt_ONE_Tutorial-Analog_Interface)

*   [Mini Servo](/LinkIt_ONE_Tutorial-Mini_Servo)

*   [Light Sensor](/LinkIt_ONE_Tutorial-Light_Sensor)

*   [SMS Control the LED](/LinkIt_ONE_Tutorial-SMS_control_the_LED)

*   [Get Temperature with Webpage](/LinkIt_ONE_Tutorial-Get_temperature_with_Webpage)
