DrBalf/domotique_bts_sn_ec_projet/Documentation/Seeed-WiKi-master/docs/LinkIt_ONE_Tutorial-Push_Button.md

---
title: LinkIt ONE Tutorial - Push Button
category: Tutorial
oldwikiname:  LinkIt ONE Tutorial - Push Button
prodimagename:
surveyurl: https://www.research.net/r/LinkIt_ONE_Tutorial-Push_Button
---
**What We’re Doing**

We now got an insight of how a software and hardware works from the previous chapter. In this chapter we will learn how to integrate both software and hardware for the control of the LED. Make breadboard connections as shown in the Fig 3.2 and upload the code. Now this circuit operates as a two way switch when you press the left side push button switch the LED glows and when the right side push button is pressed the LED is switched OFF.

**Things you need**

*   LinkIt One x 1

*   Break board x 1

*   Resistors 330Ω,1kΩ x 1

*   Resistor 10kΩ x 2

*   5mm LED x 1

*   Transistor(2N3904) x 1

*   Push Button switches x 2

**Schematic**



**Connection**



**Code**

Please click on the button below to download the code for the kit:

(https://github.com/Seeed-Studio/Sidekick_Basic_Kit_for_LinkIt)

You can unzip the file to the **Examples** folder of your Arduino IDE.

To access the demo code open:

_File -&gt; Examples -&gt; Starter Kit for LinkIt -&gt; Basic -&gt; L3_Control_LED_Button_
```
const int pinLED = 3;                      // LED connect to D13

const int btnOn  = 5;                       // button on
const int btnOff = 6;                       // button off

void setup()
{
    pinMode(pinLED, OUTPUT);                // set direction of D13-OUTPUT
    pinMode(btnOff, INPUT);                 // set direction of D2-INPUT
    pinMode(btnOn, INPUT);
}

void loop()
{
    if(0 == digitalRead(btnOn))            // button on pressed
    {
        digitalWrite(pinLED, HIGH);
    }

    if(0 == digitalRead(btnOff))
    {
        digitalWrite(pinLED, LOW);
    }
}
```

**Making it better**

Keeping the same hardware connection upload the following code. The luminosity brightens when the left push button switch is pressed and fades when the right push button switch is pressed.

To access the demo code open:：

_File -&gt; Examples -&gt; Starter Kit for LinkIt -&gt; Extend_Lesson –&gt; L3_Brightness_

**More ideas**

How will you modify the code such that the blinking frequency of the LED changes?

**Reference**

*   [The Basics](/LinkIt_ONE_Tutorial-The_Basics)

*   [Hello World](/LinkIt_ONE_Tutorial-Hello_World)

*   [Push Button](/LinkIt_ONE_Tutorial-Push_Button)

*   [Marquee](/LinkIt_ONE_Tutorial-Marquee)

*   [Colorful World](/LinkIt_ONE_Tutorial-Colorful_World)

*   [Analog Interface](/LinkIt_ONE_Tutorial-Analog_Interface)

*   [Mini Servo](/LinkIt_ONE_Tutorial-Mini_Servo)

*   [Light Sensor](/LinkIt_ONE_Tutorial-Light_Sensor)

*   [SMS Control the LED](/LinkIt_ONE_Tutorial-SMS_control_the_LED)

*   [Get Temperature with Webpage](/LinkIt_ONE_Tutorial-Get_temperature_with_Webpage)
