DrBalf/domotique_bts_sn_ec_projet/Documentation/Seeed-WiKi-master/docs/MakerPro.md

---
title: MakerPro Introduction
nointro:
---

Shenzhen is like the paradise of makers. As an open-source company which based in Shenzhen, SeeedStudio has the advantage and ability to sourcing and provide all the best resources to makers all around the world. MakerPro is the section where the products are not developed by Seeed, but sourcing directly from Shenzhen. 

The following MakerPro product are available here:

## Product  List
---

Here is the list of the MakerPro Boards you can find in the Seeed WiKi. The list will be constantly updated.

- [0.5w Solar Panel 55*70](/0.5w_Solar_Panel_55x70/)
- [1.5W Solar Panel 81*137](/1.5W_Solar_Panel_81x137/)
- [125Khz RFID module - UART](/125Khz_RFID_module-UART/)
- [13.56Mhz RFID module - IOS/IEC 14443 type a](/13.56Mhz_RFID_module-IOS-IEC_14443_type_a/)
- [1w Solar Panel 80*100](/1w_Solar_Panel_80x100/)
- [2.5W Solar Panel 116*160](/2.5W_Solar_Panel_116x160/)
- [2KM Long Range RF link kits w/ encoder and decoder](/2KM_Long_Range_RF_link_kits_w_encoder_and_decoder/)
- [3.6V Micro hydro generator](/3.6V_Micro_hydro_generator/)
- [315MHz Simple RF Link Kit](/315MHz_Simple_RF_Link_Kit/)
- [315Mhz RF link kit](/315Mhz_RF_link_kit/)
- [315Mhz Wireless car key fob with key chain](/315Mhz_Wireless_car_key_fob_with_key_chain/)
- [315Mhz remote relay switch kits - 2 channels](/315Mhz_remote_relay_switch_kits-2_channels/)
- [3W Solar Panel 138*160](/3W_Solar_Panel_138x160/)
- [433Mhz RF Link Kit](/433Mhz_RF_Link_Kit/)
- [AVR USB Programmer](/AVR_USB_Programmer/)
- [Bicycle Dynamo With Bracket - 6V 3W](/Bicycle_Dynamo_With_Bracket-6V_3W/)
- [Bluetooth Multimeter](/Bluetooth_Multimeter/)
- [Bluetooth V4.0 HM-11 BLE Module](/Bluetooth_V4.0_HM_11_BLE_Module/)
- [Bracket for Infrared Proximity Sensor](/Bracket_for_Infrared_Proximity_Sensor/)
- [Bugduino](/Bugduino/)
- [Bus Pirate v3 (assembled)](/Bus_Pirate_v3_assembled/)
- [CUI32Stem](/CUI32Stem/)
- [Capacitance Meter Kit](/Capacitance_Meter_Kit/)
- [Codec-Adaptive Wireless Relay](/Codec-Adaptive_Wireless_Relay/)
- [DC framework miniature solenoid VL-0063](/DC_framework_miniature_solenoid_VL-0063/)
- [DC framework solenoid HCNE1-0520](/DC_framework_solenoid_HCNE1-0520/)
- [DC framework solenoid HCNE1-0630](/DC_framework_solenoid_HCNE1-0630/)
- [DSO Nano](/DSO_Nano/)
- [DSO Nano v3](/DSO_Nano_v3/)
- [DSO Nano/Development](/DSO_Nano-Development/)
- [DSO Nano/OpenOCD gdb](/DSO_Nano-OpenOCD_gdb/)
- [DSO Nano/Qemu gdb](/DSO_Nano-Qemu_gdb/)
- [DSO Nano/gcc](/DSO_Nano-gcc/)
- [DSO Quad](/DSO_Quad/)
- [DSO Quad Manual (by the community)](/DSO_Quad_Manual_by_the_community/)
- [DSO Quad:Beta HW](/DSO_Quad-Beta_HW/)
- [DSO Quad:Building Firmware](/DSO_Quad-Building_Firmware/)
- [DSO Quad:Calibration](/DSO_Quad-Calibration/)
- [Danger Shield Complete Kits](/Danger_Shield_Complete_Kits/)
- [FSM-55](/FSM-55/)
- [FST-01](/FST-01/)
- [Fubarino SD](/Fubarino_SD/)
- [G1&#34; Water Flow Sensor](/G1_Water_Flow_Sensor/)
- [G1&amp;2&#34; Water Flow Sensor](/G1_and_2_inch_Water_Flow_Sensor/)
- [G1&#39;1/4 Water Flow sensor](/G1-1-4_Water_Flow_sensor/)
- [G1/8&#34; Water Flow Sensor](/G1-8_Water_Flow_Sensor/)
- [G3/4 Water Flow sensor](/G3-4_Water_Flow_sensor/)
- [GPS Bee kit](/GPS_Bee_kit/)
- [Grove - Base Shield for IOIO-OTG](/Grove-Base_Shield_for_IOIO-OTG/)
- [LCD 16*2 Characters- Green Yellow back light](/LCD_16-2_Characters-Green_Yellow_back_light/)
- [LCD 8*2 Characters- Blue back light](/LCD_8-2_Characters-Blue_back_light/)
- [LoNet 808 - Mini GSM/GPRS &#43; GPS Breakout](/LoNet_808-Mini_GSM_GPRS_Plus_GPS_Breakout/)
- [M11*1.25 Water Flow Sensor](/M11_1.25_Water_flow_Sensor/)
- [Matrix Clock](/Matrix_Clock/)
- [Mini Soldering Iron](/Mini_Soldering_Iron/)
- [PIR Motion sensor module](/PIR_Motion_sensor_module/)
- [Photo Reflective Sensor](/Photo_Reflective_Sensor/)
- [Photo interrupter (OS25B10)](/Photo_interrupter_OS25B10/)
- [Piezo Sensor - MiniSense 100](/Piezo_Sensor-MiniSense_100/)
- [RF Explorer Software](/RF_Explorer_Software/)
- [RGBW Stripe WireLess Shield V1.0](/RGBW_Stripe_WireLess_Shield_V1.0/)
- [Raspberry PI B&#43; Case](/Raspberry_PI_Bplus_Case/)
- [Raspberry Pi 3 Model B](/Raspberry_Pi_3_Model_B/)
- [Renbotics ServoShield Rev](/Renbotics_ServoShield_Rev/)
- [SDLogger - Open Hardware Data Logger](/SDLogger-Open_Hardware_Data_Logger/)
- [Scream out loud - 110dBA fixed tone Siren](/Scream_out_loud-110dBA_fixed_tone_Siren/)
- [Shield MaTrix V0.9](/Shield-MaTrix-V0.9b/)
- [Starter bundle harness V1.0](/Starter_bundle_harness_V1/)
- [Ultra Sonic range measurement module](/Ultra_Sonic_range_measurement_module/)
- [Weight Sensor (Load Cell)0-500g](/Weight_Sensor_Load_Cell_0-500g/)
- [WiFi Serial Transceiver Module](/WiFi_Serial_Transceiver_Module/)
- [WireLess Gate Shield V1.0](/WireLess_Gate_Shield_V1.0/)
- [Wireless Sensor Node - Solar Kit](/Wireless_Sensor_Node-Solar_Kit/)
