DrBalf/domotique_bts_sn_ec_projet/Documentation/Seeed-WiKi-master/docs/Tutorial.md

---
title: Tutorial Introduction
nointro:
---

Here is the list of the Tutorial you can find in the Seeed WiKi. The list will be constantly updated.

- [A Comparison of Different Grove Temperature Sensors](/A_Comparison_of_Different_Grove_Temperature_Sensors/)
- [A Handy Serial Library](/A_Handy_Serial_Library/)
- [AT Command Tester](/AT_Command_Tester/)
- [AT Command Tester Application](/AT_Command_Tester_Application/)
- [Arduino Common Error](/Arduino_Common_Error/)
- [Arduino IDE for RePhone Kit](/Arduino_IDE_for_RePhone_Kit/)
- [Arduino Software I2C user guide](/Arduino_Software_I2C_user_guide/)
- [Dfu-util](/Dfu-util/)
- [Download Arduino and install Arduino driver](/Download_Arduino_and_install_Arduino_driver/)
- [Eclipse IDE for RePhone Kit](/Eclipse_IDE_for_RePhone_Kit/)
- [FM Receiver](/FM_Receiver/)
- [Getting Started with Seeeduino](/Getting_Started_with_Seeeduino/)
- [Grove Inventor Kit for micro:bit](/Grove_Inventor_Kit_for_microbit/)
- [Guide to use demos downloaded from Seeed&#39;s Github](/Guide_to_use_demos_downloaded_from_Seeed-s_Github/)
- [How To Choose The Right Cable](/How_To_Choose_The_Right_Cable/)
- [How To Use Sketchbook](/How_To_Use_Sketchbook/)
- [How to Add Seeed boards to Arduino IDE](/Seeed_Arduino_Boards/)
- [How to Chose A Gas Sensor](/How_to_Chose_A_Gas_Sensor/)
- [How to detect finger touch](/How_to_detect_finger_touch/)
- [How to edit a document](/How_To_Edit_A_Document/)
- [How to install an Arduino library](/How_to_install_Arduino_Library/)
- [How to use and write a library](/How_to_use_and_write_a_library/)
- [I2C And I2C Address of Seeed Product](/I2C_And_I2C_Address_of_Seeed_Product/)
- [IR Remote](/IR_Remote/)
- [IoT Fast Prototyping Kit S5D9](/IoT_Fast_Prototyping_Kit S5D9/)
- [JavaScript for RePhone](/JavaScript_for_RePhone/)
- [Joystick Control RGB Led](/Joystick_Control_RGB_Led/)
- [Light Sensor and LED Bar](/Light_Sensor_and_LED_Bar/)
- [LightView 201k Digital display module](/LightView_201k_Digital_display_module/)
- [LinkIt ONE Tutorial - Analog Interface](/LinkIt_ONE_Tutorial-Analog_Interface/)
- [LinkIt ONE Tutorial - Colorful World](/LinkIt_ONE_Tutorial-Colorful_World/)
- [LinkIt ONE Tutorial - Get temperature with Webpage](/LinkIt_ONE_Tutorial-Get_temperature_with_Webpage/)
- [LinkIt ONE Tutorial - Hello World](/LinkIt_ONE_Tutorial-Hello_World/)
- [LinkIt ONE Tutorial - Light Sensor](/LinkIt_ONE_Tutorial-Light-Sensor/)
- [LinkIt ONE Tutorial - Marquee](/LinkIt_ONE_Tutorial-Marquee/)
- [LinkIt ONE Tutorial - Mini Servo](/LinkIt-ONE-Tutorial---Mini-Servo/)
- [LinkIt ONE Tutorial - Push Button](/LinkIt_ONE_Tutorial-Push_Button/)
- [LinkIt ONE Tutorial - SMS control the LED](/LinkIt_ONE_Tutorial-SMS_control_the_LED/)
- [LinkIt ONE Tutorial - The Basics](/LinkIt_ONE_Tutorial-The_Basics/)
- [Lua for RePhone](/Lua_for_RePhone/)
- [Project Eight - Thermostat](/Project_Eight-Thermostat/)
- [Project Five – Relay Control](/Project_Five-Relay_Control/)
- [Project Four – Noise Maker](/Project_Four-Noise_Maker/)
- [Project One - Blink](/Project_One-Blink/)
- [Project One - Double Blink](/Project_One-Double_Blink/)
- [Project Seven - Temperature](/Project_Seven-Temperature/)
- [Project Six – LCD Demonstration](/Project_Six-LCD_Demonstration/)
- [Project Three – Analog Input v1.0b](/Project_Three-Analog_Input_v1b/)
- [Project Two - Digital Input v1.0b](/Project_Two-Digital_Input_v1.0b/)
- [Project Two – Digital Input](/Project_Two-Digital_Input/)
- [RFID Control LED](/RFID_Control_LED/)
- [RePhone APIs - Audio](/RePhone_APIs-Audio/)
- [Relay Control LED](/Relay_Control_LED/)
- [Replacement LCD Screen for DSO nano](/Replacement_LCD_Screen_for_DSO_nano/)
- [Secret Box](/Secret_Box/)
- [Seeeduino Buying Guide](/Seeeduino_Buying_Guide/)
- [Service for Fusion PCB](/Service_for_Fusion_PCB/)
- [Sketchbook of Sidekick Advanced Kit](/Sketchbook_of_Sidekick_Advanced_Kit/)
- [Sound Sensor And LED Bar](/Sound_Sensor_And_LED_Bar/)
- [Suli](/Suli/)
- [Temperature Sensor](/temperature_sensor/)
- [Things We Make](/Things_We_Make/)
- [Upload Code](/Upload_Code/)
- [Use External Editor](/Use_External_Editor/)
- [Xadow IO pin mapping](/Xadow_IO_pin_mapping/)
- [Zigbee Networking with XBee Series 2 and Seeed&#39;s Products](/Zigbee_Networking_with_XBee_Series_2_and_Seeeds_Products/)
