DrBalf/domotique_bts_sn_ec_projet/Rapport/Benjamin/testIntegration.png

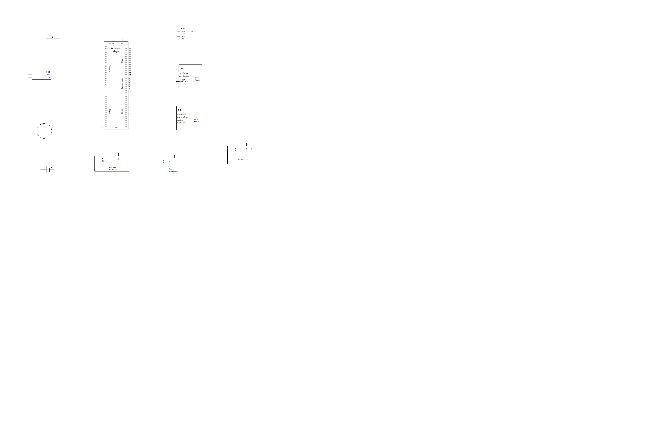
Rapport/Benjamin/testIntegration.png
