DrBalf/domotique_bts_sn_ec_projet/Documentation/capteur_mouvement/Grove_PIR_Sensor_v1.2.pdf

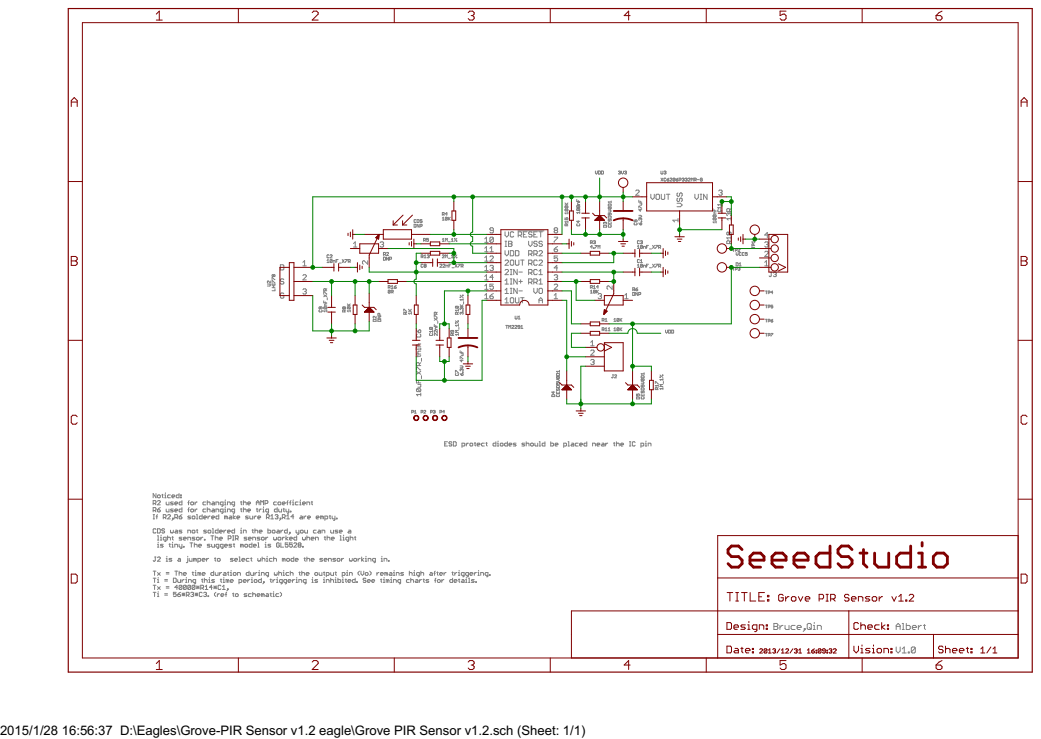
[picture p318: page 1]

2015/1/28 16:56:37 D:\Eagles\Grove-PIR Sensor v1.2 eagle\Grove PIR Sensor v1.2.sch (Sheet: 1/1)
