DrBalf/domotique_bts_sn_ec_projet/Documentation/capteur_mouvement/Fresnel_lens_8120.pdf

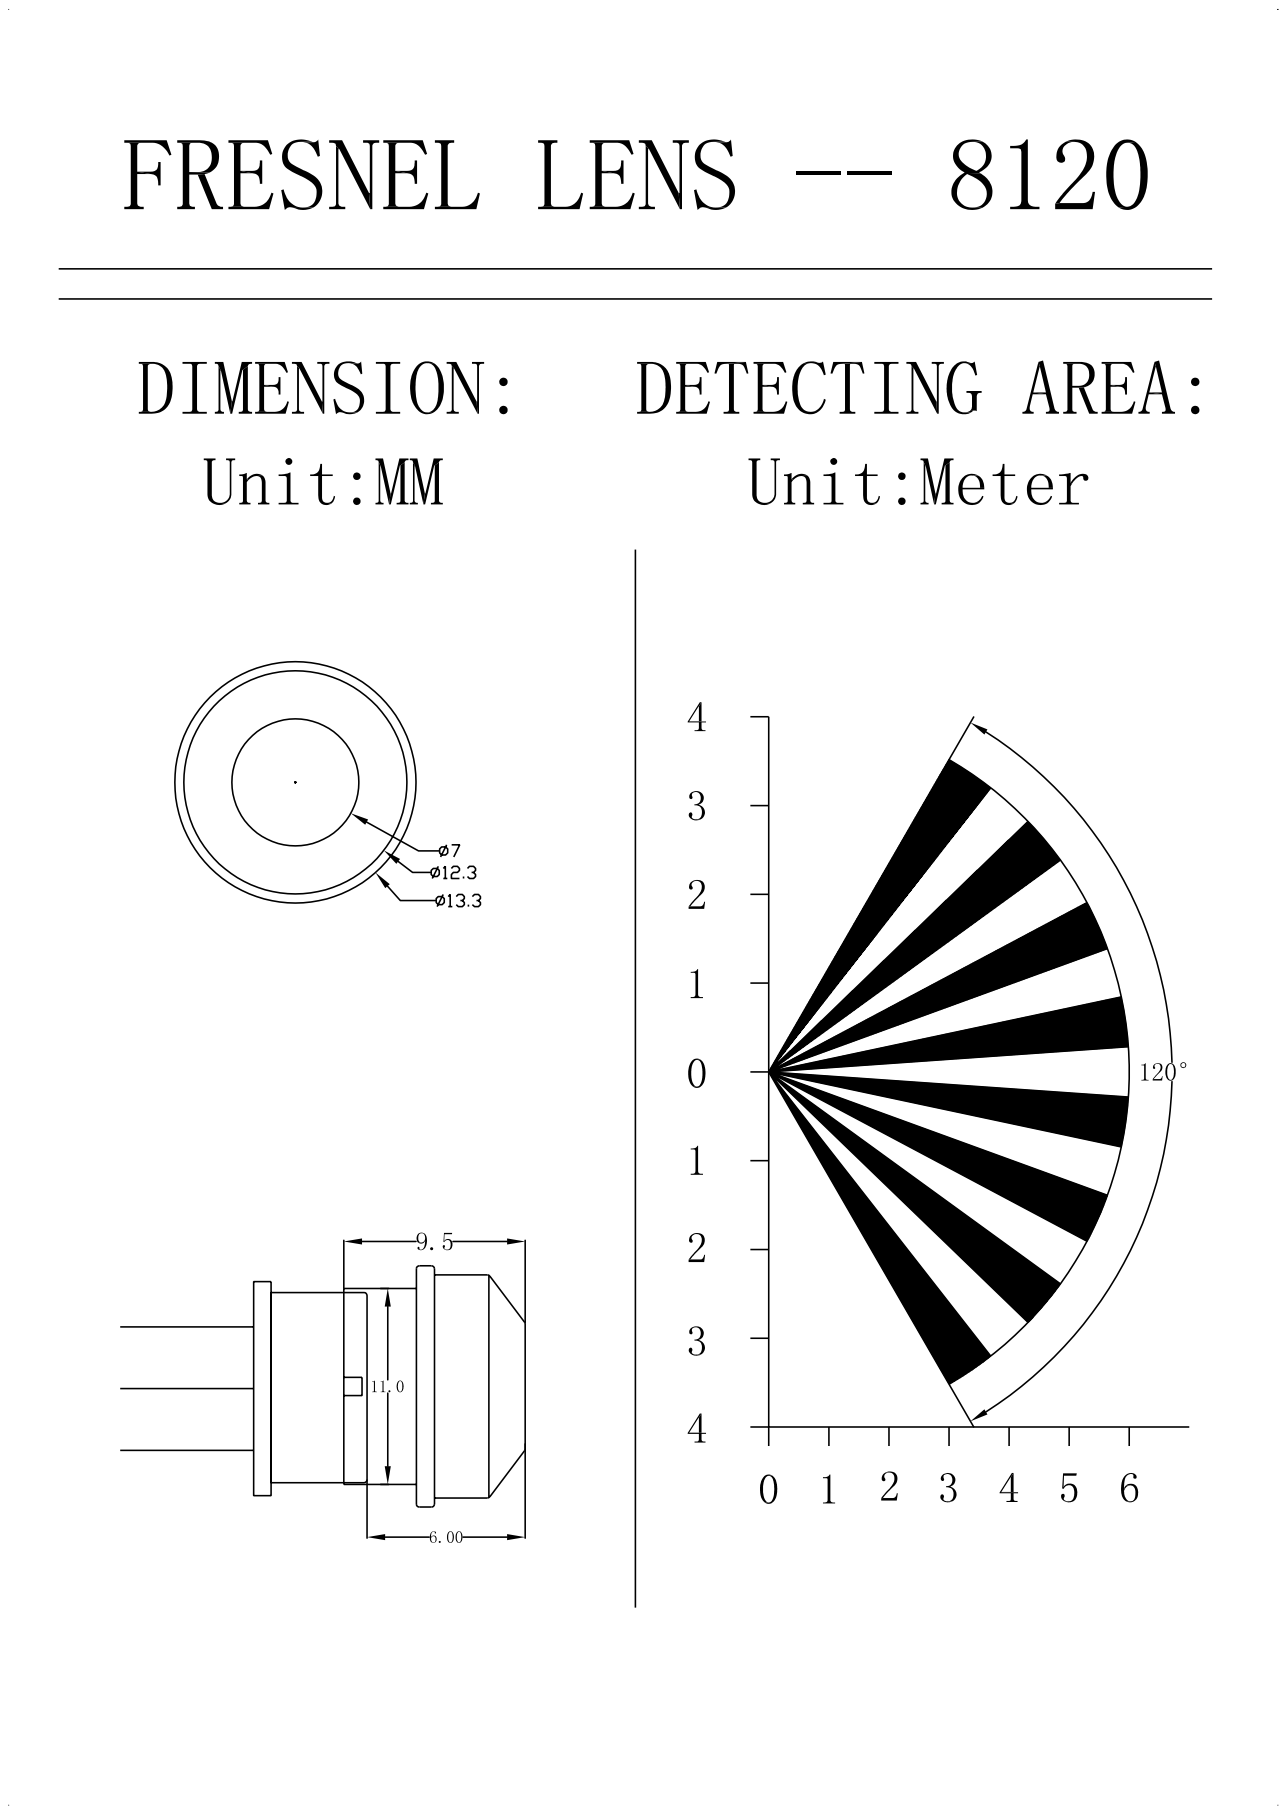
[picture p319: page 1]
