DrBalf/domotique_bts_sn_ec_projet/Documentation/capteur_mouvement/Grove - PIR motion sensor v1.1b PCB.pdf

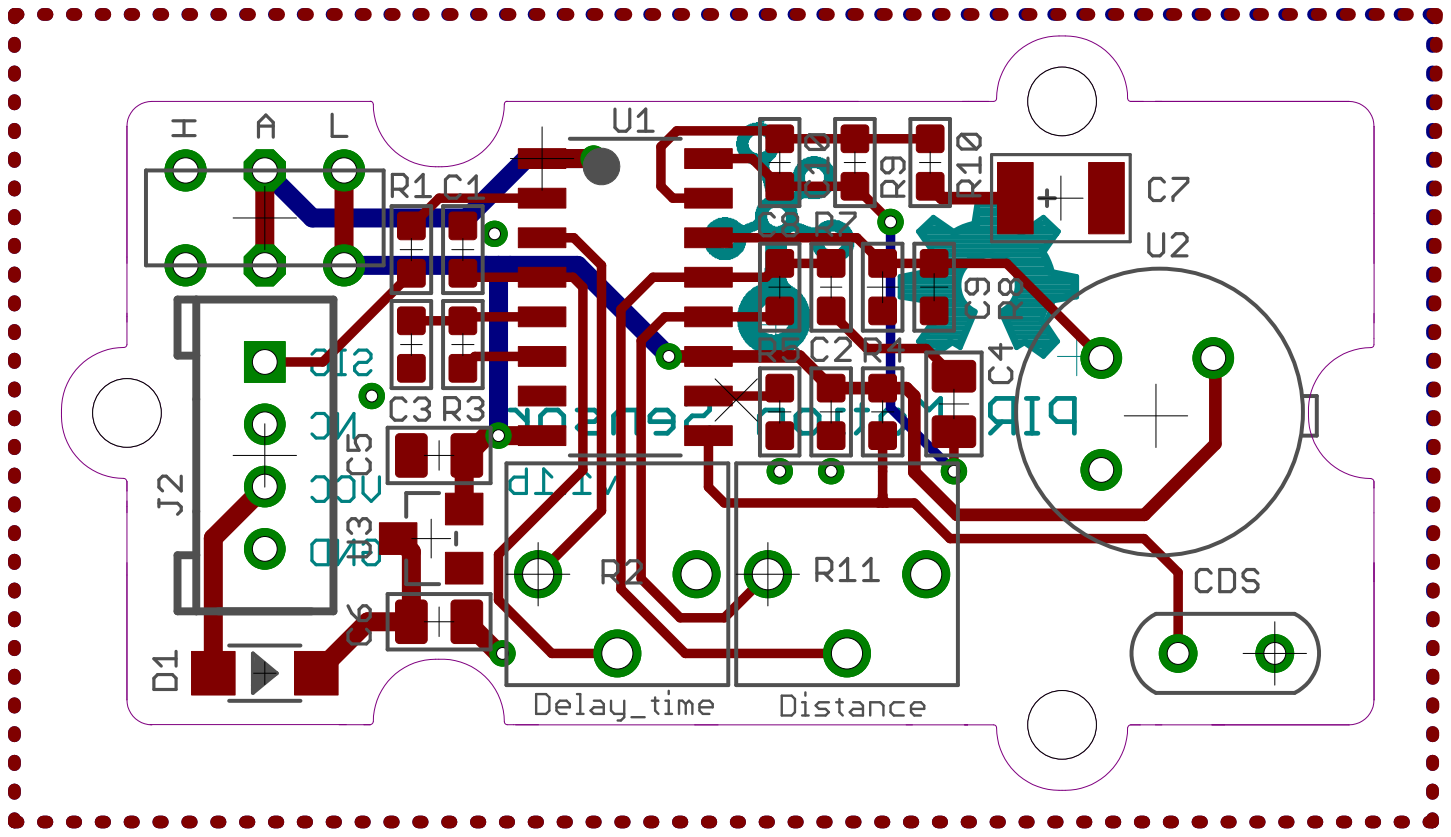
[picture p320: page 1]
