DrBalf/domotique_bts_sn_ec_projet/(list of files, drawings)

Other design files:
Materiels/Benjamin/confort.fzz
Materiels/Benjamin/regroupement.fzz
Materiels/Benjamin/smokedete.fzz
Materiels/Benjamin/Untitled Sketch.fzz
Rapport/Lore/fritzing/AQ_T_H_R.fzz
Rapport/Lore/fritzing/regroupement_final.fzz
Rapport/Lore/fritzing/regroupement_final_final.fzz
Rapport/Lore/fritzing/RTC_SSD_CE.fzz
Rapport/Nico/Nouveau dossier/Montage_ArduinoMega_Bluetooth.fzz
