DrBalf/domotique_bts_sn_ec_projet/Materiels/Aurelien/test_unitaire/thermometre/BMP180_Breakout-master/hardware/SparkFun_BMP180_Breakout.brd

## EAGLE design Materiels/Aurelien/test_unitaire/thermometre/BMP180_Breakout-master/hardware/SparkFun_BMP180_Breakout.brd (2018-01-29)

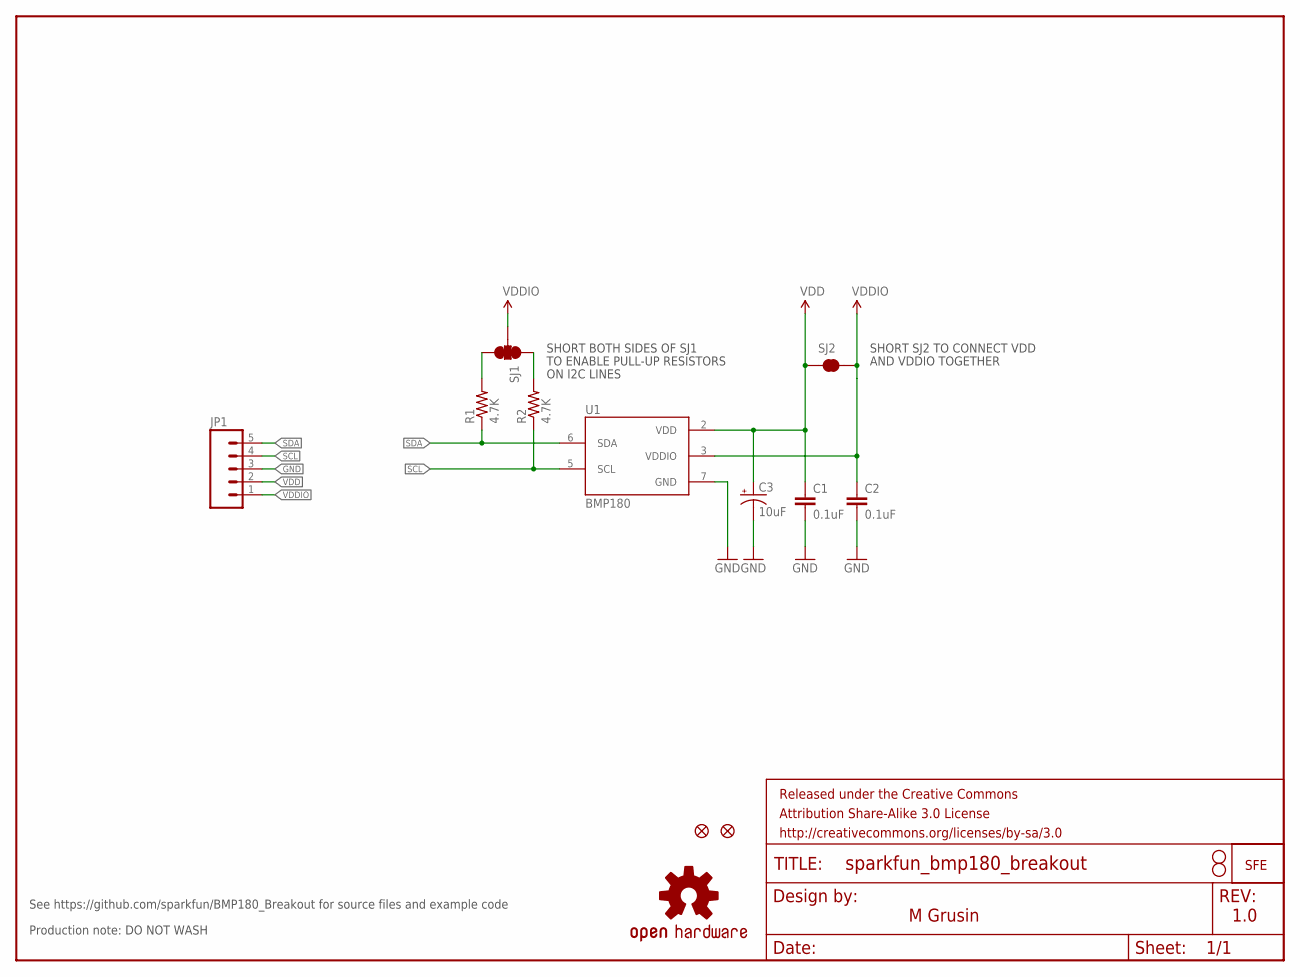
[picture p321: schematic SparkFun_BMP180_Breakout.sch]

Parts:
C1, C2: 0.1uF; 0603-CAP
C3: 10uF; EIA3216
FID1, FID2: FIDUCIALUFIDUCIAL; MICRO-FIDUCIAL
FRAME1: FRAME-LETTER; CREATIVE_COMMONS
JP1: M05_ROUNDONLY_NOSILK; 1X05_ROUNDONLY_NOSILK
LOGO1: LOGO-SFENW2; SFE-NEW-WEB
LOGO2: OSHW-LOGOS; OSHW-LOGO-S
R1, R2: 4.7K; 0603-RES
SJ1: SOLDERJUMPER_2WAYPASTE1&2&3; SJ_3_PASTE1&2&3
SJ2: SOLDERJUMPERNC; SJ_2S
STANDOFF1, STANDOFF2: STAND-OFF
U1: BMP180

Connections:
GND: C1.2, C2.2, C3.C (-), JP1.3, U1.7 (GND)
unnamed: R1.2, SJ1.3
unnamed: R2.2, SJ1.1
SCL: JP1.4, R2.1, U1.5 (SCL)
SDA: JP1.5, R1.1, U1.6 (SDA)
VDD: C1.1, C3.A (+), JP1.2, SJ2.1, U1.2 (VDD)
VDDIO: C2.1, JP1.1, SJ1.2, SJ2.2, U1.3 (VDDIO)

Notes on the sheet:
M Grusin
SHORT BOTH SIDES OF SJ1
TO ENABLE PULL-UP RESISTORS
ON I2C LINES
SHORT SJ2 TO CONNECT VDD
AND VDDIO TOGETHER
1.0
Production note: DO NOT WASH
See https://github.com/sparkfun/BMP180_Breakout for source files and example code

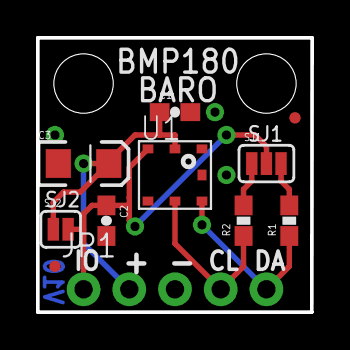
[picture p322: board SparkFun_BMP180_Breakout.brd from above]

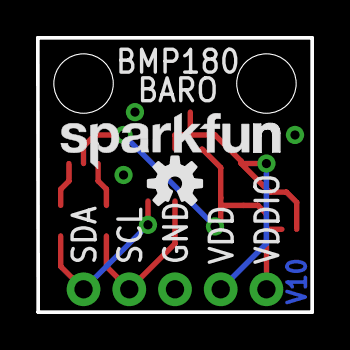
[picture p323: board SparkFun_BMP180_Breakout.brd from below]

Board: 2 copper layers, 15.2 x 15.2 mm, 16 parts (2 on the bottom side), 7 nets.
