DrBalf/domotique_bts_sn_ec_projet/Materiels/Aurelien/test_unitaire/thermometre/BMP180_Breakout-master/Production/BMP180-Breakout-Panel-v10.brd

## EAGLE design Materiels/Aurelien/test_unitaire/thermometre/BMP180_Breakout-master/Production/BMP180-Breakout-Panel-v10.brd (2018-01-29)

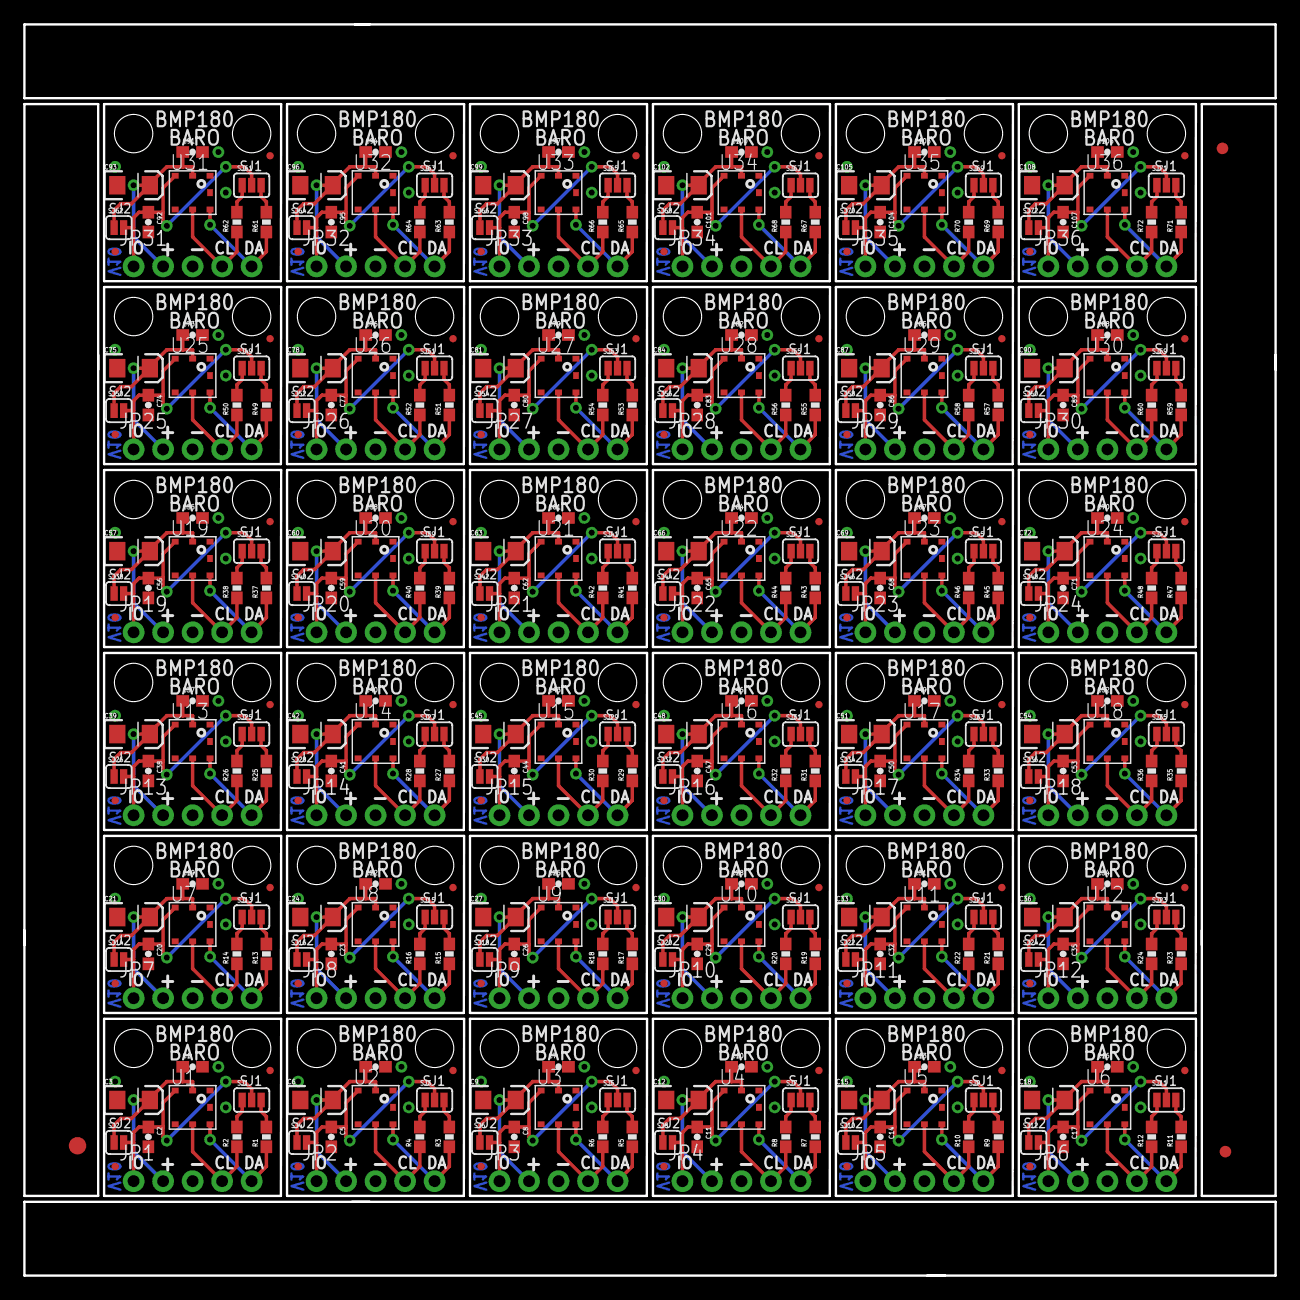
[picture p324: board BMP180-Breakout-Panel-v10.brd from above]

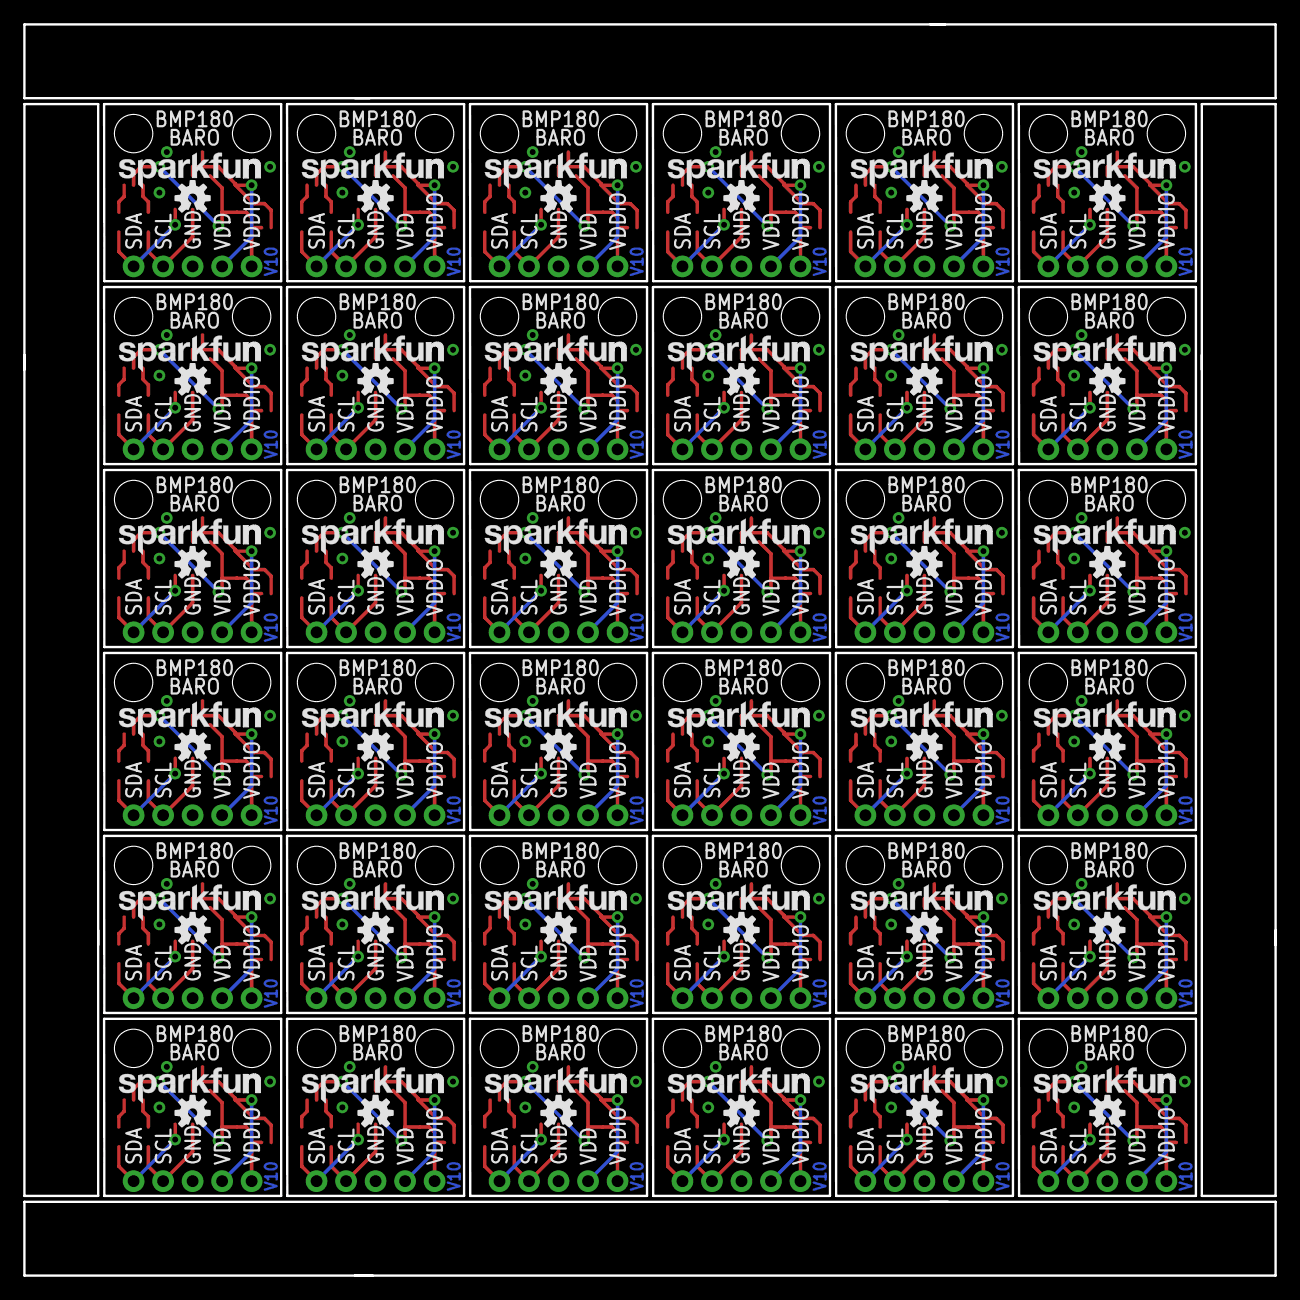
[picture p325: board BMP180-Breakout-Panel-v10.brd from below]

Board: 2 copper layers, 107.7 x 107.7 mm, 543 parts (72 on the bottom side), 252 nets.

Parts:
C1, C2, C4, C5, C7, C8, C10, C11, C13, C14, C16, C17, C19, C20, C22, C23, C25, C26, C28, C29, C31, C32, C34, C35, C37, C38, C40, C41, C43, C44, C46, C47, C49, C50, C52, C53, C55, C56, C58, C59, C61, C62, C64, C65, C67, C68, C70, C71, C73, C74, C76, C77, C79, C80, C82, C83, C85, C86, C88, C89, C91, C92, C94, C95, C97, C98, C100, C101, C103, C104, C106, C107: 0.1uF; 0603-CAP
C3, C6, C9, C12, C15, C18, C21, C24, C27, C30, C33, C36, C39, C42, C45, C48, C51, C54, C57, C60, C63, C66, C69, C72, C75, C78, C81, C84, C87, C90, C93, C96, C99, C102, C105, C108: 10uF; EIA3216
E$1: FIDUCIAL-1.5X3
E$4, E$8: FIDUCIAL-1X2
FID1, FID2, FID3, FID4, FID5, FID6, FID7, FID8, FID9, FID10, FID11, FID12, FID13, FID14, FID15, FID16, FID17, FID18, FID19, FID20, FID21, FID22, FID23, FID24, FID25, FID26, FID27, FID28, FID29, FID30, FID31, FID32, FID33, FID34, FID35, FID36, FID37, FID38, FID39, FID40, FID41, FID42, FID43, FID44, FID45, FID46, FID47, FID48, FID49, FID50, FID51, FID52, FID53, FID54, FID55, FID56, FID57, FID58, FID59, FID60, FID61, FID62, FID63, FID64, FID65, FID66, FID67, FID68, FID69, FID70, FID71, FID72: FIDUCIALUFIDUCIAL; MICRO-FIDUCIAL
JP1, JP2, JP3, JP4, JP5, JP6, JP7, JP8, JP9, JP10, JP11, JP12, JP13, JP14, JP15, JP16, JP17, JP18, JP19, JP20, JP21, JP22, JP23, JP24, JP25, JP26, JP27, JP28, JP29, JP30, JP31, JP32, JP33, JP34, JP35, JP36: 1X05_ROUNDONLY_NOSILK
LOGO1, LOGO3, LOGO5, LOGO7, LOGO9, LOGO11, LOGO13, LOGO15, LOGO17, LOGO19, LOGO21, LOGO23, LOGO25, LOGO27, LOGO29, LOGO31, LOGO33, LOGO35, LOGO37, LOGO39, LOGO41, LOGO43, LOGO45, LOGO47, LOGO49, LOGO51, LOGO53, LOGO55, LOGO57, LOGO59, LOGO61, LOGO63, LOGO65, LOGO67, LOGO69, LOGO71: LOGO-SFENW2; SFE-NEW-WEB
LOGO2, LOGO4, LOGO6, LOGO8, LOGO10, LOGO12, LOGO14, LOGO16, LOGO18, LOGO20, LOGO22, LOGO24, LOGO26, LOGO28, LOGO30, LOGO32, LOGO34, LOGO36, LOGO38, LOGO40, LOGO42, LOGO44, LOGO46, LOGO48, LOGO50, LOGO52, LOGO54, LOGO56, LOGO58, LOGO60, LOGO62, LOGO64, LOGO66, LOGO68, LOGO70, LOGO72: OSHW-LOGOS; OSHW-LOGO-S
R1, R2, R3, R4, R5, R6, R7, R8, R9, R10, R11, R12, R13, R14, R15, R16, R17, R18, R19, R20, R21, R22, R23, R24, R25, R26, R27, R28, R29, R30, R31, R32, R33, R34, R35, R36, R37, R38, R39, R40, R41, R42, R43, R44, R45, R46, R47, R48, R49, R50, R51, R52, R53, R54, R55, R56, R57, R58, R59, R60, R61, R62, R63, R64, R65, R66, R67, R68, R69, R70, R71, R72: 4.7K; 0603-RES
SJ1, SJ3, SJ5, SJ7, SJ9, SJ11, SJ13, SJ15, SJ17, SJ19, SJ21, SJ23, SJ25, SJ27, SJ29, SJ31, SJ33, SJ35, SJ37, SJ39, SJ41, SJ43, SJ45, SJ47, SJ49, SJ51, SJ53, SJ55, SJ57, SJ59, SJ61, SJ63, SJ65, SJ67, SJ69, SJ71: SJ_3_PASTE1&2&3
SJ2, SJ4, SJ6, SJ8, SJ10, SJ12, SJ14, SJ16, SJ18, SJ20, SJ22, SJ24, SJ26, SJ28, SJ30, SJ32, SJ34, SJ36, SJ38, SJ40, SJ42, SJ44, SJ46, SJ48, SJ50, SJ52, SJ54, SJ56, SJ58, SJ60, SJ62, SJ64, SJ66, SJ68, SJ70, SJ72: SJ_2S
STANDOFF1, STANDOFF2, STANDOFF3, STANDOFF4, STANDOFF5, STANDOFF6, STANDOFF7, STANDOFF8, STANDOFF9, STANDOFF10, STANDOFF11, STANDOFF12, STANDOFF13, STANDOFF14, STANDOFF15, STANDOFF16, STANDOFF17, STANDOFF18, STANDOFF19, STANDOFF20, STANDOFF21, STANDOFF22, STANDOFF23, STANDOFF24, STANDOFF25, STANDOFF26, STANDOFF27, STANDOFF28, STANDOFF29, STANDOFF30, STANDOFF31, STANDOFF32, STANDOFF33, STANDOFF34, STANDOFF35, STANDOFF36, STANDOFF37, STANDOFF38, STANDOFF39, STANDOFF40, STANDOFF41, STANDOFF42, STANDOFF43, STANDOFF44, STANDOFF45, STANDOFF46, STANDOFF47, STANDOFF48, STANDOFF49, STANDOFF50, STANDOFF51, STANDOFF52, STANDOFF53, STANDOFF54, STANDOFF55, STANDOFF56, STANDOFF57, STANDOFF58, STANDOFF59, STANDOFF60, STANDOFF61, STANDOFF62, STANDOFF63, STANDOFF64, STANDOFF65, STANDOFF66, STANDOFF67, STANDOFF68, STANDOFF69, STANDOFF70, STANDOFF71, STANDOFF72: STAND-OFF
U1, U2, U3, U4, U5, U6, U7, U8, U9, U10, U11, U12, U13, U14, U15, U16, U17, U18, U19, U20, U21, U22, U23, U24, U25, U26, U27, U28, U29, U30, U31, U32, U33, U34, U35, U36: BMP180

Connections:
GND: C1.2, C2.2, C3.C, JP1.3, U1.7
GND1: C4.2, C5.2, C6.C, JP2.3, U2.7
GND2: C7.2, C8.2, C9.C, JP3.3, U3.7
GND3: C10.2, C11.2, C12.C, JP4.3, U4.7
GND4: C13.2, C14.2, C15.C, JP5.3, U5.7
GND5: C16.2, C17.2, C18.C, JP6.3, U6.7
GND6: C19.2, C20.2, C21.C, JP7.3, U7.7
GND7: C22.2, C23.2, C24.C, JP8.3, U8.7
GND8: C25.2, C26.2, C27.C, JP9.3, U9.7
GND9: C28.2, C29.2, C30.C, JP10.3, U10.7
GND10: C31.2, C32.2, C33.C, JP11.3, U11.7
GND11: C34.2, C35.2, C36.C, JP12.3, U12.7
GND12: C37.2, C38.2, C39.C, JP13.3, U13.7
GND13: C40.2, C41.2, C42.C, JP14.3, U14.7
GND14: C43.2, C44.2, C45.C, JP15.3, U15.7
GND15: C46.2, C47.2, C48.C, JP16.3, U16.7
GND16: C49.2, C50.2, C51.C, JP17.3, U17.7
GND17: C52.2, C53.2, C54.C, JP18.3, U18.7
GND18: C55.2, C56.2, C57.C, JP19.3, U19.7
GND19: C58.2, C59.2, C60.C, JP20.3, U20.7
GND20: C61.2, C62.2, C63.C, JP21.3, U21.7
GND21: C64.2, C65.2, C66.C, JP22.3, U22.7
GND22: C67.2, C68.2, C69.C, JP23.3, U23.7
GND23: C70.2, C71.2, C72.C, JP24.3, U24.7
GND24: C73.2, C74.2, C75.C, JP25.3, U25.7
GND25: C76.2, C77.2, C78.C, JP26.3, U26.7
GND26: C79.2, C80.2, C81.C, JP27.3, U27.7
GND27: C82.2, C83.2, C84.C, JP28.3, U28.7
GND28: C85.2, C86.2, C87.C, JP29.3, U29.7
GND29: C88.2, C89.2, C90.C, JP30.3, U30.7
GND30: C91.2, C92.2, C93.C, JP31.3, U31.7
GND31: C94.2, C95.2, C96.C, JP32.3, U32.7
GND32: C97.2, C98.2, C99.C, JP33.3, U33.7
GND33: C100.2, C101.2, C102.C, JP34.3, U34.7
GND34: C103.2, C104.2, C105.C, JP35.3, U35.7
GND35: C106.2, C107.2, C108.C, JP36.3, U36.7
unnamed: R1.2, SJ1.3
unnamed: R2.2, SJ1.1
unnamed: R3.2, SJ3.3
unnamed: R4.2, SJ3.1
unnamed: R5.2, SJ5.3
unnamed: R6.2, SJ5.1
unnamed: R7.2, SJ7.3
unnamed: R8.2, SJ7.1
unnamed: R9.2, SJ9.3
unnamed: R10.2, SJ9.1
unnamed: R11.2, SJ11.3
unnamed: R12.2, SJ11.1
unnamed: R13.2, SJ13.3
unnamed: R14.2, SJ13.1
unnamed: R15.2, SJ15.3
unnamed: R16.2, SJ15.1
unnamed: R17.2, SJ17.3
unnamed: R18.2, SJ17.1
unnamed: R19.2, SJ19.3
unnamed: R20.2, SJ19.1
unnamed: R21.2, SJ21.3
unnamed: R22.2, SJ21.1
unnamed: R23.2, SJ23.3
unnamed: R24.2, SJ23.1
unnamed: R25.2, SJ25.3
unnamed: R26.2, SJ25.1
unnamed: R27.2, SJ27.3
unnamed: R28.2, SJ27.1
unnamed: R29.2, SJ29.3
unnamed: R30.2, SJ29.1
unnamed: R31.2, SJ31.3
unnamed: R32.2, SJ31.1
unnamed: R33.2, SJ33.3
unnamed: R34.2, SJ33.1
unnamed: R35.2, SJ35.3
unnamed: R36.2, SJ35.1
unnamed: R37.2, SJ37.3
unnamed: R38.2, SJ37.1
unnamed: R39.2, SJ39.3
unnamed: R40.2, SJ39.1
unnamed: R41.2, SJ41.3
unnamed: R42.2, SJ41.1
unnamed: R43.2, SJ43.3
unnamed: R44.2, SJ43.1
unnamed: R45.2, SJ45.3
unnamed: R46.2, SJ45.1
unnamed: R47.2, SJ47.3
unnamed: R48.2, SJ47.1
unnamed: R49.2, SJ49.3
unnamed: R50.2, SJ49.1
unnamed: R51.2, SJ51.3
unnamed: R52.2, SJ51.1
unnamed: R53.2, SJ53.3
unnamed: R54.2, SJ53.1
unnamed: R55.2, SJ55.3
unnamed: R56.2, SJ55.1
unnamed: R57.2, SJ57.3
unnamed: R58.2, SJ57.1
unnamed: R59.2, SJ59.3
unnamed: R60.2, SJ59.1
unnamed: R61.2, SJ61.3
unnamed: R62.2, SJ61.1
unnamed: R63.2, SJ63.3
unnamed: R64.2, SJ63.1
unnamed: R65.2, SJ65.3
unnamed: R66.2, SJ65.1
unnamed: R67.2, SJ67.3
unnamed: R68.2, SJ67.1
unnamed: R69.2, SJ69.3
unnamed: R70.2, SJ69.1
unnamed: R71.2, SJ71.3
unnamed: R72.2, SJ71.1
SCL: JP1.4, R2.1, U1.5
SCL1: JP2.4, R4.1, U2.5
SCL2: JP3.4, R6.1, U3.5
SCL3: JP4.4, R8.1, U4.5
SCL4: JP5.4, R10.1, U5.5
SCL5: JP6.4, R12.1, U6.5
SCL6: JP7.4, R14.1, U7.5
SCL7: JP8.4, R16.1, U8.5
SCL8: JP9.4, R18.1, U9.5
SCL9: JP10.4, R20.1, U10.5
SCL10: JP11.4, R22.1, U11.5
SCL11: JP12.4, R24.1, U12.5
SCL12: JP13.4, R26.1, U13.5
SCL13: JP14.4, R28.1, U14.5
SCL14: JP15.4, R30.1, U15.5
SCL15: JP16.4, R32.1, U16.5
SCL16: JP17.4, R34.1, U17.5
SCL17: JP18.4, R36.1, U18.5
SCL18: JP19.4, R38.1, U19.5
SCL19: JP20.4, R40.1, U20.5
SCL20: JP21.4, R42.1, U21.5
SCL21: JP22.4, R44.1, U22.5
SCL22: JP23.4, R46.1, U23.5
SCL23: JP24.4, R48.1, U24.5
SCL24: JP25.4, R50.1, U25.5
SCL25: JP26.4, R52.1, U26.5
SCL26: JP27.4, R54.1, U27.5
SCL27: JP28.4, R56.1, U28.5
SCL28: JP29.4, R58.1, U29.5
SCL29: JP30.4, R60.1, U30.5
SCL30: JP31.4, R62.1, U31.5
SCL31: JP32.4, R64.1, U32.5
SCL32: JP33.4, R66.1, U33.5
SCL33: JP34.4, R68.1, U34.5
SCL34: JP35.4, R70.1, U35.5
SCL35: JP36.4, R72.1, U36.5
SDA: JP1.5, R1.1, U1.6
SDA1: JP2.5, R3.1, U2.6
SDA2: JP3.5, R5.1, U3.6
SDA3: JP4.5, R7.1, U4.6
SDA4: JP5.5, R9.1, U5.6
SDA5: JP6.5, R11.1, U6.6
SDA6: JP7.5, R13.1, U7.6
SDA7: JP8.5, R15.1, U8.6
SDA8: JP9.5, R17.1, U9.6
SDA9: JP10.5, R19.1, U10.6
SDA10: JP11.5, R21.1, U11.6
SDA11: JP12.5, R23.1, U12.6
SDA12: JP13.5, R25.1, U13.6
SDA13: JP14.5, R27.1, U14.6
SDA14: JP15.5, R29.1, U15.6
SDA15: JP16.5, R31.1, U16.6
SDA16: JP17.5, R33.1, U17.6
SDA17: JP18.5, R35.1, U18.6
SDA18: JP19.5, R37.1, U19.6
SDA19: JP20.5, R39.1, U20.6
SDA20: JP21.5, R41.1, U21.6
SDA21: JP22.5, R43.1, U22.6
SDA22: JP23.5, R45.1, U23.6
SDA23: JP24.5, R47.1, U24.6
SDA24: JP25.5, R49.1, U25.6
SDA25: JP26.5, R51.1, U26.6
SDA26: JP27.5, R53.1, U27.6
SDA27: JP28.5, R55.1, U28.6
SDA28: JP29.5, R57.1, U29.6
SDA29: JP30.5, R59.1, U30.6
SDA30: JP31.5, R61.1, U31.6
SDA31: JP32.5, R63.1, U32.6
SDA32: JP33.5, R65.1, U33.6
SDA33: JP34.5, R67.1, U34.6
SDA34: JP35.5, R69.1, U35.6
SDA35: JP36.5, R71.1, U36.6
VDD: C1.1, C3.A, JP1.2, SJ2.1, U1.2
VDD1: C4.1, C6.A, JP2.2, SJ4.1, U2.2
VDD2: C7.1, C9.A, JP3.2, SJ6.1, U3.2
VDD3: C10.1, C12.A, JP4.2, SJ8.1, U4.2
VDD4: C13.1, C15.A, JP5.2, SJ10.1, U5.2
VDD5: C16.1, C18.A, JP6.2, SJ12.1, U6.2
VDD6: C19.1, C21.A, JP7.2, SJ14.1, U7.2
VDD7: C22.1, C24.A, JP8.2, SJ16.1, U8.2
VDD8: C25.1, C27.A, JP9.2, SJ18.1, U9.2
VDD9: C28.1, C30.A, JP10.2, SJ20.1, U10.2
VDD10: C31.1, C33.A, JP11.2, SJ22.1, U11.2
VDD11: C34.1, C36.A, JP12.2, SJ24.1, U12.2
VDD12: C37.1, C39.A, JP13.2, SJ26.1, U13.2
VDD13: C40.1, C42.A, JP14.2, SJ28.1, U14.2
VDD14: C43.1, C45.A, JP15.2, SJ30.1, U15.2
VDD15: C46.1, C48.A, JP16.2, SJ32.1, U16.2
VDD16: C49.1, C51.A, JP17.2, SJ34.1, U17.2
VDD17: C52.1, C54.A, JP18.2, SJ36.1, U18.2
VDD18: C55.1, C57.A, JP19.2, SJ38.1, U19.2
VDD19: C58.1, C60.A, JP20.2, SJ40.1, U20.2
VDD20: C61.1, C63.A, JP21.2, SJ42.1, U21.2
VDD21: C64.1, C66.A, JP22.2, SJ44.1, U22.2
VDD22: C67.1, C69.A, JP23.2, SJ46.1, U23.2
VDD23: C70.1, C72.A, JP24.2, SJ48.1, U24.2
VDD24: C73.1, C75.A, JP25.2, SJ50.1, U25.2
VDD25: C76.1, C78.A, JP26.2, SJ52.1, U26.2
VDD26: C79.1, C81.A, JP27.2, SJ54.1, U27.2
VDD27: C82.1, C84.A, JP28.2, SJ56.1, U28.2
VDD28: C85.1, C87.A, JP29.2, SJ58.1, U29.2
VDD29: C88.1, C90.A, JP30.2, SJ60.1, U30.2
VDD30: C91.1, C93.A, JP31.2, SJ62.1, U31.2
VDD31: C94.1, C96.A, JP32.2, SJ64.1, U32.2
VDD32: C97.1, C99.A, JP33.2, SJ66.1, U33.2
VDD33: C100.1, C102.A, JP34.2, SJ68.1, U34.2
VDD34: C103.1, C105.A, JP35.2, SJ70.1, U35.2
VDD35: C106.1, C108.A, JP36.2, SJ72.1, U36.2
VDDIO: C2.1, JP1.1, SJ1.2, SJ2.2, U1.3
VDDIO1: C5.1, JP2.1, SJ3.2, SJ4.2, U2.3
VDDIO2: C8.1, JP3.1, SJ5.2, SJ6.2, U3.3
VDDIO3: C11.1, JP4.1, SJ7.2, SJ8.2, U4.3
VDDIO4: C14.1, JP5.1, SJ9.2, SJ10.2, U5.3
VDDIO5: C17.1, JP6.1, SJ11.2, SJ12.2, U6.3
VDDIO6: C20.1, JP7.1, SJ13.2, SJ14.2, U7.3
VDDIO7: C23.1, JP8.1, SJ15.2, SJ16.2, U8.3
VDDIO8: C26.1, JP9.1, SJ17.2, SJ18.2, U9.3
VDDIO9: C29.1, JP10.1, SJ19.2, SJ20.2, U10.3
VDDIO10: C32.1, JP11.1, SJ21.2, SJ22.2, U11.3
VDDIO11: C35.1, JP12.1, SJ23.2, SJ24.2, U12.3
VDDIO12: C38.1, JP13.1, SJ25.2, SJ26.2, U13.3
VDDIO13: C41.1, JP14.1, SJ27.2, SJ28.2, U14.3
VDDIO14: C44.1, JP15.1, SJ29.2, SJ30.2, U15.3
VDDIO15: C47.1, JP16.1, SJ31.2, SJ32.2, U16.3
VDDIO16: C50.1, JP17.1, SJ33.2, SJ34.2, U17.3
VDDIO17: C53.1, JP18.1, SJ35.2, SJ36.2, U18.3
VDDIO18: C56.1, JP19.1, SJ37.2, SJ38.2, U19.3
VDDIO19: C59.1, JP20.1, SJ39.2, SJ40.2, U20.3
VDDIO20: C62.1, JP21.1, SJ41.2, SJ42.2, U21.3
VDDIO21: C65.1, JP22.1, SJ43.2, SJ44.2, U22.3
VDDIO22: C68.1, JP23.1, SJ45.2, SJ46.2, U23.3
VDDIO23: C71.1, JP24.1, SJ47.2, SJ48.2, U24.3
VDDIO24: C74.1, JP25.1, SJ49.2, SJ50.2, U25.3
VDDIO25: C77.1, JP26.1, SJ51.2, SJ52.2, U26.3
VDDIO26: C80.1, JP27.1, SJ53.2, SJ54.2, U27.3
VDDIO27: C83.1, JP28.1, SJ55.2, SJ56.2, U28.3
VDDIO28: C86.1, JP29.1, SJ57.2, SJ58.2, U29.3
VDDIO29: C89.1, JP30.1, SJ59.2, SJ60.2, U30.3
VDDIO30: C92.1, JP31.1, SJ61.2, SJ62.2, U31.3
VDDIO31: C95.1, JP32.1, SJ63.2, SJ64.2, U32.3
VDDIO32: C98.1, JP33.1, SJ65.2, SJ66.2, U33.3
VDDIO33: C101.1, JP34.1, SJ67.2, SJ68.2, U34.3
VDDIO34: C104.1, JP35.1, SJ69.2, SJ70.2, U35.3
VDDIO35: C107.1, JP36.1, SJ71.2, SJ72.2, U36.3
