DrBalf/domotique_bts_sn_ec_projet/Logiciels/Bluetooth/Configuration_Bluetooth_Uno/Configuration_Bluetooth_Uno.ino

void setup()
{
  Serial.begin(9600);
  Serial.print("Enter AT commands:");
  Serial3.begin(9600);
  pinMode(9, OUTPUT);  // this pin will pull the HC-05 pin 34 (key pin) HIGH to switch module to AT mode
  digitalWrite(9,HIGH);
}
 
void loop()
{
 
  // Read from HC-05 and send it to Arduino Serial Monitor


  if (Serial1.available() > 0)
  {
    Serial.write(Serial1.read());
  }
 
  // Read from Arduino Serial Monitor and send to HC-05
  if (Serial.available())
  {
    Serial1.write(Serial.read());
  }
}
