DrBalf/domotique_bts_sn_ec_projet/Materiels/Benjamin/CapteurLumi/testlumiv2/testlumiv2.ino

#include <Wire.h>
#include <Adafruit_Sensor.h>
#include <Adafruit_TSL2561_U.h>

   
Adafruit_TSL2561_Unified tsl = Adafruit_TSL2561_Unified(TSL2561_ADDR_FLOAT, 12345);



void setup(void) 
{
  Serial.begin(9600);
  
  /* Initialise the sensor */
  //use tsl.begin() to default to Wire, 
  //tsl.begin(&Wire2) directs api to use Wire2, etc.
  if(!tsl.begin())
  {
    /* There was a problem detecting the TSL2561 ... check your connections */
    Serial.print("Ooops, no TSL2561 detected ... Check your wiring or I2C ADDR!");
    while(1);
  }
  
  /* We're ready to go! */
  Serial.println("");
}

void loop(void) 
{  
  /* Get a new sensor event */ 
  sensors_event_t event;
  tsl.getEvent(&event);
 
  /* Display the results (light is measured in lux) */
  if (event.light)
  {
    Serial.println("La luminosité est de : ");
    Serial.print(event.light); Serial.println(" lux");
  }
  else
  {
    /* If event.light = 0 lux the sensor is probably saturated
       and no reliable data could be generated! */
    Serial.println("Sensor overload");
  }
  delay(250);
}
