DrBalf/domotique_bts_sn_ec_projet/Materiels/Aurelien/test_unitaire/module_RTC/module_rtc/module_rtc.ino

#include <Wire.h>
#include <RTClib.h>

RTC_DS1307 rtc;

char daysOfTheWeek[7][12] = {"Lundi", "Mardi", "Mercredi", "Jeudi", "Vendredi", "Samedi", "Dimanche"};

void setup() {
  Serial.begin(9600);
  if (! rtc.begin()) {
    Serial.println("Couldn't find RTC");
    while (1);
  }

  if (! rtc.isrunning()) {
    Serial.println("RTC is NOT running!");
    // following line sets the RTC to the date & time this sketch was compiled
    // rtc.adjust(DateTime(F(__DATE__), F(__TIME__)));
    // This line sets the RTC with an explicit date & time, for example to set
    // January 21, 2014 at 3am you would call:
    rtc.adjust(DateTime(2018, 02, 1, 11, 43, 0));
  }
  rtc.adjust(DateTime(2018, 05, 31, 10, 47, 0));
}

void loop() {
   DateTime now = rtc.now();

      //affichage de la date 
      Serial.print(now.year(), DEC);
      Serial.print('/');
      Serial.print(now.month(), DEC);
      Serial.print('/');
      Serial.print(now.day(), DEC);
      Serial.print(" (");
      Serial.print(daysOfTheWeek[now.dayOfTheWeek()]);
      Serial.print(") ");
      //affichage de l'heure
      Serial.print(now.hour(), DEC);
      Serial.print(':');
      Serial.print(now.minute(), DEC);
      Serial.print(':');
      Serial.print(now.second(), DEC);
      Serial.println();

      delay(1000);
}
