DrBalf/domotique_bts_sn_ec_projet/(commit log)

2018-01-08 Maj 08/01/2018 organisation Signed-off-by: DrBlaf <chauveau.aurelien.76@gmail.com>
    [OldWiki-NewWiki-Mapping.csv]
2018-01-29 MAJ 19/01/2018 Signed-off-by: DrBlaf <chauveau.aurelien.76@gmail.com>
    [BMP180-Breakout-Panel-v10.brd, SparkFun_BMP180_Breakout.brd, SparkFun_BMP180_Breakout.sch]
2018-02-21 MAJ Benjamin est triste nous sommes le 21/02/2018 peut etre demain ira t il mieux Signed-off-by: DrBlaf <chauveau.aurelien.76@gmail.com>
2018-03-14 MAJ 14/03/2018 Signed-off-by: DrBlaf <chauveau.aurelien.76@gmail.com>
    [AQ_T_H_R.fzz, RTC_SSD_CE.fzz, confort.fzz]
2018-04-12 MAJ 12/04/2018 Signed-off-by: DrBlaf <chauveau.aurelien.76@gmail.com>
    [Montage_ArduinoMega_Bluetooth.fzz]
2018-04-17 MAJ 17/04/2018 Signed-off-by: DrBlaf <chauveau.aurelien.76@gmail.com>
    [regroupement_final.fzz]
2018-04-23 MAJ 23/04/2018 Signed-off-by: DrBlaf <chauveau.aurelien.76@gmail.com>
    [regroupement.fzz]
2018-04-25 MAJ 25/04/2018 Signed-off-by: DrBlaf <chauveau.aurelien.76@gmail.com>
    [regroupement_final_final.fzz]
2018-05-23 MAJ 23/05/2018 Signed-off-by: DrBlaf <chauveau.aurelien.76@gmail.com>
    [Untitled Sketch.fzz, smokedete.fzz]
